jeffersonpimenta/firmware/docs/superpowers/plans/2026-07-11-irrigacao-roadmap.md

# Irrigação LoRa Mesh — Roadmap de implementação

Spec: `myfork/especificacao-irrigacao-mesh.md` (v0.1). Spec cobre múltiplos subsistemas independentes; cada fase abaixo vira um plano próprio e entrega software funcional e testável sozinho.

| Fase | Escopo (seções da spec) | Plano |
|---|---|---|
| 1 | Núcleo do protocolo + estação fail-safe: mensagens binárias no portnum privado, anti-replay, rate limit, ValveController com timer local, ACK, heartbeat, role em settings (§3.1, §3.2, §4) | `2026-07-11-irrigacao-fase1-nucleo.md` |
| 2 | Persistência NVS atômica, epoch de config, `SET_CONFIG`/`GET_CONFIG` fragmentável, regra do maior epoch, modo seguro (§5) | concluída (2026-07-12, plano 2026-07-11-irrigacao-fase2-config.md; regra do maior epoch movida p/ Fase 4 — lado gateway) |
| 3 | Pareamento, vínculo nó↔gateway, allowlist, reset de fábrica, botão multifunção, LED de status (§6, §8.6, §8.7) | concluída (2026-07-12, plano 2026-07-12-irrigacao-fase3-pareamento.md; aprovação física no gateway antecipa o painel da Fase 5; PSK de canal não é apagada no reset de fábrica — limitação até a Fase 5) |
| 4 | Gateway: registro de estações, zonas, programas/cronograma, retries de ACK, alertas (bateria, estação muda, reboots) (§5.2–§5.3, §8.1–§8.3) | concluída (2026-07-13, plano 2026-07-12-irrigacao-fase4-gateway.md; edição de zonas/programas/espelho via UI chega na Fase 5; intertravamentos na Fase 6; máquina guiada por ACK na Fase 7) |
| 5 | Painel web do gateway + captive portal de campo (LittleFS, endpoints JSON) (§7) | concluída (5a painel gateway 2026-07-15, plano 2026-07-15-irrigacao-fase5a-painel-gateway.md; 5b portal de campo 2026-07-17, plano 2026-07-17-irrigacao-fase5b-portal-no.md; aba Instalador §8.4 cortada — firmware separado) |
| 6 | Sensores, intertravamentos (global + réplica local), GPO, tamper, log de auditoria (§8.9–§8.12) | dividida em 6a/6b — **concluída**. **6a (estação)** concluída (2026-07-21, plano 2026-07-20-irrigacao-fase6a-estacao.md): settings ABI v4 (sensores/GPO/tamper/coords), SensorSampler, GpoController, AuditLog + mini-log persistente, heartbeat com bloco de sensores + envio antecipado, EV_TAMPER, endpoints/UI do portal. **6b (gateway)** concluída (2026-07-23, plano 2026-07-22-irrigacao-fase6b-gateway.md): settings ABI v5 (réplica local via blob 176B/push §5.4), InterlockEngine (veredito por zona + histerese) + InterlockTable, OpenGate (gate de admissão + fila FIFO, scheduler sequencial), FlashAuditRing persistente ~256KB (CSV/JSON export), SensorNameTable (gateway-side, não empurrado), janela de manutenção via CMD_MAINT, UI do painel (abas Sensores/GPO/Intertravamentos/Log/Tamper). Backup de config completo com PSK adiado. **Follow-up conhecido**: create de item novo no painel envia id=0 (rejeitado pelo backend) — corrigido em intertravamentos (id livre no cliente); zonas/programas têm a mesma limitação pré-existente |
| 7 | Grupos hidráulicos (máquina de estados bomba/válvulas, matriz de falhas) (§8.13) | dividida em 7a/7b. **7a (motor) concluída** (2026-07-24, spec 2026-07-24-irrigacao-fase7a-grupos-hidraulicos-design.md, plano 2026-07-24-irrigacao-fase7a-grupos-hidraulicos.md): `HydraulicGroupTable` (config + persistência LittleFS própria), `HydraulicGroupEngine` (máquina guiada por ACK: abrir/fechar sequenciado com bomba, `abrir_antes_de_fechar`/`fechar_antes_de_abrir`, min/max abertas, renovação da bomba, matriz de falhas §8.13, bridging `funcionamento_min_min`, `max_partidas_hora`→DEFERRED, grupo-sem-bomba == simultaneidade §8.10, reconciliação por heartbeat), glue no `gwTick` (roteamento de zonas agrupadas via `setDesired`, dispatch de emits, `onAck`/`onCmdFailed`/`observeActual`), `AuditOrigin::GRUPO_HIDRAULICO`. Suite nativa 54→56 (2 suites novos). Sem mudança na ABI de estação (bomba = zona gpo). **7b (painel/roteamento) concluída** (2026-07-24, spec 2026-07-24-irrigacao-fase7b-grupos-web-design.md, plano 2026-07-24-irrigacao-fase7b-grupos-web.md): endpoints `/api/irrigation/groups[/status|/delete|/command]` + aba "Grupos" do painel (CRUD + status ao vivo + controle manual abrir/fechar); validação de zona-membro (`validateGroupZones` puro: rejeita espelho `fonteInput>=0`, zona inexistente, bomba-membro); roteamento único `routeZoneToGroup` (grupo isento do cap global `IL_SIMULTANEIDADE` — Opção A; corrige open-direto-sem-bomba nos caminhos manual/portal, antes só o scheduler era group-aware); create `id=0` aloca id livre no servidor. Export/backup de grupos ADIADO p/ Fase 8. Suite nativa mantém 56 (casos novos em `test_irrigation_webapi` 43→59 e `test_hydraulic_group_engine` 13→14; `IrrigationWebEndpoints.cpp` é CI-only). **Follow-ups Minor** (hardening de teste, tidy de front) em `.superpowers/sdd/progress.md`. |
| 8 | Role SERVICO: cofre LittleFS, re-tune de canal, varredura, `RESYNC_SEQ`, import/export; survey (§8.5, §11) | dividida em 8a/8b/8c/8d (brainstorming 2026-07-25, spec `2026-07-25-irrigacao-fase8a-protocolo-parque-design.md`). **8a (pré-req de protocolo no parque) concluída** (2026-07-25, plano `2026-07-25-irrigacao-fase8a-protocolo-parque.md`, head `a93edca1c`): `FLAG_FROM_SERVICE`+`setServiceFlag`, predicado puro `senderAuthorizedBy` (SERVICE_MAGIC dispensa vínculo §11.5), codec `RESYNC_SEQ`+`PING_SURVEY`+`APP_FW_VERSION`, `senderAuthorized(from,flags)` nos 5 sítios de comando, responders `handleResyncSeq` (isento do gate anti-replay) + `handlePingSurvey` (nodeinfo mínimo, todos papéis) + dispatch. Aditivo: protocolo VERSION=1 e ABI settings v5 intactos; `SeqTable` fica RAM-only (posse-da-PSK=autoridade). Suíte nativa 865/865 GREEN (+7 casos; sem suite nova). **Banca 2+ nós exigida antes de campo** (rádio não é native-testável). Maior-epoch + last_seq per-sender de §11.9 já prontos de fases anteriores. **8b (device SERVICO núcleo) concluída** (2026-07-25, spec+plano `2026-07-25-irrigacao-fase8b-device-servico-nucleo*`, head `8e99b4fb0`, pushed): cofre LittleFS (`ServiceBackup` codec §5.5 + base64 + scanner JSON, `ServiceVault` sobre `IProfileStore`/`LittleFsProfileStore`), `ServiceController` (channelFromProfile/decideConfigRoute/needsResync/scan + orquestração planRetune/nextSeq/onResyncReply), glue no módulo (`applyRetune` re-tune+reboot espelha commitPairing, `svcEmitProbe`/`svcSendResyncRequest` com FLAG_FROM_SERVICE, intake de REPLY PING/RESYNC, botão SERVICO=export console), export §5.5 do gateway (PSK+tabelas via `gwBuildBackup`) em `GET /api/irrigation/export`+botão painel. 3 suites nativas novas (backup/vault/controller), suíte completa **897/897 GREEN**. IMPORT via portal/SD ADIADO→8c; banca 2+ nós exigida. **8c (portal do device SERVICO §11.8) concluída** (2026-07-25, spec+plano `2026-07-25-irrigacao-fase8c-portal-device*`): camada pura `ServicePortalApi` (buildClientList/parseSelect/buildScanResults/**buildStationConfig+parseStationConfig round-trip 176B** = editor de campos completo/parseNodeConfigReq/parseNodeAction/buildServiceLog) em suite nova `test_service_portal`; writer `servico.jsonl` (`IProfileStore.appendLog/logReader`, tail); accessors `svcPortal*` + endpoints CI-only `/api/portal/service/*` (clientes/select re-tune+reboot/scan/ler+gravar config/ação/log/export/import via staging FSCom); frontend 3 abas (Clientes/Rede/Log + editor). **Rota de escrita = DIRECT** (epoch+1, gateway adota via §5.4 max-epoch). **Follow-on**: VIA_GATEWAY (wire não tem config-para-estação-X via gateway) + aprovar-pareamento pelo device (falta intake device-side de PAIR_ANNOUNCE) + cartão-SD + cifra PSK. Aditivo: VERSION=1, ABI v5 intactos. `test_service_portal` 8/8 + árvore compila (Docker). Banca 2+ nós exigida. **8d (site survey §8.5) concluída** (2026-07-25, spec+plano `2026-07-25-irrigacao-fase8d-site-survey*`): beacon `PING_SURVEY` kind=2 (aditivo, VERSION=1/ABI v5 intactos — sem tipo de wire novo), `SurveyBeacon` (intervalo+auto-expiração) + `SurveyLog` (ring RAM 32) puros + `buildSurvey`/`parseSurveyStart`; glue no módulo (tick emite beacon; gateway loga kind=2 com SNR/RSSI+coord; nós não respondem a kind=2 → sem tempestade de airtime); endpoints CI-only `/api/irrigation/survey[/clear]` (painel) + `/api/portal[/service]/survey/{start,stop}` (beacon iniciado pelo portal do nó §7.2 **e** portal SERVICO §11.8); frontend aba "Cobertura" (painel: tabela do log ao vivo) + controle iniciar/parar (portal). Log = RAM transiente; coordenada digitada/opcional. Suíte nativa 60→62 (`test_survey_beacon`/`test_survey_log` + casos em `test_irrigation_webapi`), completa GREEN. **Banca 2+ nós exigida antes de campo** (beacon/log por rádio não é native-testável). **Fase 8 COMPLETA.** §8.4 instalador cortado; modo híbrido 24VAC já em `MirrorMode` (Fase 4) |
| 9 | Particionamento de flash p/ OTA nas variants alvo (§3.3) | futuro |

Regras globais da spec que valem em todas as fases: teto absoluto de abertura 120 min compilado; fail-safe local sempre; payload ≤ ~200 bytes; versão de protocolo em toda mensagem; mismatch = rejeição segura.

Referencia de UI (Fase 5): mockup do painel/portal em `myfork/Irrigacao Mobile.dc.html` (design doc HTML, 2026-07-11) - base visual das telas do painel web e captive portal.

Requisito reforçado pelo usuário (2026-07-11) — modo híbrido/espelho (§5.2 `fonte`): o sistema deve poder operar SOMENTE espelhando as entradas físicas de um controlador externo (réplica das saídas 24VAC lidas por optoacoplador), sem cronograma próprio. Isso deve ser configurável por entrada, incluindo a polaridade do estado ativo (active-high / active-low). Entra na Fase 4 (gateway/zonas) e no pin map da Fase 2 (campo de polaridade por entrada física).

Requisito reforçado pelo usuário (2026-07-12) — modo espelhamento (§5.2 `fonte`, Fase 4): quando ativo, TODA configuração e TODOS os intertravamentos são bypassados — a estação escrava replica cegamente o estado da entrada do mestre. O bypass é configurável pela UI; a UI também permite associar cada entrada do mestre (gateway híbrido, opto 24VAC) a qualquer saída de qualquer escravo (mapeamento entrada→(nó,saída) via dropdown). Polaridade ativo-alto/baixo por entrada (requisito 2026-07-11) continua valendo. Nota de engenharia: o teto fail-safe de 120 min compilado (§4.2) permanece mesmo em espelhamento, salvo decisão explícita do usuário em contrário — a renovação periódica do comando cobre acionamentos longos.

Requisito do usuário (2026-07-12) — exportar chave da fazenda: função de visualizar a PSK do canal primário (base64 + nome do canal) para cadastro no cofre do device de serviço (§11.2). Fase 3: pressão longa no botão do gateway despeja no console serial. Fase 5: mesma função exposta no painel web (com PIN).

Feature adicional (2026-07-30) — **controle de nível por boia (enchimento automático)**: uma boia (sensor digital) num nó controla a partida/parada de um motor/bomba (uma zona) em outro nó ou no GPO do gateway. Aditiva pós-Fase 8 (spec `2026-07-30-irrigacao-controle-nivel-boia-design.md`, plano `2026-07-30-irrigacao-controle-nivel-boia.md`). Nova peça = ação **positiva** (liga quando nível baixo) que o intertravamento — só negativo (bloquear/fechar) — não fazia. Abordagem A: `LevelControlTable` (config + persistência LittleFS própria `irrigation_niveis.dat`) + `LevelControlEngine` puro (máquina start/stop/renew/stale, histerese por tempo minOn/minOff, 1 boia) no gateway, dirigindo o `routeZoneToGroup`/`gwDriveZone` existente (herda sequência de bomba, veto de intertravamento, `max_partidas_hora`). Fail-safe: boia muda > `staleTimeoutS` → desliga + alerta `NIVEL_BOIA_MUDA`; teto 120 min sempre corta; RENEW (60 s) mantém vivo só enquanto quer-encher **e** boia fresca. Codec web + endpoints CI-only `/api/irrigation/levels[/delete]` + aba "Nível" no painel; regras no backup §5.5 (`niveisJson`). Aditivo total: protocolo VERSION=1, ABI settings v5 (176 B) intactos, sem novo tipo de wire; enums append-only `AuditOrigin::NIVEL`/`AlertType::NIVEL_BOIA_MUDA`. 2 suites nativas novas (`test_level_control_table`/`test_level_control`), `native-suite-count` 62→64. **Banca 2+ nós exigida antes de campo** (boia-nó→gateway→bomba-nó, frescor real e endpoints CI/banca-only não são native-testáveis). Fora de escopo (YAGNI): 2 boias / sensor analógico com 2 limiares, modo esvaziar/drenar, controle local sem gateway, cifra PSK. Follow-ups em `.superpowers/sdd/progress.md`.

Feature adicional (2026-08-08) — **Modo Remoto (botoeira → saída remota + LED)**: uma botoeira (botão momentâneo numa entrada digital) no gateway **ou** em qualquer nó aciona (toggle-latch) uma saída em outro nó/gateway; múltiplas botoeiras em múltiplos nós podem controlar a mesma saída; LEDs dedicados dão feedback no nó da botoeira (pisca ao transmitir → fixo ao confirmar → apaga em falha, **e** acende sempre que a saída está ativa por qualquer origem — estado compartilhado). Spec `2026-08-08-irrigacao-modo-remoto-design.md`, plano `2026-08-08-irrigacao-modo-remoto.md` (11 tasks, subagent-driven). Arquitetura **gateway-central**: associações em `RemoteButtonTable` (flash própria `irrigation-remote.dat`, editada no painel); estação detecta borda+debounce (`RemoteButtonEdge`) → **`MSG_REMOTE_TRIGGER`** (14) → gateway resolve o toggle lendo o estado REAL do atuador (`gwZoneIsOpen`: driver local `valves.isOpen`/`gpos.isOn` / `StationTelemetry.valveStates|gpoStates` / grupo) e aciona via `gwSendValveCmd` (herda fail-safe/intertravamento/grupo/local+remoto); gateway empurra **`MSG_REMOTE_LED`** (15) change-driven → `RemoteLedFsm` no nó (todos os papéis dirigem `pinsRemoteLed[2]`). Botoeira local do gateway roda em processo. **ABI settings v6→v7** (append-only 180→184: `pinsRemoteLed[2]`+`digitalInBtnMask`+`digitalInLedIdx`; `StationEntry.blob` 180→184, `STATION_ENTRY` 215→219). Protocolo VERSION=1 (msgs 14/15 aditivas). Config de botão/LED por estação é derivada das associações e empurrada via `SET_CONFIG` (§5.4); self-node grava nos settings do próprio gateway. Auth = anti-replay+`senderAuthorizedBy` no TRIGGER (fire-and-forget, sem ACK); REMOTE_LED idempotente filtrado por `boundGateway`. Backup §5.5 inclui `remoteButtons`. Endpoints CI-only `/api/irrigation/remote[/delete|/command]` + aba "Modo Remoto" em "Mais" (dedup por saída no card de teste, LED por gatilho, sem pill global — fiel ao mockup `Irrigacao Mobile.dc.html` com esses refinamentos). 2 suites nativas novas (`test_remote_button_table`/`test_remote_button`), `native-suite-count` 69→71; **suíte completa 1024/1024 GREEN + build nativo SUCCESS** (Docker). **Banca 2+ nós EXIGIDA antes de campo** (trigger/LED/toggle por rádio + shared-state não são native-testáveis) + **build ESP32 no CI** (endpoints webserver-guarded + pinos de LED no variant). Fora de escopo (YAGNI): momentâneo on-while-held, duração por associação, peer-to-peer sem gateway, cifra PSK. Follow-ups Minor em `.superpowers/sdd/progress.md`.
