jeffersonpimenta/firmware/docs/superpowers/plans/2026-08-16-irrigacao-ota-ble-local.md

# OTA local por contato (BLE-via-app) — Implementation Plan

> **For agentic workers:** REQUIRED SUB-SKILL: Use superpowers:subagent-driven-development (recommended) or superpowers:executing-plans to implement this plan task-by-task. Steps use checkbox (`- [ ]`) syntax for tracking.

**Goal:** habilitar OTA local por contato (loader BLE stock do Meshtastic) no portal do nó, com gate de segurança que impede atualizar durante ciclo de irrigação ativo.
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
