jeffersonpimenta/firmware/hardware/Irrigacao_mesh/Irrigacao_mesh.kicad_pcb

## KiCad design hardware/Irrigacao_mesh/Irrigacao_mesh.kicad_pcb (2026-09-10)

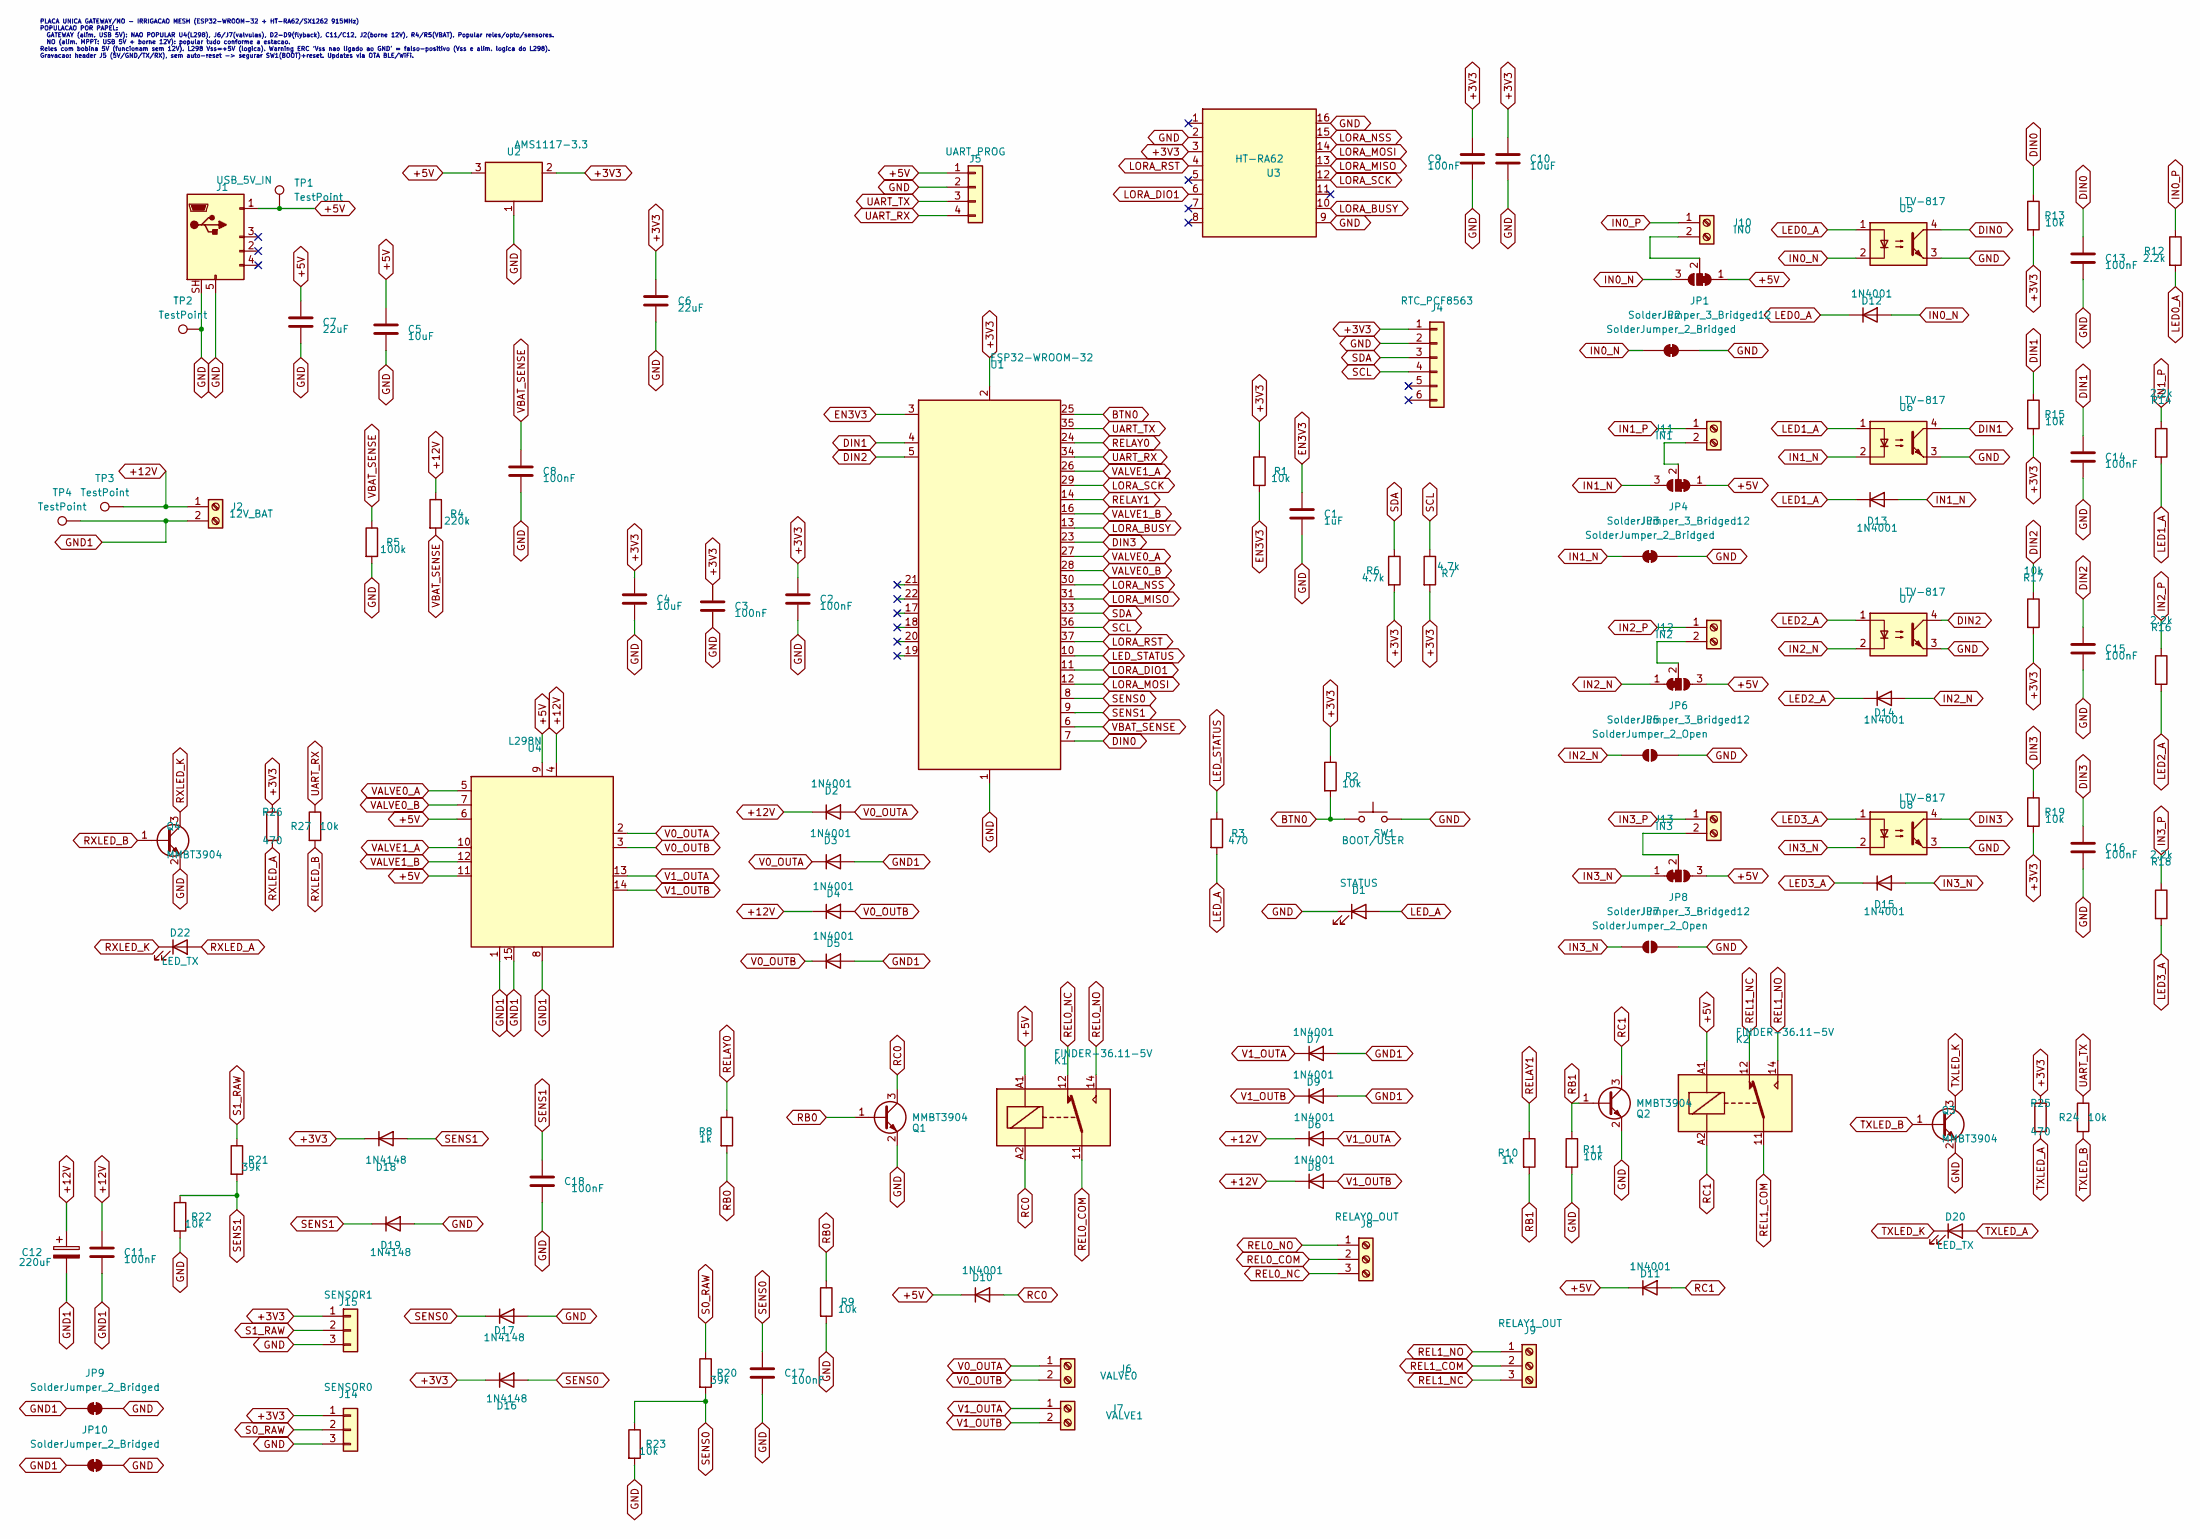
[picture p1: schematic Irrigacao_mesh.kicad_sch]

Parts:
C1: 1uF; C_0805_2012Metric
C2, C3, C8, C9, C11, C13, C14, C15, C16, C17, C18: 100nF; C_0805_2012Metric
C4, C5, C10: 10uF; C_0805_2012Metric
C6: 22uF; C_0805_2012Metric
C7: 22uF; C_0805_2012Metric; Voltage 25V; LCSC C45783
C12: 220uF; CP_Elec_8x10.5; Voltage 25V; LCSC C129421
D1: STATUS; LED_0805_2012Metric
D2, D3, D4, D5, D6, D7, D8, D9, D10, D11, D12, D13, D14, D15: 1N4001; D_SMA
D16, D17, D18, D19: 1N4148; D_SOD-123
D20, D22: LED_TX; LED_0805_2012Metric
J1: USB_5V_IN; USB_Micro-B_Molex-105017-0001
J2: 12V_BAT; TerminalBlock_MaiXu_MX126-5.0-02P_1x02_P5.00mm
J4: RTC_PCF8563; PinHeader_1x06_P2.54mm_Vertical
J5: UART_PROG; PinHeader_1x04_P2.54mm_Vertical
J6: VALVE0; TerminalBlock_MaiXu_MX126-5.0-02P_1x02_P5.00mm
J7: VALVE1; TerminalBlock_MaiXu_MX126-5.0-02P_1x02_P5.00mm
J8: RELAY0_OUT; TerminalBlock_MaiXu_MX126-5.0-03P_1x03_P5.00mm
J9: RELAY1_OUT; TerminalBlock_MaiXu_MX126-5.0-03P_1x03_P5.00mm
J10: IN0; TerminalBlock_MaiXu_MX126-5.0-02P_1x02_P5.00mm
J11: IN1; TerminalBlock_MaiXu_MX126-5.0-02P_1x02_P5.00mm
J12: IN2; TerminalBlock_MaiXu_MX126-5.0-02P_1x02_P5.00mm
J13: IN3; TerminalBlock_MaiXu_MX126-5.0-02P_1x02_P5.00mm
J14: SENSOR0; PinHeader_1x03_P2.54mm_Vertical
J15: SENSOR1; PinHeader_1x03_P2.54mm_Vertical
JP1, JP4, JP6, JP8: SolderJumper_3_Bridged12; SolderJumper-3_P1.3mm_Bridged12_Pad1.0x1.5mm_NumberLabels
JP2, JP3, JP9, JP10: SolderJumper_2_Bridged; SolderJumper-2_P1.3mm_Bridged_Pad1.0x1.5mm
JP5, JP7: SolderJumper_2_Open; SolderJumper-2_P1.3mm_Open_Pad1.0x1.5mm
K1, K2: FINDER-36.11-5V; Relay_SPDT_Finder_36.11
Q1, Q2, Q3, Q4: MMBT3904; SOT-23
R1, R2, R9, R11, R13, R15, R17, R19, R22, R23, R24, R27: 10k; R_0805_2012Metric
R3, R25, R26: 470; R_0805_2012Metric
R4: 220k; R_0805_2012Metric
R5: 100k; R_0805_2012Metric
R6, R7: 4.7k; R_0805_2012Metric
R8, R10: 1k; R_0805_2012Metric
R12, R14, R16, R18: 2.2k; R_0805_2012Metric
R20, R21: 39k; R_0603_1608Metric
SW1: BOOT/USER; SW_Push_1P1T_XKB_TS-1187A
TP1, TP2, TP3, TP4: TestPoint; TestPoint_Pad_D4.0mm
U1: ESP32-WROOM-32
U2: AMS1117-3.3; SOT-223-3_TabPin2
U3: HT-RA62
U4: L298N; TO-220-15_P2.54x5.08mm_StaggerOdd_Lead4.58mm_Vertical
U5, U6, U7, U8: LTV-817; SMDIP-4_W7.62mm

Connections:
+3V3: C2.1, C3.1, C4.1, C6.1, C9.1, C10.1, D16.1 (K), D18.1 (K), J4.1, J14.1, J15.1, R1.1, R2.1, R6.2, R7.2, R13.2, R15.2, R17.2, R19.2, R25.1, R26.1, U1.2 (VDD), U2.2 (VO), U3.3 (3V3)
+5V: C5.1, C7.1, D10.1 (K), D11.1 (K), J1.1 (VBUS), J5.1, JP1.1 (A), JP4.1 (A), JP6.3 (B), JP8.3 (B), K1.A1, K2.A1, TP1.1 (1_1), U2.3 (VI), U4.6 (EnA), U4.9 (Vss), U4.11 (EnB)
+12V: C11.1, C12.1, D2.1 (K), D4.1 (K), D6.1 (K), D8.1 (K), J2.1, R4.1, TP3.1 (1_1), U4.4 (Vs)
BTN0: R2.2, SW1.1, U1.25 (IO0)
DIN0: C13.1, R13.1, U1.7 (IO35), U5.4
DIN1: C14.1, R15.1, U1.4 (SENSOR_VP), U6.4
DIN2: C15.1, R17.1, U1.5 (SENSOR_VN), U7.4
DIN3: C16.1, R19.1, U1.23 (IO15), U8.4
EN3V3: C1.1, R1.2, U1.3 (EN)
GND: C1.2, C2.2, C3.2, C4.2, C5.2, C6.2, C7.2, C8.2, C9.2, C10.2, C13.2, C14.2, C15.2, C16.2, C17.2, C18.2, D1.1 (K), D17.2 (A), D19.2 (A), J1.5 (GND), J1.SH (Shield), J4.2, J5.2, J14.3, J15.3, JP2.2 (B), JP3.2 (B), JP5.2 (B), JP7.2 (B), JP9.2 (B), JP10.2 (B), Q1.2 (E), Q2.2 (E), Q3.2 (E), Q4.2 (E), R5.2, R9.2, R11.2, R22.2, R23.2, SW1.2, TP2.1 (1_1), U1.1 (GND), U1.15 (GND), U1.38 (GND), U1.39 (GND), U2.1 (GND), U3.2 (GND), U3.9 (GND), U3.16 (GND), U5.3, U6.3, U7.3, U8.3
GND1: C11.2, C12.2, D3.2 (A), D5.2 (A), D7.2 (A), D9.2 (A), J2.2, JP9.1 (A), JP10.1 (A), TP4.1 (1_1), U4.1 (SENSE_A), U4.8 (GND), U4.15 (SENSE_B)
IN0_N: D12.2 (A), JP1.3 (B), JP2.1 (A), U5.2
IN0_P: J10.1, R12.1
IN1_N: D13.2 (A), JP3.1 (A), JP4.3 (B), U6.2
IN1_P: J11.1, R14.1
IN2_N: D14.2 (A), JP5.1 (A), JP6.1 (A), U7.2
IN2_P: J12.1, R16.1
IN3_N: D15.2 (A), JP7.1 (A), JP8.1 (A), U8.2
IN3_P: J13.1, R18.1
LED0_A: D12.1 (K), R12.2, U5.1
LED1_A: D13.1 (K), R14.2, U6.1
LED2_A: D14.1 (K), R16.2, U7.1
LED3_A: D15.1 (K), R18.2, U8.1
LED_A: D1.2 (A), R3.2
LED_STATUS: R3.1, U1.10 (IO25)
LORA_BUSY: U1.13 (IO14), U3.10 (BUSY)
LORA_DIO1: U1.11 (IO26), U3.6 (DIO1)
LORA_MISO: U1.31 (IO19), U3.13 (MISO)
LORA_MOSI: U1.12 (IO27), U3.14 (MOSI)
LORA_NSS: U1.30 (IO18), U3.15 (NSS)
LORA_RST: U1.37 (IO23), U3.4 (RST)
LORA_SCK: U1.29 (IO5), U3.12 (SCK)
unnamed: J10.2, JP1.2 (C)
unnamed: J11.2, JP4.2 (C)
unnamed: J12.2, JP6.2 (C)
unnamed: J13.2, JP8.2 (C)
RB0: Q1.1 (B), R8.2, R9.1
RB1: Q2.1 (B), R10.2, R11.1
RC0: D10.2 (A), K1.A2, Q1.3 (C)
RC1: D11.2 (A), K2.A2, Q2.3 (C)
REL0_COM: J8.2, K1.11
REL0_NC: J8.3, K1.12
REL0_NO: J8.1, K1.14
REL1_COM: J9.2, K2.11
REL1_NC: J9.3, K2.12
REL1_NO: J9.1, K2.14
RELAY0: R8.1, U1.24 (IO2)
RELAY1: R10.1, U1.14 (IO12)
RXLED_A: D22.2 (A), R26.2
RXLED_B: Q4.1 (B), R27.2
RXLED_K: D22.1 (K), Q4.3 (C)
S0_RAW: J14.2, R20.1
S1_RAW: J15.2, R21.1
SCL: J4.4, R7.1, U1.36 (IO22)
SDA: J4.3, R6.1, U1.33 (IO21)
SENS0: C17.1, D16.2 (A), D17.1 (K), R20.2, R23.1, U1.8 (IO32)
SENS1: C18.1, D18.2 (A), D19.1 (K), R21.2, R22.1, U1.9 (IO33)
TXLED_A: D20.2 (A), R25.2
TXLED_B: Q3.1 (B), R24.2
TXLED_K: D20.1 (K), Q3.3 (C)
UART_RX: J5.4, R27.1, U1.34 (RXD0/IO3)
UART_TX: J5.3, R24.1, U1.35 (TXD0/IO1)
V0_OUTA: D2.2 (A), D3.1 (K), J6.1, U4.2 (OUT1)
V0_OUTB: D4.2 (A), D5.1 (K), J6.2, U4.3 (OUT2)
V1_OUTA: D6.2 (A), D7.1 (K), J7.1, U4.13 (OUT3)
V1_OUTB: D8.2 (A), D9.1 (K), J7.2, U4.14 (OUT4)
VALVE0_A: U1.27 (IO16), U4.5 (IN1)
VALVE0_B: U1.28 (IO17), U4.7 (IN2)
VALVE1_A: U1.26 (IO4), U4.10 (IN3)
VALVE1_B: U1.16 (IO13), U4.12 (IN4)
VBAT_SENSE: C8.1, R4.2, R5.1, U1.6 (IO34)

Notes on the sheet:
PLACA UNICA GATEWAY/NO - IRRIGACAO MESH (ESP32-WROOM-32 + HT-RA62/SX1262 915MHz) POPULACAO POR PAPEL: GATEWAY (alim. USB 5V): NAO POPULAR U4(L298), J6/J7(valvulas), D2-D9(flyback), C11/C12, J2(borne 12V), R4/R5(VBAT). Popular reles/opto/sensores. NO (alim. MPPT: USB 5V + borne 12V): popular tudo co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

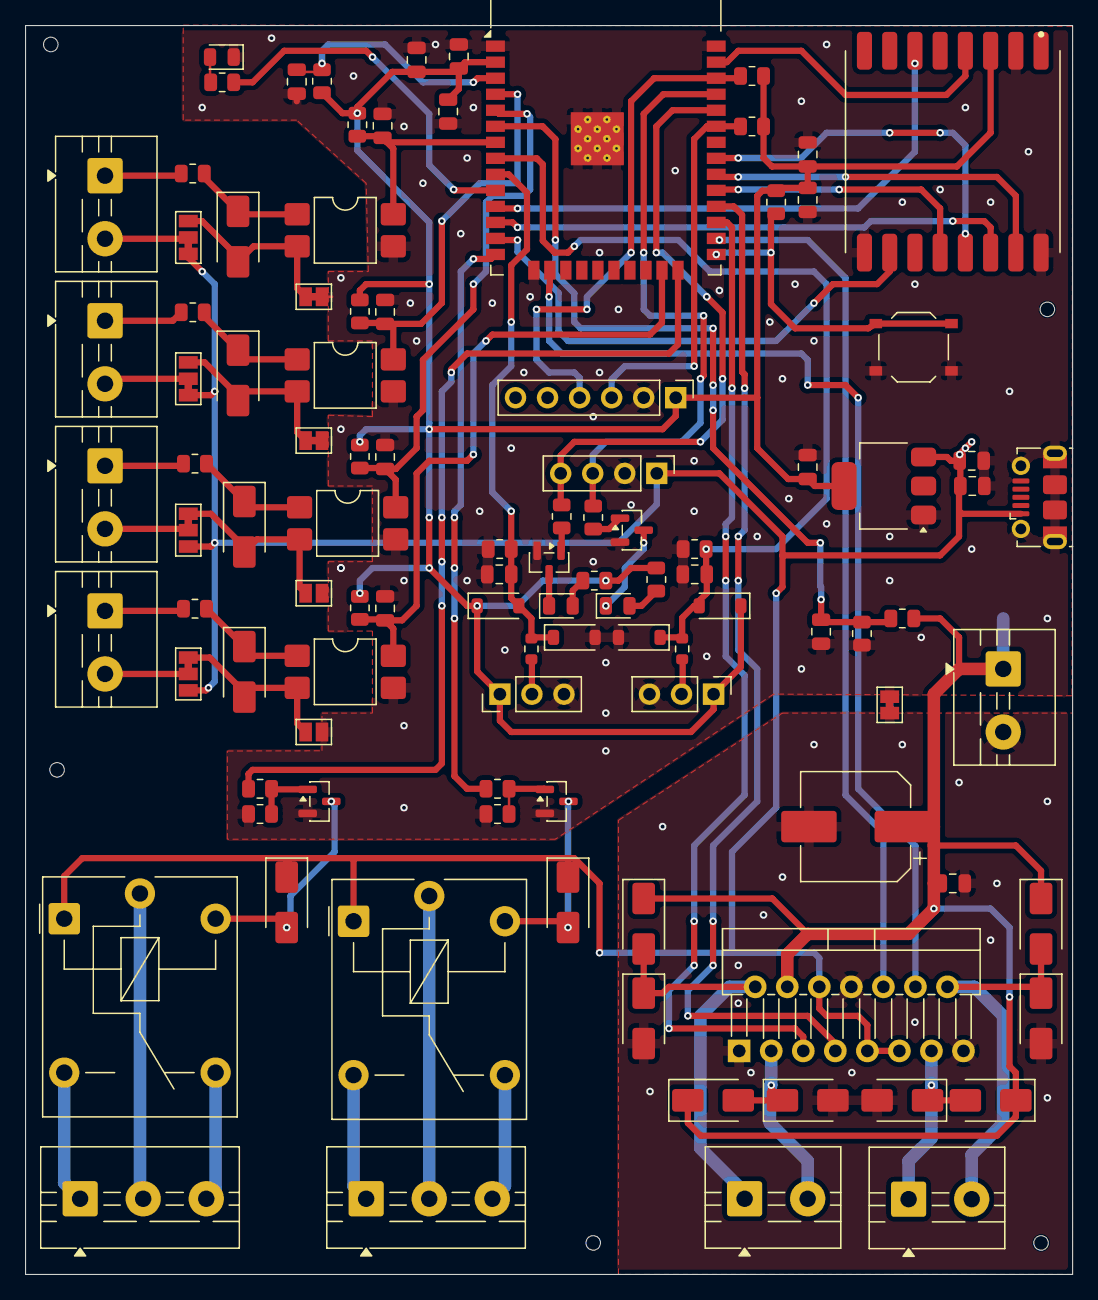
[picture p2: board Irrigacao_mesh.kicad_pcb from above]

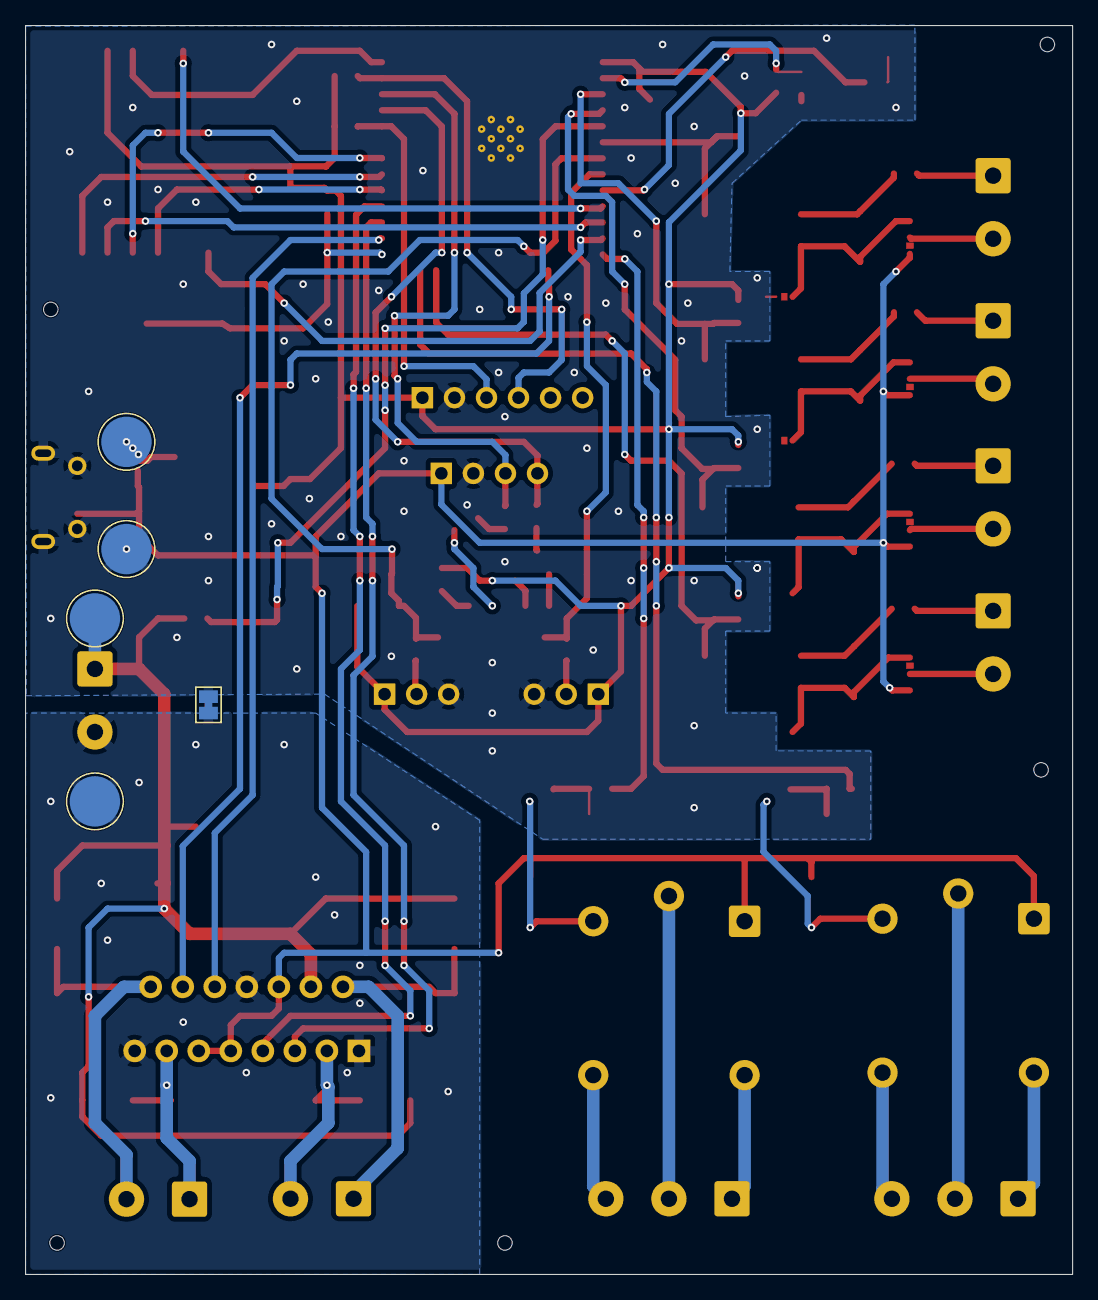
[picture p3: board Irrigacao_mesh.kicad_pcb from below]

Board: 2 copper layers, 83.0 x 99.0 mm, 109 parts (5 on the bottom side), 71 nets.
