jeffersonpimenta/firmware/src/modules/irrigation/IrrigationSettings.h

#pragma once
#include <cstddef>
#include <stdint.h>

enum class IrrigationRole : uint8_t { ESTACAO = 0, GATEWAY = 1, REPETIDOR = 2, SERVICO = 3 };

// Layout do blob on-disk/radio (208 bytes, ABI-locked v8):
//   0  magic(4) | 4  version(2) | 6  role(1) | 7  numValves(1)
//   8  boundGateway(4) | 12 hbMinutes(2) | 14 vbatMinAbrirCentiV(2) | 16 maxOpenConfigS(2)
//  18  cmdRatePerMin(1) | 19 pad0(1) | 20 pulseMs(2)
//  22  pinsHbridgeA[8] | 30 pinsHbridgeB[8] | 38 pad1[2]
//  40  configEpoch(4) | 44 pinsDigitalIn[4] | 48 digitalInActiveLow(1) | 49 pinBtn(1) | 50 pinLed(1) | 51 pad2(1)
// --- v4 (Fase 6a) ---
//  52  pinsGpo[2](2) | 54 pinTamper(1) | 55 hwFlags(1)
//  56  latE7(4) | 60 lonE7(4)
//  64  sensores[4]×16(64)
// --- v5 (Fase 6b) ---
// 128  localInterlocks[4]×12(48)
// --- v6 (Fase 9) ---
// 176  vbatAvisoCentiV(2) | 178 vbatCriticaCentiV(2)
// --- v7 (Modo Remoto) ---
// 180  pinsRemoteLed[2](2) | 182 digitalInBtnMask(1) | 183 digitalInLedIdx(1)
// --- v8 (P2P fallback) --- 184 btnFallbackNode[4](16) | 200 btnFallbackOutId[4](4) | 204 remoteFallbackMs(2) | 206 btnFallbackKind(1) | 207 pad3(1) → 208
// Total = 208.
struct IrrigationSettings {
    static constexpr uint32_t MAGIC = 0x49525231; // "IRR1"
    static constexpr uint8_t MAX_VALVES = 8;
    static constexpr uint8_t MAX_DIGITAL_IN = 4;

    uint32_t magic = MAGIC;
    uint16_t version = 8;
    uint8_t role = (uint8_t)IrrigationRole::ESTACAO;
    uint8_t numValves = 2;
    uint32_t boundGateway = 0; // 0 = não pareado
    uint16_t hbMinutes = 10;
    uint16_t vbatMinAbrirCentiV = 1180; // 11,8 V (spec §8.1)
    uint16_t maxOpenConfigS = 0;        // 0 = só o teto compilado limita
    uint8_t cmdRatePerMin = 10;
    uint8_t pad0 = 0;   // explicit padding at offset 19 (between cmdRatePerMin and pulseMs)
    uint16_t pulseMs = 60;
    int8_t pinsHbridgeA[MAX_VALVES] = {-1, -1, -1, -1, -1, -1, -1, -1};
    int8_t pinsHbridgeB[MAX_VALVES] = {-1, -1, -1, -1, -1, -1, -1, -1};
    uint8_t pad1[2] = {0, 0}; // explicit padding at offsets 38-39 (after pinsHbridgeB)
    // v2:
    uint32_t configEpoch = 0;                        // spec §5.4
    int8_t pinsDigitalIn[MAX_DIGITAL_IN] = {-1, -1, -1, -1};
    uint8_t digitalInActiveLow = 0; // bitmask: bit i = entrada i ativo-baixo (polaridade configurável)
    // v3:
    int8_t pinBtn = -1;   // botão multifunção (§8.6); -1 = ausente
    int8_t pinLed = -1;   // LED de status (§8.7); -1 = ausente
    uint8_t pad2 = 0;    // explicit padding at offset 51 (end of v3 prefix)

    // v4 (Fase 6a):
    static constexpr uint8_t MAX_GPO = 2;
    static constexpr uint8_t MAX_SENSORS = 4;

    struct SensorSlot {
        int8_t pino = -1;        // -1 = slot vazio
        uint8_t tipo = 0;        // 0 = digital, 1 = analógico
        uint8_t flags = 0;       // bit0 = ativo-baixo (digital)
        uint8_t amostragemS = 0; // analógico; 0 → default 30
        uint16_t debounceMs = 0; // digital; 0 → default 200
        uint16_t adcMin = 0;     // calibração 2 pontos (analógico)
        uint16_t adcMax = 4095;
        int16_t engMin = 0;      // centi-unidades (1000 = 10,00)
        int16_t engMax = 0;
        uint8_t unidade = 0;     // 0 raw, 1 bar, 2 %, 3 m, 4 °C
        uint8_t pad = 0;
    };

    int8_t pinsGpo[MAX_GPO] = {-1, -1}; // saídas de nível (§8.11)
    int8_t pinTamper = -1;              // §8.12; -1 desativa
    uint8_t hwFlags = 0;                // bit0 = tamper ativo-baixo
    int32_t latE7 = 0;                  // coordenadas locais ×1e-7 (§8.8)
    int32_t lonE7 = 0;
    SensorSlot sensores[MAX_SENSORS];

    // v5 (Fase 6b): réplica local de intertravamentos (§8.10).
    static constexpr uint8_t MAX_LOCAL_INTERLOCKS = 4;
    struct LocalInterlock {
        uint8_t sensorIdx = 0;        // 0..3 (sensor local)
        uint8_t condicao = 0;         // InterlockCond (0=ATIVO,1=INATIVO,2=MENOR_QUE,3=MAIOR_QUE)
        uint8_t acao = 0;             // InterlockAcao (0=BLOQUEAR_ABERTURA,1=FECHAR_E_BLOQUEAR)
        uint8_t saidasValvMask = 0;   // bits = índices de válvula locais a fechar+bloquear
        int32_t valorCenti = 0;
        uint16_t histereseCenti = 0;
        uint8_t saidasGpoMask = 0;    // bits = índices de GPO locais a fechar+bloquear
        uint8_t pad = 0;
        // slot inativo quando saidasValvMask==0 && saidasGpoMask==0
    };
    LocalInterlock localInterlocks[MAX_LOCAL_INTERLOCKS];

    // v6 (Fase 9): limiares de bateria por-estação (centi-volt), avaliados gateway-side
    // (StationMonitor) e disponíveis ao nó para auto-avaliação futura. Apêndice no FIM
    // para preservar todos os offsets v5.
    uint16_t vbatAvisoCentiV = 1220;   // default = StationMonitor::AVISO_CV
    uint16_t vbatCriticaCentiV = 1180; // default = StationMonitor::CRITICO_CV

    // v7 (Modo Remoto): pinos de LED dedicados + papéis de entrada digital.
    // Apêndice no FIM — offsets v6 preservados.
    int8_t pinsRemoteLed[2] = {-1, -1}; // 2 LEDs dedicados de feedback (§modo remoto)
    uint8_t digitalInBtnMask = 0;       // bit i = entrada digital i é botoeira
    uint8_t digitalInLedIdx = 0xFF;     // 2 bits por entrada (0..3): slot de LED 0/1, 3=nenhum; default=tudo nenhum

    // v8 (Modo Remoto P2P fallback): rota direta por entrada-botão, auto-compilada
    // pelo gateway; usada quando o gateway não confirma o gatilho a tempo. Apêndice no FIM.
    uint32_t btnFallbackNode[MAX_DIGITAL_IN] = {0, 0, 0, 0}; // 0 = sem fallback
    uint8_t btnFallbackOutId[MAX_DIGITAL_IN] = {0, 0, 0, 0};  // id local da saída no nó alvo
    uint16_t remoteFallbackMs = 0;  // T_FALLBACK; 0 => default compilado (REMOTE_FALLBACK_DEFAULT_MS)
    uint8_t btnFallbackKind = 0xFF; // 2 bits/entrada: 0=válvula,1=GPO,3=nenhum (default tudo nenhum)
    // v8+ (reuso de pad @207, ABI preservada): bits de tráfego de airtime.
    // Semântica INVERTIDA (0 = habilitado) p/ blobs antigos (pad3=0) já significarem tudo ON.
    static constexpr uint8_t HBFLAG_DISABLE_BACKOFF = 1 << 0;
    static constexpr uint8_t HBFLAG_DISABLE_JITTER = 1 << 1;
    uint8_t hbTrafficFlags = 0; // @207 — reuso do antigo pad3
    bool hbBackoffEnabled() const { return (hbTrafficFlags & HBFLAG_DISABLE_BACKOFF) == 0; }
    bool hbJitterEnabled() const { return (hbTrafficFlags & HBFLAG_DISABLE_JITTER) == 0; }
};

static constexpr size_t IRRIGATION_SETTINGS_V1_SIZE = 40;
static constexpr size_t IRRIGATION_SETTINGS_V3_SIZE = 52;
static constexpr size_t IRRIGATION_SETTINGS_V4_SIZE = 128;
static constexpr size_t IRRIGATION_SETTINGS_V5_SIZE = 176;
static constexpr size_t IRRIGATION_SETTINGS_V6_SIZE = 180;
static constexpr size_t IRRIGATION_SETTINGS_V7_SIZE = 184;
static_assert(sizeof(IrrigationSettings::SensorSlot) == 16, "SensorSlot é ABI on-disk");
static_assert(sizeof(IrrigationSettings::LocalInterlock) == 12, "LocalInterlock é ABI on-disk");
static_assert(offsetof(IrrigationSettings, localInterlocks) == 128, "ABI v5");

// ABI lock v8: prefixo v7 (184 B) + btnFallbackNode[4](16) + btnFallbackOutId[4](4) +
// remoteFallbackMs(2) + btnFallbackKind(1) + hbTrafficFlags(1) = 208.
// Prefixo v7 = prefixo v6 (180 B) + pinsRemoteLed[2](2) + digitalInBtnMask(1) + digitalInLedIdx(1) = 184.
// Prefixo v6 = prefixo v5 (176 B) + vbatAvisoCentiV(2) + vbatCriticaCentiV(2) = 180.
// Prefixo v5 = prefixo v4 (128 B) + localInterlocks[4×12](48) = 176.
// Prefixo v4: magic(4)+version(2)+role(1)+numValves(1)+boundGateway(4)+hbMinutes(2)+
// vbatMinAbrirCentiV(2)+maxOpenConfigS(2)+cmdRatePerMin(1)+pad0(1)+pulseMs(2)+
// pinsHbridgeA(8)+pinsHbridgeB(8)+pad1(2)+configEpoch(4)+pinsDigitalIn(4)+
// digitalInActiveLow(1)+pinBtn(1)+pinLed(1)+pad2(1)+pinsGpo(2)+pinTamper(1)+hwFlags(1)+
// latE7(4)+lonE7(4)+sensores[4×16](64) = 128. All padding explicit and zero-initialized.
// Bump version AND these asserts on any layout change.
static_assert(offsetof(IrrigationSettings, vbatAvisoCentiV) == 176, "ABI v6");
static_assert(offsetof(IrrigationSettings, vbatCriticaCentiV) == 178, "ABI v6");
static_assert(offsetof(IrrigationSettings, pinsRemoteLed) == 180, "ABI v7");
static_assert(offsetof(IrrigationSettings, digitalInBtnMask) == 182, "ABI v7");
static_assert(offsetof(IrrigationSettings, digitalInLedIdx) == 183, "ABI v7");
static_assert(offsetof(IrrigationSettings, btnFallbackNode) == 184, "ABI v8");
static_assert(offsetof(IrrigationSettings, btnFallbackOutId) == 200, "ABI v8");
static_assert(offsetof(IrrigationSettings, remoteFallbackMs) == 204, "ABI v8");
static_assert(offsetof(IrrigationSettings, btnFallbackKind) == 206, "ABI v8");
static_assert(sizeof(IrrigationSettings) == 208, "on-disk settings format is ABI-dependent; bump version on layout change");

// Pino de offsets do apêndice v4: drift silencioso de layout vira erro de compilação.
static_assert(offsetof(IrrigationSettings, pinsGpo) == 52, "ABI v4");
static_assert(offsetof(IrrigationSettings, pinTamper) == 54, "ABI v4");
static_assert(offsetof(IrrigationSettings, hwFlags) == 55, "ABI v4");
static_assert(offsetof(IrrigationSettings, latE7) == 56, "ABI v4");
static_assert(offsetof(IrrigationSettings, lonE7) == 60, "ABI v4");
static_assert(offsetof(IrrigationSettings, sensores) == 64, "ABI v4");

// Helpers puros para campos v7 de entrada digital.
// Retorna true se a entrada digital i é botoeira (bit i de digitalInBtnMask).
inline bool digitalInIsButton(const IrrigationSettings &s, uint8_t i)
{
    return i < IrrigationSettings::MAX_DIGITAL_IN && ((s.digitalInBtnMask >> i) & 1u);
}
// Retorna 0 ou 1 (slot de LED) ou 3 (nenhum).
inline uint8_t digitalInLedSlot(const IrrigationSettings &s, uint8_t i)
{
    return (uint8_t)((s.digitalInLedIdx >> (2u * i)) & 0x3u);
}

constexpr uint16_t REMOTE_FALLBACK_DEFAULT_MS = 5000; // 5 s (T_FALLBACK, decisão do usuário)
inline uint8_t btnFallbackKindOf(const IrrigationSettings &s, uint8_t i)
{
    return (uint8_t)((s.btnFallbackKind >> (2u * i)) & 0x3u);
}

// Blob v1, v2, v3, v4, v5, v6, v7 ou v8 → struct v8. false = magic/versão/tamanho inválido (out fica intacto).
bool migrateIrrigationSettings(const uint8_t *raw, size_t n, IrrigationSettings &out);

// false = arquivo ausente/corrompido; `s` fica com os defaults acima.
bool loadIrrigationSettings(IrrigationSettings &s);
bool saveIrrigationSettings(const IrrigationSettings &s);
