jeffersonpimenta/firmware/src/modules/irrigation/IrrigationModule.cpp

#include "modules/irrigation/IrrigationModule.h"
#include "FSCommon.h"
#include "airtime.h"
#include "modules/irrigation/IrrigationAirtime.h"
#include "modules/irrigation/AccessWindowPolicy.h"
#include "modules/irrigation/IrrigationWebApi.h"
#include "modules/irrigation/PortalApi.h"
#include "modules/irrigation/WeatherEngine.h"
#if defined(ARCH_ESP32) && !MESHTASTIC_EXCLUDE_WEBSERVER
#include "modules/irrigation/PortalAp.h"
#endif
#if defined(ARCH_ESP32)
#include "platform/esp32/MeshtasticOTA.h"
#endif
#include "MeshService.h"
#include "MeshTypes.h"
#include "NodeDB.h"
#include "PowerStatus.h"
#include "Throttle.h"
#include "configuration.h"
#include "gps/RTC.h"
#include "modules/irrigation/IrrigationBoardDefaults.h"
#include "modules/irrigation/RemoteButtonEdge.h"
#include "main.h"
#include "mesh/Channels.h"
#include "mesh/wifi/WiFiAPClient.h" // Fase 8b: triggerNtpUpdate/ntpLastRunMs (free functions)
#include <string.h>

// Default manual open duration when the user double-presses the station button (spec §5.2).
static constexpr uint32_t DEFAULT_MANUAL_OPEN_S = 20 * 60; // 20 min

static const char *ALLOWLIST_PATH = "/prefs/irrigation-allow.dat";
static const char *ALLOWLIST_TMP = "/prefs/irrigation-allow.tmp";

// Persistência do mini-log de auditoria (§8.9) — staged-write.
static const char *AUDIT_LOG_PATH = "/prefs/irrigation_log.dat";
static const char *AUDIT_LOG_TMP = "/prefs/irrigation_log.tmp";

// Persistência do estado gateway (Task 6, decisão §5) — staged-write em 4 arquivos.
static const char *GW_STATIONS_PATH = "/prefs/irrigation-stations.dat";
static const char *GW_STATIONS_TMP = "/prefs/irrigation-stations.tmp";
static const char *GW_ZONES_PATH = "/prefs/irrigation-zones.dat";
static const char *GW_ZONES_TMP = "/prefs/irrigation-zones.tmp";
static const char *GW_PROGRAMS_PATH = "/prefs/irrigation-programs.dat";
static const char *GW_PROGRAMS_TMP = "/prefs/irrigation-programs.tmp";
static const char *GW_MIRROR_PATH = "/prefs/irrigation-mirror.dat";
static const char *GW_MIRROR_TMP = "/prefs/irrigation-mirror.tmp";
// Fase 6b: tabela de intertravamentos (arquivo separado — não mistura com o estado do scheduler).
static const char *GW_INTERLOCKS_PATH = "/prefs/irrigation_interlocks.dat";
static const char *GW_INTERLOCKS_TMP = "/prefs/irrigation_interlocks.tmp";
// Fase 6b Task 18: nomes de sensores configurados pelo operador via painel.
static const char *GW_SENSORNAMES_PATH = "/prefs/irrigation_sensornames.dat";
static const char *GW_SENSORNAMES_TMP = "/prefs/irrigation_sensornames.tmp";
// Fase 7a: grupos hidráulicos (bomba/válvula).
static const char *GW_GRUPOS_PATH = "/prefs/irrigation_grupos.dat";
static const char *GW_GRUPOS_TMP = "/prefs/irrigation_grupos.tmp";
// controle de nível por boia (enchimento automático).
static const char *GW_NIVEIS_PATH = "/prefs/irrigation_niveis.dat";
static const char *GW_NIVEIS_TMP = "/prefs/irrigation_niveis.tmp";
// Supressão climática Open-Meteo (config + regras, arquivo separado por blob).
static const char *GW_WEATHERCFG_PATH = "/prefs/irrigation_weathercfg.dat";
static const char *GW_WEATHERCFG_TMP  = "/prefs/irrigation_weathercfg.tmp";
static const char *GW_WEATHERRULES_PATH = "/prefs/irrigation_weatherrules.dat";
static const char *GW_WEATHERRULES_TMP  = "/prefs/irrigation_weatherrules.tmp";
// Modo Remoto (Task 6): tabela de associações botoeira→saída.
static const char *GW_REMOTE_PATH = "/prefs/irrigation-remote.dat";
static const char *GW_REMOTE_TMP  = "/prefs/irrigation-remote.tmp";

// Cooldown de reconciliação de epoch por nó (30 s)
static constexpr uint32_t EPOCH_COOLDOWN_MS = 30000;

IrrigationModule *irrigationModule;

using namespace IrrigationProto;

namespace
{
// Leitor Arduino dos sensores; testes do SensorSampler usam mock próprio.
struct ArduinoSensorReader : ISensorReader {
    uint16_t readAdc(int8_t pin) override
    {
#ifndef ARCH_PORTDUINO
        return (uint16_t)analogRead(pin);
#else
        (void)pin;
        return 0;
#endif
    }
    bool readLevel(int8_t pin) override
    {
#ifndef ARCH_PORTDUINO
        return digitalRead(pin) != 0;
#else
        (void)pin;
        return false;
#endif
    }
};
ArduinoSensorReader sensorReader;
} // namespace

// Arquivo-flag da janela BLE sob demanda (spec 2026-09-27). A RTC slow memory NÃO
// sobrevive ao esp_restart nesta placa (bootCount reinicia a cada reboot), então a flag
// vai pro LittleFS. Consumida (apagada) no boot → power-loss/crash volta ao modo normal.
static const char *BLE_WINDOW_PATH = "/prefs/ble_window.dat";

static IrrigationSettings loadIrrigationSettingsOrDefault()
{
    IrrigationSettings s;
    if (!loadIrrigationSettings(s))      // sem blob persistido = 1º boot (nenhum blob jamais gravado)
        applyBoardIrrigationDefaults(s); // aplica o mapa de pinos da board (no-op sem variant custom)
    if (s.pulseMs > 1000)
        s.pulseMs = 1000;
    return s;
}

void GpioValveDriver::configure(const IrrigationSettings &s)
{
    memcpy(pinsA, s.pinsHbridgeA, sizeof(pinsA));
    memcpy(pinsB, s.pinsHbridgeB, sizeof(pinsB));
    pulseMs = s.pulseMs;
#ifndef ARCH_PORTDUINO
    for (uint8_t i = 0; i < IrrigationSettings::MAX_VALVES; i++) {
        if (pinsA[i] >= 0) {
            pinMode(pinsA[i], OUTPUT);
            digitalWrite(pinsA[i], LOW);
        }
        if (pinsB[i] >= 0) {
            pinMode(pinsB[i], OUTPUT);
            digitalWrite(pinsB[i], LOW);
        }
    }
#endif
}

void GpioValveDriver::pulse(uint8_t index, bool open)
{
    int8_t pin = open ? pinsA[index] : pinsB[index];
    if (pin < 0) {
        LOG_WARN("Valve %d has no %s pin mapped", index, open ? "open" : "close");
        return;
    }
#ifndef ARCH_PORTDUINO
    digitalWrite(pin, HIGH);
    delay(pulseMs);
    digitalWrite(pin, LOW);
#endif
    LOG_INFO("Valve %d pulsed %s", index, open ? "OPEN" : "CLOSE");
}

// Conta quantos GPOs têm pino configurado (pinsGpo[i] >= 0).
static uint8_t countGpos(const IrrigationSettings &s)
{
    uint8_t n = 0;
    for (int i = 0; i < IrrigationSettings::MAX_GPO; i++)
        if (s.pinsGpo[i] >= 0)
            n++;
    return n;
}

void GpioGpoDriver::configure(const IrrigationSettings &s)
{
    memcpy(pins, s.pinsGpo, sizeof(pins));
#ifndef ARCH_PORTDUINO
    for (uint8_t i = 0; i < IrrigationSettings::MAX_GPO; i++) {
        if (pins[i] >= 0) {
            pinMode(pins[i], OUTPUT);
            digitalWrite(pins[i], LOW);
        }
    }
#endif
}

void GpioGpoDriver::set(uint8_t index, bool on)
{
    if (index >= IrrigationSettings::MAX_GPO)
        return;
    int8_t pin = pins[index];
    if (pin < 0)
        return;
#ifndef ARCH_PORTDUINO
    digitalWrite(pin, on ? HIGH : LOW);
#endif
    LOG_INFO("GPO %d %s", index, on ? "ON" : "OFF");
}

void IrrigationModule::configureSensorPins()
{
#ifndef ARCH_PORTDUINO
    for (uint8_t i = 0; i < IrrigationSettings::MAX_SENSORS; i++) {
        const auto &sl = settings.sensores[i];
        if (sl.pino < 0)
            continue;
        if (sl.tipo == 0) {
            // Digital: ativo-baixo usa pull-up interno
            pinMode(sl.pino, (sl.flags & 1) ? INPUT_PULLUP : INPUT);
        } else {
            // Analógico
            pinMode(sl.pino, INPUT);
        }
    }
    if (settings.pinTamper >= 0) {
        // bit0 de hwFlags = ativo-baixo: usa pull-up interno
        pinMode(settings.pinTamper, (settings.hwFlags & 1) ? INPUT_PULLUP : INPUT);
    }
#endif
}

// ---------------------------------------------------------------------------
// IrrigationUiThread — polls GPIO button at 25 ms, drives LED GPIO.
// Decision §4: only instantiated when pinBtn >= 0 || pinLed >= 0.
// In ARCH_PORTDUINO (native test environment) GPIO calls are compiled out.
// Defined before the IrrigationModule constructor that calls `new` on it.
// ---------------------------------------------------------------------------

class IrrigationUiThread : public concurrency::OSThread
{
  public:
    IrrigationUiThread(IrrigationModule *m, int8_t btnPin, int8_t ledPin)
        : OSThread("IrrigUi"), module(m), btn(btnPin), ledPin(ledPin)
    {
#ifndef ARCH_PORTDUINO
        if (btn >= 0)
            pinMode(btn, INPUT_PULLUP);
        if (ledPin >= 0)
            pinMode(ledPin, OUTPUT);
#endif
    }

  protected:
    int32_t runOnce() override
    {
        bool pressed = false;
#ifndef ARCH_PORTDUINO
        if (btn >= 0)
            pressed = (digitalRead(btn) == LOW);
#endif
        auto ev = detector.update(pressed, millis());
        if (ev != ButtonGestureDetector::Event::NONE)
            module->onButtonEvent(ev);
#ifndef ARCH_PORTDUINO
        if (ledPin >= 0)
            digitalWrite(ledPin, module->ledOnNow() ? HIGH : LOW);
#endif
        return 25; // 25 ms poll — fast enough for debounce (DEBOUNCE_MS=30)
    }

  private:
    IrrigationModule *module;
    int8_t btn, ledPin;
    ButtonGestureDetector detector;
};

IrrigationModule::IrrigationModule()
    : SinglePortModule("irrigation", meshtastic_PortNum_PRIVATE_APP), concurrency::OSThread("Irrigation"),
      settings(loadIrrigationSettingsOrDefault()), valves(driver, settings.numValves),
      gpos(gpoDriver, 0), rateLimiter(settings.cmdRatePerMin)
{
    IrrigationSettings probe;
    safeMode = !loadIrrigationSettings(probe); // sem config persistida = modo seguro (spec §5.5)
    provisioned = !safeMode;                   // sem config salva = nó de fábrica → wizard de 1º boot (§6)
    if (safeMode)
        gpos.allOff(); // §5.5 GPOs inativos em modo seguro
    driver.configure(settings);
    gpoDriver.configure(settings);
    gpos.setNumGpos(countGpos(settings));
    configureSensorPins();
    sampler.configure(settings);
    // Boot sempre em estado fechado (spec §5.5): solenoides latching podem ter
    // ficado abertos num reset com válvula acionada. forceCloseAll() pulsa
    // incondicionalmente, sem depender do bit open interno (que está falso
    // em todos os slots recém-criados).
    valves.forceCloseAll();
    // Gateway carrega sua allowlist de estações adotadas na memória (spec §6).
    // Task 6, decisão §5: carrega state do gateway (zones, stations, programs, mirror).
    if ((IrrigationRole)settings.role == IrrigationRole::GATEWAY) {
        loadAllowlist();
        loadGatewayState();
        loadInterlocks();            // Fase 6b: carrega regras de intertravamento salvas
        loadSensorNames();           // Fase 6b Task 18: carrega nomes de sensores salvos
        loadGroups();                // Fase 7a: carrega grupos hidráulicos salvos
        loadLevels();                // controle de nível: carrega regras salvas
        loadWeather();               // config + regras de supressão climática
        loadRemoteButtons();         // Modo Remoto (Task 6): associações botoeira→saída
        gwRebuildLocalInterlocks();  // Fase 6b Task 14b: monta réplicas locais v5 e empurra via epoch
        // Fase 6b Task 16: inicializa o log de auditoria persistente em flash do gateway.
        auditFlashStore.ensureAllocated();
        auditFlash.begin();
    }
    // Fase 8b: device SERVICO — cofre LittleFS + controlador (§11).
    if ((IrrigationRole)settings.role == IrrigationRole::SERVICO) {
        svcStore = new LittleFsProfileStore("/clientes");
        svcStore->ensureDir();
        svc = new ServiceController(*svcStore);
    }
    // Telemetria nativa é redundante com o heartbeat de irrigação; alonga o intervalo
    // em RAM (não persiste) para desocupar airtime. Só quando não configurado pelo usuário.
    {
        IrrigationRole r = (IrrigationRole)settings.role;
        bool irrigRole = (r == IrrigationRole::ESTACAO || r == IrrigationRole::GATEWAY || r == IrrigationRole::REPETIDOR);
        if (irrigRole) {
            const uint32_t kLongIntervalS = 24u * 60u * 60u; // 24 h
            if (moduleConfig.telemetry.device_update_interval == 0 ||
                moduleConfig.telemetry.device_update_interval < kLongIntervalS)
                moduleConfig.telemetry.device_update_interval = kLongIntervalS;
            if (moduleConfig.telemetry.environment_update_interval != 0 &&
                moduleConfig.telemetry.environment_update_interval < kLongIntervalS)
                moduleConfig.telemetry.environment_update_interval = kLongIntervalS;
        }
    }
    // §8.9: carrega o mini-log sobrevivente de reboot e registra o boot.
    loadAuditLog();
    auditEvent(AuditOrigin::SISTEMA, AuditAction::REBOOT, /*target=*/0, AuditResult::OK);
    if (safeMode)
        auditEvent(AuditOrigin::SISTEMA, AuditAction::SAFE_MODE_IN, 0, AuditResult::OK);
    // §8.9: grava o registro de boot já — sem esperar o debounce de 60 s (útil p/ diagnosticar reboot loops).
    saveAuditLog();
    auditDirty = false;
    lastAuditSaveMs = millis();
    LOG_INFO("IrrigationModule role=%d valves=%d gateway=0x%08x epoch=%u safe=%d", settings.role, settings.numValves,
             settings.boundGateway, settings.configEpoch, (int)safeMode);
    // Spin up the GPIO button/LED thread only when at least one pin is wired (spec §8.6/§8.7).
    // The class is defined later in this translation unit; new'd here so it owns its own lifetime.
    if (settings.pinBtn >= 0 || settings.pinLed >= 0)
        new IrrigationUiThread(this, settings.pinBtn, settings.pinLed);
    // Janela de acesso (spec 2026-08-11): TODO papel abre a janela Portal AP + BLE no
    // boot por um prazo determinado (PortalSession::PORTAL_TIMEOUT_MS); ela fecha por
    // inatividade e reabre a cada reboot. Sem isto, um gateway/serviço provisionado numa
    // placa sem botão (ex.: XIAO S3, pinBtn<0) ficava inalcançável pós-provisionamento.
    // O teardown de BLE na borda de fechamento segue restrito ao regime elegível
    // (estação/repetidor), via AccessWindowPolicy no runOnce.
    // Janela BLE sob demanda: consome a flag RTC no boot. Se ativa, NAO abre o portal
    // (sem WiFi) e o BLE nao e derrubado no runOnce -> device vira no Meshtastic BLE.
    {
        uint8_t reqMin = 0;
#ifdef FSCom
        auto bwf = FSCom.open(BLE_WINDOW_PATH, FILE_O_READ);
        if (bwf) {
            bwf.read(&reqMin, 1);
            bwf.close();
            FSCom.remove(BLE_WINDOW_PATH); // consumo único: apaga ao ler (fail-safe)
        }
#endif
        bleWindowActive = (reqMin == 5 || reqMin == 10 || reqMin == 15);
        if (bleWindowActive)
            bleWindowDeadlineMs = millis() + (uint32_t)reqMin * 60000u;
    }
    if (!bleWindowActive)
        portal.requestOpen(millis());
}

bool IrrigationModule::wantPacket(const meshtastic_MeshPacket *p)
{
    if ((IrrigationRole)settings.role == IrrigationRole::REPETIDOR)
        return false; // repetidor só retransmite (spec §3.1)
    return p->decoded.portnum == ourPortNum;
}

bool IrrigationModule::senderAuthorized(uint32_t from, uint16_t flags) const
{
    // Predicado puro (§4.2, §11.5): marca de serviço OU não-vinculado OU vínculo com o remetente.
    // Sem vínculo gravado, qualquer nó do canal comanda (posse da PSK = autoridade, spec §4.2);
    // FLAG_FROM_SERVICE dispensa o vínculo para o nó de serviço (spec §11.5).
    return IrrigationProto::senderAuthorizedBy(flags, from, settings.boundGateway);
}

ProcessMessage IrrigationModule::handleReceived(const meshtastic_MeshPacket &mp)
{
    const auto &d = mp.decoded;
    Header h;
    if (!decodeHeader(d.payload.bytes, d.payload.size, h)) {
        LOG_WARN("Irrigation: runt packet from 0x%08x", mp.from);
        return ProcessMessage::STOP;
    }
    if (h.version != VERSION) {
        LOG_WARN("Irrigation: protocol version %d != %d from 0x%08x", h.version, VERSION, mp.from);
        // NACK somente para pacotes diretos (não broadcast) e dentro do rate-limit
        // para evitar amplificação de NACKs em versões incompatíveis na rede.
        if (isToUs(&mp) && rateLimiter.allow(millis()))
            sendAck(mp.from, h.seq, ACK_NACK, REASON_BAD_VERSION);
        return ProcessMessage::STOP;
    }

    // Track liveness of the bound gateway for NO_GATEWAY LED heuristic (spec §8.7).
    if (settings.boundGateway != 0 && mp.from == settings.boundGateway) {
        lastGatewayRxMs = millis();
        noteGatewayLink((int8_t)(mp.rx_snr * 4), (int16_t)mp.rx_rssi);
    }

    switch (h.type) {
    case MSG_CMD_VALVULA:
        handleCmdValvula(mp, h);
        break;
    case MSG_CMD_GPO:
        handleCmdGpo(mp, h);
        break;
    case MSG_SET_CONFIG:
        // Task 6, decisão §3: role split — GATEWAY recebe SET_CONFIG como resposta de GET_CONFIG.
        // Fase 8c: SERVICO recebe SET_CONFIG como resposta do próprio GET_CONFIG (leitura de nó), sem aplicar em si.
        if ((IrrigationRole)settings.role == IrrigationRole::GATEWAY)
            handleGwSetConfig(mp, h);
        else if ((IrrigationRole)settings.role == IrrigationRole::SERVICO)
            handleSvcSetConfigReply(mp, h);
        else
            handleSetConfig(mp, h);
        break;
    case MSG_GET_CONFIG:
        handleGetConfig(mp, h);
        break;
    case MSG_PAIR_ANNOUNCE:
        handlePairAnnounce(mp, h);
        break;
    case MSG_PAIR_GRANT:
        handlePairGrant(mp, h);
        break;
    case MSG_RESYNC_SEQ:
        handleResyncSeq(mp, h);
        break;
    case MSG_PING_SURVEY:
        handlePingSurvey(mp, h);
        break;
    case MSG_ACK:
        // Task 6, decisão §3: gateway trata ACKs das estações.
        if ((IrrigationRole)settings.role == IrrigationRole::GATEWAY)
            handleGwAck(mp, h);
        else {
            // Estação: trata ACK de comando direto P2P (fallback) para acionar LED de confirmação.
            IrrigationProto::Ack ack;
            if (decodeAck(mp.decoded.payload.bytes, mp.decoded.payload.size, ack)) {
                for (uint8_t i = 0; i < IrrigationSettings::MAX_DIGITAL_IN; i++) {
                    if (_pendingDirect[i].armed && _pendingDirect[i].seq == ack.ackedSeq) {
                        bool ok = (ack.status == IrrigationProto::ACK_OK);
                        uint8_t slot = _pendingDirect[i].ledSlot;
                        if (slot <= 1)
                            _remoteLed[slot].onLedState(ok, millis()); // SOLID no OK, OFF no NACK
                        _pendingDirect[i].armed = false;
                    }
                }
            } else {
                LOG_DEBUG("Irrigation: ACK from 0x%08x ignored (role=%d)", mp.from, settings.role);
            }
        }
        break;
    case MSG_HEARTBEAT:
        // Task 6, decisão §3: gateway trata HBs das estações.
        if ((IrrigationRole)settings.role == IrrigationRole::GATEWAY)
            handleGwHeartbeat(mp, h);
        else
            LOG_DEBUG("Irrigation: HB from 0x%08x ignored (role=%d)", mp.from, settings.role);
        break;
    case MSG_EVENTO:
        if ((IrrigationRole)settings.role == IrrigationRole::GATEWAY)
            handleGwEvento(mp, h);
        else
            LOG_DEBUG("Irrigation: EVENTO from 0x%08x ignored (role=%d)", mp.from, settings.role);
        break;
    case MSG_REMOTE_CMD:
        if ((IrrigationRole)settings.role == IrrigationRole::GATEWAY)
            handleRemoteCmd(mp, h);
        else
            LOG_DEBUG("Irrigation: REMOTE_CMD from 0x%08x ignored (role=%d)", mp.from, settings.role);
        break;
    case MSG_REMOTE_TRIGGER:
        if (settings.role == (uint8_t)IrrigationRole::GATEWAY)
            handleRemoteTrigger(mp, h);
        else
            LOG_DEBUG("Irrigation: REMOTE_TRIGGER from 0x%08x ignored (role=%d)", mp.from, settings.role);
        break;
    case MSG_REMOTE_LED:
        handleRemoteLed(mp, h);
        break;
    case MSG_CMD_MAINT:
        // Estação recebe janela de manutenção do tamper enviada pelo gateway (Fase 6b Task 15).
        if ((IrrigationRole)settings.role == IrrigationRole::ESTACAO)
            handleCmdMaint(mp, h);
        else
            LOG_DEBUG("Irrigation: CMD_MAINT from 0x%08x ignored (role=%d)", mp.from, settings.role);
        break;
    default:
        LOG_DEBUG("Irrigation: unhandled type %d from 0x%08x", h.type, mp.from);
        break;
    }
    return ProcessMessage::STOP;
}

void IrrigationModule::handleCmdValvula(const meshtastic_MeshPacket &mp, const Header &h)
{
    if (!senderAuthorized(mp.from, h.flags)) {
        LOG_WARN("Irrigation: unauthorized cmd from 0x%08x", mp.from);
        sendAck(mp.from, h.seq, ACK_NACK, REASON_UNAUTHORIZED);
        auditEvent(AuditOrigin::PAINEL, AuditAction::CMD_REJEITADO, REASON_UNAUTHORIZED, AuditResult::NACK, mp.from, h.seq);
        return;
    }
    // Retransmissões legítimas devem usar seq novo; seq repetido = replay ou bug
    // no gateway. Comandos limitados por rate-limit consomem o seq intencionalmente.
    if (!seqTable.checkAndUpdate(mp.from, h.seq)) {
        LOG_WARN("Irrigation: replayed seq %u from 0x%08x", h.seq, mp.from);
        return; // replay: descarta em silêncio, não ACKa
    }
    if (!rateLimiter.allow(millis())) {
        sendAck(mp.from, h.seq, ACK_NACK, REASON_RATE_LIMIT);
        auditEvent(AuditOrigin::PAINEL, AuditAction::CMD_REJEITADO, REASON_RATE_LIMIT, AuditResult::NACK, mp.from, h.seq);
        return;
    }

    CmdValvula cmd;
    if (!decodeCmdValvula(mp.decoded.payload.bytes, mp.decoded.payload.size, cmd)) {
        sendAck(mp.from, h.seq, ACK_NACK, REASON_BAD_PAYLOAD);
        auditEvent(AuditOrigin::PAINEL, AuditAction::CMD_REJEITADO, REASON_BAD_PAYLOAD, AuditResult::NACK, mp.from, h.seq);
        return;
    }

    // P2P fallback: TOGGLE resolvido no alvo — inverte a saída local.
    if (cmd.action == IrrigationProto::ACTION_TOGGLE)
        cmd.action = remoteToggleAction(valves.isOpen(cmd.valveId));

    if (safeMode && cmd.action == 1) {
        sendAck(mp.from, h.seq, ACK_NACK, REASON_SAFE_MODE);
        auditEvent(AuditOrigin::PAINEL, AuditAction::CMD_REJEITADO, REASON_SAFE_MODE, AuditResult::NACK, mp.from, h.seq);
        return;
    }

    ValveController::Result r;
    if (cmd.action == 1)
        r = valves.open(cmd.valveId, cmd.durationS, settings.maxOpenConfigS, millis());
    else
        r = valves.close(cmd.valveId);

    uint8_t reason = REASON_NONE;
    switch (r) {
    case ValveController::Result::OK:
        break;
    case ValveController::Result::INVALID_ID:
    case ValveController::Result::ZERO_DURATION:
        reason = REASON_INVALID_ID;
        break;
    case ValveController::Result::BATTERY_LOW:
        reason = REASON_BATTERY_LOW;
        break;
    }
    bool cmdOk = (reason == REASON_NONE);
    sendAck(mp.from, h.seq, cmdOk ? ACK_OK : ACK_NACK, reason);
    // §8.9: audita comando de válvula recebido por rádio.
    auditEvent(AuditOrigin::PAINEL, cmd.action == 1 ? AuditAction::ABRIR : AuditAction::FECHAR,
               cmd.valveId, cmdOk ? AuditResult::OK : AuditResult::NACK, mp.from, h.seq);
}

void IrrigationModule::handleCmdGpo(const meshtastic_MeshPacket &mp, const Header &h)
{
    // Apenas remetentes autorizados podem acionar GPOs (§4.2).
    if (!senderAuthorized(mp.from, h.flags)) {
        LOG_WARN("Irrigation: GPO cmd não autorizado de 0x%08x", mp.from);
        sendAck(mp.from, h.seq, ACK_NACK, REASON_UNAUTHORIZED);
        auditEvent(AuditOrigin::PAINEL, AuditAction::CMD_REJEITADO, REASON_UNAUTHORIZED, AuditResult::NACK, mp.from, h.seq);
        return;
    }
    // Seq repetido = replay ou bug no gateway — descarta em silêncio.
    if (!seqTable.checkAndUpdate(mp.from, h.seq)) {
        LOG_WARN("Irrigation: GPO seq repetido %u de 0x%08x", h.seq, mp.from);
        return;
    }
    if (!rateLimiter.allow(millis())) {
        sendAck(mp.from, h.seq, ACK_NACK, REASON_RATE_LIMIT);
        auditEvent(AuditOrigin::PAINEL, AuditAction::CMD_REJEITADO, REASON_RATE_LIMIT, AuditResult::NACK, mp.from, h.seq);
        return;
    }

    CmdGpo cmd;
    if (!decodeCmdGpo(mp.decoded.payload.bytes, mp.decoded.payload.size, cmd)) {
        sendAck(mp.from, h.seq, ACK_NACK, REASON_BAD_PAYLOAD);
        auditEvent(AuditOrigin::PAINEL, AuditAction::CMD_REJEITADO, REASON_BAD_PAYLOAD, AuditResult::NACK, mp.from, h.seq);
        return;
    }

    if (cmd.action == IrrigationProto::ACTION_TOGGLE)
        cmd.action = remoteToggleAction(gpos.isOn(cmd.gpoId));

    // Modo seguro: bloqueia ativação de saídas (§5.5). Desligar continua permitido.
    if (safeMode && cmd.action == 1) {
        sendAck(mp.from, h.seq, ACK_NACK, REASON_SAFE_MODE);
        auditEvent(AuditOrigin::PAINEL, AuditAction::CMD_REJEITADO, REASON_SAFE_MODE, AuditResult::NACK, mp.from, h.seq);
        return;
    }

    GpoController::Result r = gpos.command(cmd.gpoId, cmd.action, cmd.durationS, millis());

    uint8_t reason = REASON_NONE;
    if (r == GpoController::Result::INVALID_ID)
        reason = REASON_INVALID_ID;
    bool cmdOk = (reason == REASON_NONE);
    sendAck(mp.from, h.seq, cmdOk ? ACK_OK : ACK_NACK, reason);
    // §8.9: audita comando GPO recebido por rádio.
    auditEvent(AuditOrigin::PAINEL, cmd.action == 1 ? AuditAction::GPO_ON : AuditAction::GPO_OFF,
               cmd.gpoId, cmdOk ? AuditResult::OK : AuditResult::NACK, mp.from, h.seq);
}

void IrrigationModule::handleCmdMaint(const meshtastic_MeshPacket &mp, const Header &h)
{
    // Apenas o gateway vinculado pode abrir janela de manutenção (mesma regra dos outros comandos).
    if (!senderAuthorized(mp.from, h.flags)) {
        LOG_WARN("Irrigation: CMD_MAINT não autorizado de 0x%08x", mp.from);
        sendAck(mp.from, h.seq, ACK_NACK, REASON_UNAUTHORIZED);
        auditEvent(AuditOrigin::PAINEL, AuditAction::CMD_REJEITADO, REASON_UNAUTHORIZED, AuditResult::NACK, mp.from, h.seq);
        return;
    }
    // Anti-replay: seq repetido descartado em silêncio.
    if (!seqTable.checkAndUpdate(mp.from, h.seq)) {
        LOG_WARN("Irrigation: CMD_MAINT seq repetido %u de 0x%08x", h.seq, mp.from);
        return;
    }
    CmdMaint cmd;
    if (!decodeCmdMaint(mp.decoded.payload.bytes, mp.decoded.payload.size, cmd)) {
        sendAck(mp.from, h.seq, ACK_NACK, REASON_BAD_PAYLOAD);
        auditEvent(AuditOrigin::PAINEL, AuditAction::CMD_REJEITADO, REASON_BAD_PAYLOAD, AuditResult::NACK, mp.from, h.seq);
        return;
    }
    // Aplica janela de manutenção: 0 minutos = fechar imediatamente.
    if (cmd.durationMin == 0) {
        tamperMaintUntilMs = 0;
        LOG_INFO("Irrigation: janela de manutenção do tamper fechada por 0x%08x", mp.from);
    } else {
        tamperMaintUntilMs = millis() + (uint32_t)cmd.durationMin * 60000UL;
        LOG_INFO("Irrigation: janela de manutenção do tamper aberta por %u min (por 0x%08x)", cmd.durationMin, mp.from);
    }
    sendAck(mp.from, h.seq, ACK_OK, REASON_NONE);
    // §8.9: audita abertura/fechamento de janela de manutenção (ação TAMPER + origem PAINEL).
    auditEvent(AuditOrigin::PAINEL, AuditAction::TAMPER, cmd.durationMin > 0 ? 1 : 0, AuditResult::OK, mp.from, h.seq);
}

void IrrigationModule::sendAck(uint32_t to, uint32_t ackedSeq, uint8_t status, uint8_t reason)
{
    Ack ack = {};
    ack.ackedSeq = ackedSeq;
    ack.status = status;
    ack.reason = reason;
    ack.valveStates = valves.stateBitmap();
    ack.gpoStates = gpos.states();
    ack.vbatCentiV = batteryCentiV();
    ack.configEpoch = settings.configEpoch;

    meshtastic_MeshPacket *p = allocDataPacket();
    p->to = to;
    p->decoded.payload.size = encodeAck(p->decoded.payload.bytes, sizeof(p->decoded.payload.bytes), ++txSeq, ack);
    if (!p->decoded.payload.size) {
        packetPool.release(p);
        return;
    }
    txPacket(p);
}

void IrrigationModule::handleResyncSeq(const meshtastic_MeshPacket &mp, const Header &h)
{
    (void)h;
    ResyncSeq req;
    if (!decodeResyncSeq(mp.decoded.payload.bytes, mp.decoded.payload.size, req))
        return;
    if (req.kind != 0) { // REPLY: device SERVICO retoma sua numeração em lastSeq+1 (§11.5 requester)
        if (svc) {
            char cid[32];
            if (svc->getVault().activeId(cid, sizeof cid))
                svc->onResyncReply(cid, mp.from, req.lastSeq);
        }
        return;
    }
    // Query read-only: NÃO passa pelo gate anti-replay (§11.5 — o remetente pode ter contador defasado).
    if (!rateLimiter.allow(millis()))
        return;
    ResyncSeq reply = {};
    reply.kind = 1;
    reply.lastSeq = seqTable.lastSeq(mp.from);

    meshtastic_MeshPacket *p = allocDataPacket();
    p->to = mp.from;
    p->decoded.payload.size =
        (uint16_t)encodeResyncSeq(p->decoded.payload.bytes, sizeof(p->decoded.payload.bytes), ++txSeq, reply);
    if (!p->decoded.payload.size) {
        packetPool.release(p);
        return;
    }
    txPacket(p);
}

void IrrigationModule::handlePingSurvey(const meshtastic_MeshPacket &mp, const Header &h)
{
    (void)h;
    PingSurvey req;
    if (!decodePingSurvey(mp.decoded.payload.bytes, mp.decoded.payload.size, req))
        return;
    if (req.kind == 2) { // BEACON — site survey §8.5: gateway loga, ninguém responde
        if (gwIsGateway()) {
            SurveyPoint sp{};
            sp.node = mp.from;
            sp.role = req.role;
            sp.vbatCentiV = req.vbatCentiV;
            sp.fwVersion = req.fwVersion;
            sp.latE7 = req.latE7;
            sp.lonE7 = req.lonE7;
            sp.hasCoord = (req.latE7 != 0 || req.lonE7 != 0);
            sp.snrQuarterDb = (int8_t)(mp.rx_snr * 4);
            sp.rssiDbm = (int16_t)mp.rx_rssi;
            sp.uptimeS = millis() / 1000;
            surveyLog.add(sp);
        }
        return;
    }
    if (req.kind != 0) { // REPLY: coletado pelo prober do device SERVICO (§11.4)
        if (svc) {
            ScanEntry e{};
            e.node = mp.from;
            e.role = req.role;
            e.epoch = req.configEpoch;
            e.vbatCentiV = req.vbatCentiV;
            e.fwVersion = req.fwVersion;
            e.lat = req.latE7;
            e.lon = req.lonE7;
            e.snrQuarterDb = (int8_t)(mp.rx_snr * 4);
            svc->onSurveyReply(e);
        }
        return;
    }
    // Sonda broadcast, resposta só nodeinfo: isenta de auth/seq, mas rate-limited p/ proteger airtime.
    if (!rateLimiter.allow(millis()))
        return;
    PingSurvey reply = {};
    reply.kind = 1;
    reply.role = settings.role;
    reply.configEpoch = settings.configEpoch;
    reply.vbatCentiV = batteryCentiV();
    reply.fwVersion = APP_FW_VERSION;
    reply.latE7 = settings.latE7;
    reply.lonE7 = settings.lonE7;

    meshtastic_MeshPacket *p = allocDataPacket();
    p->to = mp.from;
    p->decoded.payload.size =
        (uint16_t)encodePingSurvey(p->decoded.payload.bytes, sizeof(p->decoded.payload.bytes), ++txSeq, reply);
    if (!p->decoded.payload.size) {
        packetPool.release(p);
        return;
    }
    txPacket(p);
}

bool IrrigationModule::txPacket(meshtastic_MeshPacket *p)
{
    // Tipo IrrigationProto vive em payload.bytes[1] (Header.type). arg do evento em bytes[8..].
    uint8_t type = p->decoded.payload.size > 1 ? p->decoded.payload.bytes[1] : 0;
    bool crit = false;
    if (type == IrrigationProto::MSG_EVENTO && p->decoded.payload.size > IrrigationProto::HEADER_LEN)
        crit = IrrigationAirtime::isCriticalEvent(p->decoded.payload.bytes[IrrigationProto::HEADER_LEN]);

    p->priority = (meshtastic_MeshPacket_Priority)IrrigationAirtime::priorityForType(type, crit);

    if (IrrigationAirtime::isGatedType(type) && airTime && !airTime->isTxAllowedChannelUtil(/*polite=*/true)) {
        LOG_DEBUG("Irrigation tx gated (type=%u, chUtil high)", type);
        packetPool.release(p);
        return false;
    }
    service->sendToMesh(p, RX_SRC_LOCAL, false);
    return true;
}

void IrrigationModule::sendHeartbeat()
{
    Heartbeat hb = {};
    hb.valveStates = valves.stateBitmap();
    hb.gpoStates = gpos.states();
    hb.vbatCentiV = batteryCentiV();
    hb.configEpoch = settings.configEpoch;
    hb.flags = safeMode ? HB_FLAG_SAFE_MODE : 0;
    if (tamperActive)
        hb.flags |= HB_FLAG_TAMPER;
    IrrigationProto::SensorReading rs[IrrigationSettings::MAX_SENSORS];
    hb.sensorCount = (uint8_t)sampler.readings(rs);
    for (uint8_t i = 0; i < hb.sensorCount; i++)
        hb.sensors[i] = rs[i];

    meshtastic_MeshPacket *p = allocDataPacket();
    p->to = settings.boundGateway ? settings.boundGateway : NODENUM_BROADCAST;
    p->decoded.payload.size = encodeHeartbeat(p->decoded.payload.bytes, sizeof(p->decoded.payload.bytes), ++txSeq, hb);
    if (!p->decoded.payload.size) {
        packetPool.release(p);
        return;
    }
    txPacket(p);
    sampler.noteReported(millis());
    LOG_DEBUG("Irrigation heartbeat sent, valves=0x%x vbat=%u cV", hb.valveStates, hb.vbatCentiV);
}

uint16_t IrrigationModule::batteryCentiV() const
{
    if (powerStatus && powerStatus->getHasBattery())
        return powerStatus->getBatteryVoltageMv() / 10;
    return 0;
}

void IrrigationModule::tickTamper(uint32_t nowMs)
{
    if (settings.pinTamper < 0)
        return;
    bool raw = sensorReader.readLevel(settings.pinTamper);
    // Aplica polaridade: ativo-baixo inverte o sinal
    bool ativo = (settings.hwFlags & 1) ? !raw : raw;

    // Debounce de 200 ms fixo (§8.12)
    static constexpr uint32_t TAMPER_DEBOUNCE_MS = 200;

    if (!tamperInit) {
        // Primeira amostra: inicializa estado sem emitir evento
        tamperRawLast = ativo;
        tamperRawSinceMs = nowMs;
        tamperActive = ativo;
        tamperInit = true;
        return;
    }

    if (ativo != tamperRawLast) {
        // Mudança de nível: reinicia janela de debounce
        tamperRawLast = ativo;
        tamperRawSinceMs = nowMs;
        return;
    }

    // Nível estável — verifica se já passou o debounce e se mudou o estado confirmado
    if (ativo == tamperActive)
        return; // sem mudança
    if ((nowMs - tamperRawSinceMs) < TAMPER_DEBOUNCE_MS)
        return; // ainda dentro da janela

    bool novoEstado = ativo;
    tamperActive = novoEstado;
    // §8.9: tamper sempre auditado (mesmo quando EVENTO suprimido pela janela do portal ou manutenção — §8.12).
    auditEvent(AuditOrigin::SISTEMA, AuditAction::TAMPER, tamperActive ? 1 : 0, AuditResult::OK);
    // Portal aberto OU janela de manutenção ativa suprimem o EVENTO (§8.12); estado segue no heartbeat.
    bool suprimido = portal.apShouldBeUp() || (tamperMaintUntilMs != 0 && millis() < tamperMaintUntilMs);
    if (!suprimido)
        sendEvento(IrrigationProto::EV_TAMPER, tamperActive ? 1 : 0);
}

void IrrigationModule::resetTamperState()
{
    // Config nova pode trocar o pino/polaridade do tamper: reinicia o debounce
    // para que a primeira amostra inicialize sem disparar EV_TAMPER espúrio.
    tamperActive = false;
    tamperRawLast = false;
    tamperRawSinceMs = 0;
    tamperInit = false;
}

// Monta a config remota mesclada: identidade preservada, limites saneados.
IrrigationSettings IrrigationModule::mergeRemoteConfig(const IrrigationSettings &fresh, uint32_t newEpoch) const
{
    IrrigationSettings m = fresh;
    // role e boundGateway são identidade/credencial: config remota não toca (§5.5/§6)
    m.role = settings.role;
    m.boundGateway = settings.boundGateway;
    m.configEpoch = newEpoch;
    if (m.pulseMs > 1000)
        m.pulseMs = 1000;
    if (m.cmdRatePerMin == 0)
        m.cmdRatePerMin = 1; // 0 trancaria até o próprio SET_CONFIG de recuperação
    if (m.hbMinutes == 0)
        m.hbMinutes = 1;
    if (m.numValves > IrrigationSettings::MAX_VALVES)
        m.numValves = IrrigationSettings::MAX_VALVES;
    return m;
}

void IrrigationModule::activateSettings(const IrrigationSettings &merged)
{
    // Fecha tudo ANTES de trocar o pin map: os pulsos de fechar saem nos pinos antigos.
    valves.forceCloseAll();
    // GPOs desligam ANTES da troca do pin map: set(false) sai nos pinos antigos (mesma razão das válvulas).
    gpos.allOff();
    settings = merged;
    if (settings.numValves == 0)
        LOG_WARN("Irrigation: config sets zero valves");
    driver.configure(settings);
    valves.setNumValves(settings.numValves);
    gpoDriver.configure(settings);
    gpos.setNumGpos(countGpos(settings));
    configureSensorPins();
    sampler.configure(settings);
    resetTamperState();
    rateLimiter = RateLimiter(settings.cmdRatePerMin);
}

void IrrigationModule::handleSetConfig(const meshtastic_MeshPacket &mp, const Header &h)
{
    if (!senderAuthorized(mp.from, h.flags)) {
        sendAck(mp.from, h.seq, ACK_NACK, REASON_UNAUTHORIZED);
        auditEvent(AuditOrigin::PAINEL, AuditAction::CMD_REJEITADO, REASON_UNAUTHORIZED, AuditResult::NACK, mp.from, h.seq);
        return;
    }
    if (!seqTable.checkAndUpdate(mp.from, h.seq)) {
        LOG_WARN("Irrigation: replayed config seq %u from 0x%08x", h.seq, mp.from);
        return; // replay silencioso: sem NACK, sem auditoria
    }
    if (!rateLimiter.allow(millis())) {
        sendAck(mp.from, h.seq, ACK_NACK, REASON_RATE_LIMIT);
        auditEvent(AuditOrigin::PAINEL, AuditAction::CMD_REJEITADO, REASON_RATE_LIMIT, AuditResult::NACK, mp.from, h.seq);
        return;
    }

    SetConfig sc;
    if (!decodeSetConfig(mp.decoded.payload.bytes, mp.decoded.payload.size, sc)) {
        sendAck(mp.from, h.seq, ACK_NACK, REASON_BAD_PAYLOAD);
        auditEvent(AuditOrigin::PAINEL, AuditAction::CMD_REJEITADO, REASON_BAD_PAYLOAD, AuditResult::NACK, mp.from, h.seq);
        return;
    }

    auto r = reasm.add(mp.from, sc.epoch, sc.crc, sc.totalLen, sc.fragIndex, sc.fragCount, sc.frag, sc.fragLen, millis());
    switch (r) {
    case FragmentReassembler::Add::ACCEPTED:
        return; // fragmento intermediário: sem ACK (ACK = commit, §5.5)
    case FragmentReassembler::Add::TOO_BIG:
        sendAck(mp.from, h.seq, ACK_NACK, REASON_CONFIG_TOO_BIG);
        auditEvent(AuditOrigin::PAINEL, AuditAction::CMD_REJEITADO, REASON_CONFIG_TOO_BIG, AuditResult::NACK, mp.from, h.seq);
        return;
    case FragmentReassembler::Add::INVALID:
        sendAck(mp.from, h.seq, ACK_NACK, REASON_FRAG_INVALID);
        auditEvent(AuditOrigin::PAINEL, AuditAction::CMD_REJEITADO, REASON_FRAG_INVALID, AuditResult::NACK, mp.from, h.seq);
        return;
    case FragmentReassembler::Add::BAD_CRC:
        sendAck(mp.from, h.seq, ACK_NACK, REASON_BAD_CRC);
        auditEvent(AuditOrigin::PAINEL, AuditAction::CMD_REJEITADO, REASON_BAD_CRC, AuditResult::NACK, mp.from, h.seq);
        return;
    case FragmentReassembler::Add::COMPLETE:
        break;
    }

    IrrigationSettings fresh;
    if (!migrateIrrigationSettings(reasm.blob(), reasm.blobLen(), fresh)) {
        reasm.reset();
        sendAck(mp.from, h.seq, ACK_NACK, REASON_BAD_PAYLOAD);
        auditEvent(AuditOrigin::PAINEL, AuditAction::CMD_REJEITADO, REASON_BAD_PAYLOAD, AuditResult::NACK, mp.from, h.seq);
        return;
    }
    uint32_t newEpoch = reasm.epoch();
    reasm.reset();

    IrrigationSettings merged = mergeRemoteConfig(fresh, newEpoch);
    if (!saveIrrigationSettings(merged)) {
        sendAck(mp.from, h.seq, ACK_NACK, REASON_COMMIT_FAIL);
        auditEvent(AuditOrigin::PAINEL, AuditAction::CMD_REJEITADO, REASON_COMMIT_FAIL, AuditResult::NACK, mp.from, h.seq);
        return;
    }
    activateSettings(merged);
    bool wasSafe = safeMode;
    safeMode = false;
    LOG_INFO("Irrigation: config applied epoch=%u from 0x%08x", newEpoch, mp.from);
    sendAck(mp.from, h.seq, ACK_OK, REASON_NONE);
    // §8.9: audita adoção de epoch de configuração.
    auditEvent(AuditOrigin::PAINEL, AuditAction::CONFIG_EPOCH, 0, AuditResult::OK, mp.from, h.seq);
    if (wasSafe)
        auditEvent(AuditOrigin::SISTEMA, AuditAction::SAFE_MODE_OUT, 0, AuditResult::OK);
}

void IrrigationModule::handleGetConfig(const meshtastic_MeshPacket &mp, const Header &h)
{
    if (!senderAuthorized(mp.from, h.flags)) {
        sendAck(mp.from, h.seq, ACK_NACK, REASON_UNAUTHORIZED);
        return;
    }
    if (!seqTable.checkAndUpdate(mp.from, h.seq))
        return;
    if (!rateLimiter.allow(millis()))
        return; // leitura: sem NACK, requisitante re-tenta

    // Resposta = o blob vigente no formato SET_CONFIG (leitura não altera epoch, §11.6)
    const uint8_t *blob = (const uint8_t *)&settings;
    uint16_t totalLen = sizeof(settings);
    uint32_t crc = crc32(blob, totalLen);
    uint8_t fragCount = (uint8_t)((totalLen + FRAG_DATA_MAX - 1) / FRAG_DATA_MAX);
    for (uint8_t i = 0; i < fragCount; i++) {
        SetConfig sc = {};
        sc.epoch = settings.configEpoch;
        sc.crc = crc;
        sc.totalLen = totalLen;
        sc.fragIndex = i;
        sc.fragCount = fragCount;
        uint16_t off = (uint16_t)i * FRAG_DATA_MAX;
        sc.fragLen = (uint8_t)((totalLen - off > FRAG_DATA_MAX) ? FRAG_DATA_MAX : totalLen - off);
        sc.frag = blob + off;

        meshtastic_MeshPacket *p = allocDataPacket();
        p->to = mp.from;
        p->decoded.payload.size =
            (uint16_t)encodeSetConfig(p->decoded.payload.bytes, sizeof(p->decoded.payload.bytes), ++txSeq, sc);
        if (!p->decoded.payload.size) {
            packetPool.release(p);
            return;
        }
        txPacket(p);
    }
}

int32_t IrrigationModule::runOnce()
{
#if defined(ARCH_ESP32) && !MESHTASTIC_EXCLUDE_WEBSERVER
    portalApLoop(millis());
#endif
#ifdef ARCH_ESP32
    // Janela de acesso (spec 2026-08-11): detecta a borda OPEN->CLOSED da janela
    // num nó elegível e, uma única vez por boot, derruba o BLE de verdade
    // (config.bluetooth.enabled=false em RAM → deinit → release da RAM). O AP já
    // foi derrubado pelo próprio portalApLoop() quando apShouldBeUp() virou false.
    {
        IrrigationRole role = (IrrigationRole)settings.role;
        bool eligible = AccessWindowPolicy::eligible(role, provisioned);
        bool up = portal.apShouldBeUp();
        // Estação/repetidor (elegível): derruba o BLE na BORDA DE FECHAMENTO da janela —
        // durante a janela AP+BLE convivem por design.
        // Gateway/serviço: WiFi (portal AP) é a interface principal e no ESP32-S3 WiFi e
        // BLE dividem o rádio 2.4 GHz; a coexistência derruba o AP (portal pouco
        // responsivo, abas com "load failed", desconexão frequente). Então derruba o BLE
        // assim que o AP SOBE. Em ambos os casos o release é sticky até o próximo reboot.
        bool wifiPrimary = (role == IrrigationRole::GATEWAY || role == IrrigationRole::SERVICO);
        // Durante a janela BLE sob demanda o BLE fica ON (WiFi off): nao derruba.
        bool tearNow = !bleWindowActive &&
                       (AccessWindowPolicy::shouldTearDownBle(eligible, up, apWasUp, bleReleasedThisBoot) ||
                        (wifiPrimary && up && !bleReleasedThisBoot));
        if (tearNow) {
            LOG_INFO("Irrigation: tearing down BLE (free 2.4GHz for WiFi AP; sticky until reboot)");
            config.bluetooth.enabled = false; // RAM only — flash mantém enabled=true p/ o próximo boot.
            if (nimbleBluetooth)
                nimbleBluetooth->deinit();
            esp32ReleaseBluetoothMemoryIfUnused(); // shouldReleaseBluetoothMemory()==true agora
            bleReleasedThisBoot = true;
        }
        apWasUp = up;
        // Auto-retorno da janela BLE: expirou -> reboot (flag ja consumida -> boot normal).
        if (bleWindowActive && (int32_t)(millis() - bleWindowDeadlineMs) >= 0) {
            LOG_INFO("Irrigation: janela BLE expirada - reboot para restaurar WiFi/portal");
            rebootAtMsec = millis() + 100;
        }
    }
#endif
    // Fail-safe tick roda em TODOS os papéis: num nó mal-configurado nunca deve
    // sobrar válvula aberta sem timer sendo decrementado.
    // §8.9: captura estado antes do tick para detectar fechamentos por fail-safe timer.
    uint8_t vBefore = valves.stateBitmap();
    uint8_t gBefore = gpos.states();
    valves.tick(millis());
    gpos.tick(millis()); // §5.5 GPOs temporizados expirados são desligados automaticamente
    // Audita cada saída que foi fechada pelo fail-safe timer.
    uint8_t vAfter = valves.stateBitmap();
    uint8_t gAfter = gpos.states();
    for (uint8_t i = 0; i < IrrigationSettings::MAX_VALVES; i++) {
        if ((vBefore >> i & 1) && !(vAfter >> i & 1))
            auditEvent(AuditOrigin::FAILSAFE_TIMER, AuditAction::FECHAR, i, AuditResult::OK);
    }
    for (uint8_t i = 0; i < IrrigationSettings::MAX_GPO; i++) {
        if ((gBefore >> i & 1) && !(gAfter >> i & 1))
            auditEvent(AuditOrigin::FAILSAFE_TIMER, AuditAction::GPO_OFF, i, AuditResult::OK);
    }
    stationPairing.tick(millis());
    gatewayPairing.tick(millis());

    // Periodic PAIR_ANNOUNCE while the station pairing window is open (spec §6 step 1).
    // Must run before the early-return below so the role guard only needs to check ESTACAO.
    if ((IrrigationRole)settings.role == IrrigationRole::ESTACAO && stationPairing.announceDue(millis())) {
        PairAnnounce pa = {};
        pa.protoVersion = VERSION;
        // owner.short_name declared as extern meshtastic_User& in NodeDB.h; available via main.h include chain.
        pa.nameLen = (uint8_t)strnlen(owner.short_name, (sizeof(pa.name) - 1));
        memcpy(pa.name, owner.short_name, pa.nameLen);
        meshtastic_MeshPacket *p = allocDataPacket();
        p->to = NODENUM_BROADCAST;
        p->decoded.payload.size =
            (uint16_t)encodePairAnnounce(p->decoded.payload.bytes, sizeof(p->decoded.payload.bytes), ++txSeq, pa);
        if (p->decoded.payload.size)
            txPacket(p);
        else
            packetPool.release(p);
    }

    // §8.9: flush do mini-log com debounce de 60 s — preserva flash e sobrevive a reboot.
    // Roda antes do branch de papel para garantir flush em qualquer configuração.
    if (auditDirty && millis() - lastAuditSaveMs >= 60000) {
        saveAuditLog();
        auditDirty = false;
        lastAuditSaveMs = millis();
    }

    // Fase 8d — site survey (§8.5): emite beacon PING_SURVEY no intervalo, em qualquer papel que o iniciou.
    if (surveyBeacon.tick(millis()))
        emitSurveyBeacon();

    // --- Drive físico dos LEDs remotos — roda em TODOS os papéis (Task 7) ---
    // Gateway: onPress() acionado no Task 6 coloca _remoteLed em BLINK; precisa renderizar aqui.
    // Estação: recebe ACK do gateway e pisca confirmação ao operador.
    for (uint8_t slot = 0; slot <= 1; slot++) {
        if (settings.pinsRemoteLed[slot] < 0)
            continue;
#ifndef ARCH_PORTDUINO
        digitalWrite(settings.pinsRemoteLed[slot], _remoteLed[slot].ledOn(millis()) ? HIGH : LOW);
#endif
    }

    if ((IrrigationRole)settings.role != IrrigationRole::ESTACAO) {
        if ((IrrigationRole)settings.role == IrrigationRole::GATEWAY)
            gwTick(); // Task 6, decisão §2: loop principal do gateway 1×/s
        refreshLedMode();
        return 1000; // Task 6: cadência de 1 s (substitui 60 s/1 s condicional anterior)
    }
    uint16_t vbat = batteryCentiV();
    valves.setBatteryLockout(vbat != 0 && vbat < settings.vbatMinAbrirCentiV);

    sampler.tick(millis(), sensorReader);
    tickTamper(millis());

    // Fase 6b Task 14c: réplica local de intertravamento — fecha saídas SEM rádio.
    // Avalia todas as regras localInterlocks (preenchidas pelo gateway via SET_CONFIG)
    // e fecha na BORDA DE SUBIDA (bit 0→1) para não re-pulsar pontes H latching.
    {
        IrrigationProto::SensorReading rd[IrrigationSettings::MAX_SENSORS];
        size_t nrd = sampler.readings(rd);
        LocalReplicaOut lr = evalLocalInterlocks(settings.localInterlocks,
                                                 IrrigationSettings::MAX_LOCAL_INTERLOCKS,
                                                 rd, nrd,
                                                 localInterlockLatch);
        // Válvulas: fecha apenas as que passaram de 0→1 neste tick.
        uint8_t valvRising = lr.fecharValvMask & ~localFecharValvPrev;
        for (uint8_t i = 0; i < ValveController::MAX_VALVES; i++) {
            if (valvRising & (1u << i)) {
                valves.close(i);
                auditEvent(AuditOrigin::INTERTRAVAMENTO, AuditAction::FECHAR, i, AuditResult::OK);
            }
        }
        // GPOs: desliga apenas os que passaram de 0→1 neste tick (action 0 = off).
        uint8_t gpoRising = lr.fecharGpoMask & ~localFecharGpoPrev;
        for (uint8_t i = 0; i < GpoController::MAX_GPO; i++) {
            if (gpoRising & (1u << i)) {
                gpos.command(i, 0, 0, millis());
                auditEvent(AuditOrigin::INTERTRAVAMENTO, AuditAction::GPO_OFF, i, AuditResult::OK);
            }
        }
        localFecharValvPrev = lr.fecharValvMask;
        localFecharGpoPrev  = lr.fecharGpoMask;
    }

    if (sampler.earlyHeartbeatDue(millis()))
        sendHeartbeat(); // mudança significativa de sensor: reporte antecipado (rate-limited no sampler)

    if (bootHeartbeatPending && millis() > 10000) {
        bootHeartbeatPending = false;
        lastHeartbeatMs = millis();
        sendHeartbeat();
    }

    {
        uint32_t baseMs = (uint32_t)settings.hbMinutes * 60u * 1000u;
        float chUtil = airTime ? airTime->channelUtilizationPercent() : 0.0f;
        uint8_t factor = settings.hbBackoffEnabled() ? IrrigationAirtime::hbBackoffFactor(chUtil) : 1;
        uint32_t effectiveMs = baseMs * factor;

        // Re-semeia o jitter quando o epoch muda (descorrelaciona flood de cena).
        if (settings.configEpoch != hbSeedEpoch) {
            hbSeedEpoch = settings.configEpoch;
            uint32_t win = settings.hbJitterEnabled() ? IrrigationAirtime::hbWindowMs(effectiveMs) : 0;
            hbJitterMs = IrrigationAirtime::hbJitterOffsetMs(nodeDB->getNodeNum(), settings.configEpoch, win);
        }

        if (!Throttle::isWithinTimespanMs(lastHeartbeatMs, effectiveMs + hbJitterMs)) {
            lastHeartbeatMs = millis();
            sendHeartbeat();
        }
    }

    // --- Botoeira local da estação (Modo Remoto Task 7) ---
    for (uint8_t i = 0; i < IrrigationSettings::MAX_DIGITAL_IN; i++) {
        if (settings.pinsDigitalIn[i] < 0 || !digitalInIsButton(settings, i))
            continue;
#ifndef ARCH_PORTDUINO
        bool raw = (digitalRead(settings.pinsDigitalIn[i]) == HIGH);
#else
        bool raw = false;
#endif
        bool activeLow = (settings.digitalInActiveLow >> i) & 1;
        bool pressed = activeLow ? !raw : raw;
        if (_btnEdge[i].update(pressed, millis())) {
            uint8_t slot = digitalInLedSlot(settings, i);
            if (slot <= 1)
                _remoteLed[slot].onPress(millis());
            if (settings.boundGateway != 0) {
                meshtastic_MeshPacket *p = allocDataPacket();
                p->to = settings.boundGateway;
                IrrigationProto::RemoteTrigger rt{i};
                p->decoded.payload.size = (uint16_t)IrrigationProto::encodeRemoteTrigger(
                    p->decoded.payload.bytes, sizeof(p->decoded.payload.bytes), ++txSeq, rt);
                if (p->decoded.payload.size)
                    txPacket(p);
                else
                    packetPool.release(p);
            }
            if (settings.btnFallbackNode[i] != 0) {
                _fallback.setWindow(settings.remoteFallbackMs ? settings.remoteFallbackMs
                                                              : REMOTE_FALLBACK_DEFAULT_MS);
                _fallback.arm(i, millis());
            }
        }
    }

    // P2P fallback: gatilhos sem REMOTE_LED a tempo → comando direto ao nó alvo.
    {
        uint8_t exp[IrrigationSettings::MAX_DIGITAL_IN];
        size_t k = _fallback.takeExpired(millis(), exp, IrrigationSettings::MAX_DIGITAL_IN);
        for (size_t j = 0; j < k; j++) {
            uint8_t i = exp[j];
            if (settings.btnFallbackNode[i] == 0)
                continue;
            uint8_t kind = btnFallbackKindOf(settings, i); // 0=válvula,1=GPO
            meshtastic_MeshPacket *p = allocDataPacket();
            p->to = settings.btnFallbackNode[i];
            uint32_t seq = ++txSeq;
            if (kind == 1) {
                IrrigationProto::CmdGpo c{settings.btnFallbackOutId[i], IrrigationProto::ACTION_TOGGLE, 0};
                p->decoded.payload.size = (uint16_t)IrrigationProto::encodeCmdGpo(
                    p->decoded.payload.bytes, sizeof(p->decoded.payload.bytes), seq, c);
            } else {
                IrrigationProto::CmdValvula c{settings.btnFallbackOutId[i], IrrigationProto::ACTION_TOGGLE, 0};
                p->decoded.payload.size = (uint16_t)IrrigationProto::encodeCmdValvula(
                    p->decoded.payload.bytes, sizeof(p->decoded.payload.bytes), seq, c);
            }
            if (p->decoded.payload.size) {
                // Alvo pareado só aceita comando do gateway vinculado OU marcado como serviço
                // (senderAuthorizedBy §11.5). A botoeira não é o gateway, então carimba
                // FLAG_FROM_SERVICE — mesmo mecanismo que o gateway usa nos comandos dele.
                // A PSK do canal continua sendo a fronteira de confiança real.
                IrrigationProto::setServiceFlag(p->decoded.payload.bytes, p->decoded.payload.size);
                txPacket(p);
                uint8_t slot = digitalInLedSlot(settings, i);
                if (slot <= 1) {
                    _pendingDirect[i] = {seq, slot, true};
                }
            } else {
                packetPool.release(p);
            }
        }
    }

    refreshLedMode();
    return 1000; // tick de 1 s mantém o fail-safe responsivo
}

// ---------------------------------------------------------------------------
// Pairing handlers (spec §6). No senderAuthorized check — physical window +
// button press is the authorization. Both handlers apply anti-replay and rate
// limit at entry to prevent amplification attacks.
//
// adoção exige que o gateway mantenha um canal secundário com PSK default para
// escutar anúncios; o grant volta por esse canal (exposição aceita, spec §6).
// o modelo é UM botão por lado, não dois — qualquer anunciante durante a janela
// do gateway recebe a PSK; exposição aceita pela spec §6, não sobrestimar a garantia.
// ---------------------------------------------------------------------------

void IrrigationModule::handlePairAnnounce(const meshtastic_MeshPacket &mp, const Header &h)
{
    if ((IrrigationRole)settings.role != IrrigationRole::GATEWAY)
        return;
    // Anti-replay and rate-limit before any work (spec §4 — same guards as commands).
    if (!seqTable.checkAndUpdate(mp.from, h.seq)) {
        LOG_WARN("Irrigation: replayed announce seq %u from 0x%08x", h.seq, mp.from);
        return;
    }
    if (!rateLimiter.allow(millis()))
        return;
    PairAnnounce pa;
    if (!decodePairAnnounce(mp.decoded.payload.bytes, mp.decoded.payload.size, pa))
        return;
    if (!gatewayPairing.approveAnnounce(mp.from, millis())) {
        gatewayPairing.notePending(mp.from, millis()); // §6: painel mostra "nó novo detectado" p/ o operador aprovar
        LOG_INFO("Irrigation: announce from 0x%08x (%.*s) pending, window closed", mp.from, (int)pa.nameLen, pa.name);
        return;
    }
    gatewayPairing.clearPending(); // concedendo: o nó deixa de estar pendente
    // Decision §2: PSK must be exactly 32 bytes (own farm key); default/well-known PSK must not be granted.
    const meshtastic_ChannelSettings &prim = channels.getPrimary();
    if (prim.psk.size != 32) {
        LOG_WARN("Irrigation: cannot grant, primary channel has no 32-byte PSK (gateway needs its own farm key)");
        return;
    }
    PairGrant g = {};
    memcpy(g.psk, prim.psk.bytes, 32);
    const char *chName = channels.getName(channels.getPrimaryIndex());
    g.nameLen = (uint8_t)strnlen(chName, sizeof(g.channelName) - 1);
    memcpy(g.channelName, chName, g.nameLen);
    g.gatewayId = nodeDB->getNodeNum();

    if (!allowlist.add(mp.from)) {
        LOG_ERROR("Irrigation: allowlist full, refusing grant to 0x%08x", mp.from);
        return;
    }
    meshtastic_MeshPacket *p = allocDataPacket();
    p->to = mp.from;
    p->channel = mp.channel; // responde no canal do anúncio: o nó de fábrica não tem a PSK primária
    p->decoded.payload.size =
        (uint16_t)encodePairGrant(p->decoded.payload.bytes, sizeof(p->decoded.payload.bytes), ++txSeq, g);
    if (!p->decoded.payload.size) {
        packetPool.release(p);
        allowlist.remove(mp.from); // rollback: grant não foi enviado
        return;
    }
    txPacket(p);
    saveAllowlist();

    // Task 6, decisão §4: registrar a estação no StationRegistry no momento do pareamento.
    {
        StationEntry entry;
        entry.node = mp.from;
        entry.desiredEpoch = 0; // epoch 0 = defaults; será atualizado na primeira reconciliação
        uint8_t cpyLen = pa.nameLen < (uint8_t)(sizeof(entry.name) - 1) ? pa.nameLen : (uint8_t)(sizeof(entry.name) - 1);
        memcpy(entry.name, pa.name, cpyLen);
        entry.name[cpyLen] = '\0';
        if (gateway.stations.upsert(entry)) {
            saveGatewayState(); // persiste após mutação (decisão §5)
            LOG_INFO("Irrigation: station 0x%08x registered in gateway registry", mp.from);
        }
    }

    LOG_INFO("Irrigation: granted pairing to 0x%08x (%.*s)", mp.from, (int)pa.nameLen, pa.name);
}

void IrrigationModule::handlePairGrant(const meshtastic_MeshPacket &mp, const Header &h)
{
    if ((IrrigationRole)settings.role != IrrigationRole::ESTACAO)
        return;
    // Anti-replay and rate-limit at entry (spec §4).
    if (!seqTable.checkAndUpdate(mp.from, h.seq)) {
        LOG_WARN("Irrigation: replayed grant seq %u from 0x%08x", h.seq, mp.from);
        return;
    }
    if (!rateLimiter.allow(millis()))
        return;
    PairGrant g;
    if (!decodePairGrant(mp.decoded.payload.bytes, mp.decoded.payload.size, g))
        return;
    if (!stationPairing.onGrant(g, millis())) {
        LOG_WARN("Irrigation: grant from 0x%08x outside pairing window", mp.from);
        return;
    }
    commitPairing();
}

void IrrigationModule::commitPairing()
{
    const PairGrant &g = stationPairing.grant();
    // Decision §2: write farm PSK and channel name into the primary channel,
    // then schedule a reboot so all subsystems reload the new crypto context.
    // Adaptation: channels.getByIndex() returns a reference (confirmed in Channels.h line 40).
    meshtastic_Channel ch = channels.getByIndex(channels.getPrimaryIndex());
    memcpy(ch.settings.psk.bytes, g.psk, 32);
    ch.settings.psk.size = 32;
    memset(ch.settings.name, 0, sizeof(ch.settings.name));
    memcpy(ch.settings.name, g.channelName, g.nameLen);
    channels.setChannel(ch);
    channels.onConfigChanged();
    service->reloadConfig(SEGMENT_CHANNELS); // persiste o canal: sem isso, queda de
    // energia antes do reboot deixaria vínculo gravado com PSK antiga em flash

    uint32_t oldGw = settings.boundGateway;
    settings.boundGateway = g.gatewayId;
    if (!saveIrrigationSettings(settings)) {
        settings.boundGateway = oldGw;
        stationPairing.reset(); // permite reabrir a janela e re-parear sem power-cycle
        LOG_ERROR("Irrigation: pairing commit failed to persist");
        return;
    }
    safeMode = false;
    // §8.9: audita pareamento concluído com o gateway.
    auditEvent(AuditOrigin::SISTEMA, AuditAction::PAREAR, 0, AuditResult::OK, g.gatewayId);
    sendEvento(EV_PAIRED, g.gatewayId);
    LOG_INFO("Irrigation: paired to gateway 0x%08x, rebooting in 3 s", g.gatewayId);
    rebootAtMsec = millis() + 3000;
}

// Decision §3: factory reset clears irrigation prefs only; channel PSK remains
// (full credential removal requires the Phase-5 portal — documented limitation).
void IrrigationModule::startBleWindow(uint8_t minutes)
{
#ifdef FSCom
    auto f = FSCom.open(BLE_WINDOW_PATH, FILE_O_WRITE);
    if (f) {
        f.write(&minutes, 1);
        f.close();
    }
#endif
    LOG_INFO("Irrigation: janela BLE de %u min pedida; reboot em 3 s", (unsigned)minutes);
    rebootAtMsec = millis() + 3000;
}

void IrrigationModule::factoryReset()
{
    // pulsos saem no pin map atual; depois do wipe os pinos viram -1 e nada mais fecha fisicamente.
    valves.forceCloseAll();
    gpos.allOff(); // §5.5 GPOs inativos em modo seguro
    LOG_WARN("Irrigation: factory reset by button");
    led.setMode(LedPatternController::Mode::PAIRING); // visual confirmation for 2 s before reboot
    sendEvento(EV_FACTORY_RESET); // entrega best-effort — reboot em 2 s pode cortar o TX
    IrrigationSettings def; // defaults: credenciais e parâmetros zerados
    def.role = settings.role; // papel e pinos são realidade física, não credencial
    def.numValves = settings.numValves;
    memcpy(def.pinsHbridgeA, settings.pinsHbridgeA, sizeof(def.pinsHbridgeA));
    memcpy(def.pinsHbridgeB, settings.pinsHbridgeB, sizeof(def.pinsHbridgeB));
    memcpy(def.pinsDigitalIn, settings.pinsDigitalIn, sizeof(def.pinsDigitalIn));
    def.digitalInActiveLow = settings.digitalInActiveLow;
    def.pinBtn = settings.pinBtn;
    def.pinLed = settings.pinLed;
    saveIrrigationSettings(def); // boundGateway=0, epoch=0: nó volta ao modo fábrica
#ifdef FSCom
    FSCom.remove(ALLOWLIST_PATH);
    // §8.9: factory reset apaga o log — estação volta zerada (decisão de design:
    // log de auditoria é parte da identidade do nó; reset deve limpar tudo).
    audit.clear();
    auditDirty = false; // reset já apagou o arquivo; não deixa o debounce gravar anel vazio.
    FSCom.remove(AUDIT_LOG_PATH);
#endif
    rebootAtMsec = millis() + 2000;
}

// Exports the primary channel name and PSK (base64) to the serial console for
// registration in the service device vault (spec §11.2). Physical access to the
// gateway is the authorization — same model as pairing. Phase 5 exposes this in
// the web portal (with PIN). Adaptation: inline base64 avoids a new dependency.
void IrrigationModule::logFarmKey()
{
    const meshtastic_ChannelSettings &prim = channels.getPrimary();
    if (prim.psk.size != 32) {
        LOG_WARN("Irrigation: primary channel has no 32-byte PSK to export");
        return;
    }
    static const char b64[] = "ABCDEFGHIJKLMNOPQRSTUVWXYZabcdefghijklmnopqrstuvwxyz0123456789+/";
    char out[45];
    int o = 0;
    for (int i = 0; i < 32; i += 3) {
        uint32_t v = ((uint32_t)prim.psk.bytes[i] << 16) |
                     ((uint32_t)(i + 1 < 32 ? prim.psk.bytes[i + 1] : 0) << 8) |
                     (uint32_t)(i + 2 < 32 ? prim.psk.bytes[i + 2] : 0);
        out[o++] = b64[(v >> 18) & 63];
        out[o++] = b64[(v >> 12) & 63];
        out[o++] = (i + 1 < 32) ? b64[(v >> 6) & 63] : '=';
        out[o++] = (i + 2 < 32) ? b64[v & 63] : '=';
    }
    out[o] = '\0';
    LOG_INFO("Irrigation FARM KEY: channel=%s psk_b64=%s", channels.getName(channels.getPrimaryIndex()), out);
}

// Fase 8b — executores do device SERVICO (§11). Espelham commitPairing (re-tune) e o
// padrão allocDataPacket/encode/sendToMesh dos demais emissores.

void IrrigationModule::applyRetune(const char *clientId)
{
    if (!svc)
        return;
    RetunePlan r;
    if (!svc->planRetune(clientId, r)) {
        LOG_WARN("Irrigation SERVICO: retune plan failed for '%s'", clientId);
        return;
    }
    meshtastic_Channel ch = channels.getByIndex(channels.getPrimaryIndex());
    memset(ch.settings.psk.bytes, 0, sizeof(ch.settings.psk.bytes));
    memcpy(ch.settings.psk.bytes, r.psk, r.pskLen);
    ch.settings.psk.size = (uint16_t)r.pskLen;
    memset(ch.settings.name, 0, sizeof(ch.settings.name));
    strncpy(ch.settings.name, r.name, sizeof(ch.settings.name) - 1);
    channels.setChannel(ch);
    channels.onConfigChanged();
    config.lora.modem_preset = (meshtastic_Config_LoRaConfig_ModemPreset)r.preset;
    config.lora.use_preset = true;
    // Persiste canal + config antes do reboot (§11.3): queda de energia não deixa estado meio-trocado.
    service->reloadConfig(SEGMENT_CHANNELS | SEGMENT_CONFIG);
    svc->getVault().select(clientId); // persiste ponteiro de cliente ativo (/clientes/active)
    LOG_INFO("Irrigation SERVICO: retune to client '%s' channel '%s', rebooting in 3 s", clientId, r.name);
    rebootAtMsec = millis() + 3000;
}

void IrrigationModule::svcEmitProbe()
{
    if (!svc)
        return;
    svc->clearScan();
    PingSurvey probe = {};
    probe.kind = 0; // PROBE
    meshtastic_MeshPacket *p = allocDataPacket();
    p->to = NODENUM_BROADCAST;
    uint16_t sz =
        (uint16_t)encodePingSurvey(p->decoded.payload.bytes, sizeof(p->decoded.payload.bytes), ++txSeq, probe);
    if (!sz) {
        packetPool.release(p);
        return;
    }
    p->decoded.payload.size = sz;
    setServiceFlag(p->decoded.payload.bytes, p->decoded.payload.size);
    txPacket(p);
    LOG_INFO("Irrigation SERVICO: PING_SURVEY probe broadcast");
}

// Fase 8d — site survey (§8.5): beacon periódico de cobertura (kind=2), broadcast.
void IrrigationModule::emitSurveyBeacon()
{
    PingSurvey b = {};
    b.kind = 2; // BEACON
    b.role = settings.role;
    b.configEpoch = settings.configEpoch;
    b.vbatCentiV = batteryCentiV();
    b.fwVersion = APP_FW_VERSION;
    b.latE7 = surveyBeacon.hasCoord() ? surveyBeacon.latE7() : 0;
    b.lonE7 = surveyBeacon.hasCoord() ? surveyBeacon.lonE7() : 0;

    meshtastic_MeshPacket *p = allocDataPacket();
    p->to = NODENUM_BROADCAST;
    uint16_t sz = (uint16_t)encodePingSurvey(p->decoded.payload.bytes, sizeof(p->decoded.payload.bytes), ++txSeq, b);
    if (!sz) {
        packetPool.release(p);
        return;
    }
    p->decoded.payload.size = sz;
    if ((IrrigationRole)settings.role == IrrigationRole::SERVICO)
        setServiceFlag(p->decoded.payload.bytes, p->decoded.payload.size);
    txPacket(p);
}

bool IrrigationModule::portalStartSurvey(const IrrigationWeb::SurveyStartReq &r)
{
    surveyBeacon.start(millis(), r.intervalS, r.timeoutS, r.latE7, r.lonE7, r.hasCoord);
    return true;
}

void IrrigationModule::portalStopSurvey()
{
    surveyBeacon.stop();
}

size_t IrrigationModule::buildSurveyLog(char *buf, size_t cap)
{
    SurveyPoint tmp[SurveyLog::CAP];
    size_t k = surveyLog.count();
    for (size_t i = 0; i < k; i++)
        tmp[i] = surveyLog.at(i);
    return IrrigationWeb::buildSurvey(tmp, k, millis() / 1000, buf, cap);
}

void IrrigationModule::clearSurveyLog()
{
    surveyLog.clear();
}

void IrrigationModule::svcSendResyncRequest(uint32_t node)
{
    ResyncSeq req = {};
    req.kind = 0; // REQUEST
    meshtastic_MeshPacket *p = allocDataPacket();
    p->to = node;
    uint16_t sz = (uint16_t)encodeResyncSeq(p->decoded.payload.bytes, sizeof(p->decoded.payload.bytes), ++txSeq, req);
    if (!sz) {
        packetPool.release(p);
        return;
    }
    p->decoded.payload.size = sz;
    setServiceFlag(p->decoded.payload.bytes, p->decoded.payload.size);
    txPacket(p);
}

void IrrigationModule::svcExportToConsole()
{
    if (!svc)
        return;
    static char buf[4096];
    size_t n = svc->getVault().exportEnvelope(buf, sizeof buf);
    if (!n) {
        LOG_WARN("Irrigation SERVICO: vault export overflow");
        return;
    }
    buf[n < sizeof buf ? n : sizeof buf - 1] = 0;
    LOG_INFO("Irrigation SERVICO VAULT EXPORT: %s", buf);
}

// ── Fase 8c — portal do device SERVICO (§11.8): accessors dirigidos pelos endpoints ──

bool IrrigationModule::svcIsService() const
{
    return (IrrigationRole)settings.role == IrrigationRole::SERVICO;
}

size_t IrrigationModule::svcPortalListClients(char *buf, size_t cap)
{
    if (!svc)
        return 0;
    IrrigationService::LightProfile cs[16];
    size_t n = svc->getVault().listClients(cs, 16);
    char active[32] = {0};
    svc->getVault().activeId(active, sizeof active);
    return IrrigationWeb::buildClientList(cs, n, active, buf, cap);
}

bool IrrigationModule::svcPortalSelect(const char *id)
{
    if (!svc)
        return false;
    RetunePlan probe;
    if (!svc->planRetune(id, probe)) // valida existência + PSK antes de reiniciar
        return false;
    svc->logService("select", 0, gwTimeAdopted());
    applyRetune(id); // persiste ativo + reboot 3 s (§11.3)
    return true;
}

void IrrigationModule::svcPortalStartScan()
{
    if (!svc)
        return;
    svc->logService("scan", 0, gwTimeAdopted());
    svcEmitProbe(); // limpa scan + broadcast PROBE (8b)
}

size_t IrrigationModule::svcPortalScanResults(char *buf, size_t cap)
{
    if (!svc)
        return 0;
    return IrrigationWeb::buildScanResults(svc->scanResults(), buf, cap);
}

bool IrrigationModule::svcPortalReadConfig(uint32_t node)
{
    if (!svc || !node)
        return false;
    svcReadNode = node;
    svcReadReady = false;
    reasm.reset();
    meshtastic_MeshPacket *p = allocDataPacket();
    p->to = node;
    p->decoded.payload.size =
        (uint16_t)encodeGetConfig(p->decoded.payload.bytes, sizeof(p->decoded.payload.bytes), ++txSeq);
    if (!p->decoded.payload.size) {
        packetPool.release(p);
        return false;
    }
    setServiceFlag(p->decoded.payload.bytes, p->decoded.payload.size);
    txPacket(p);
    svc->logService("get_config", node, gwTimeAdopted());
    return true;
}

void IrrigationModule::handleSvcSetConfigReply(const meshtastic_MeshPacket &mp, const Header &h)
{
    (void)h;
    if (mp.from != svcReadNode)
        return; // resposta de outro nó — ignora
    SetConfig sc;
    if (!decodeSetConfig(mp.decoded.payload.bytes, mp.decoded.payload.size, sc))
        return;
    auto r = reasm.add(mp.from, sc.epoch, sc.crc, sc.totalLen, sc.fragIndex, sc.fragCount, sc.frag, sc.fragLen, millis());
    if (r != FragmentReassembler::Add::COMPLETE)
        return;
    IrrigationSettings blob;
    if (migrateIrrigationSettings(reasm.blob(), reasm.blobLen(), blob)) {
        svcReadBlob = blob; // cacheia p/ o editor; NÃO aplica em si
        svcReadReady = true;
    }
    reasm.reset();
}

bool IrrigationModule::svcPortalConfigReady(uint32_t node)
{
    return svcReadReady && svcReadNode == node;
}

size_t IrrigationModule::svcPortalGetReadConfig(char *buf, size_t cap)
{
    if (!svcReadReady)
        return 0;
    return IrrigationWeb::buildStationConfig(svcReadBlob, buf, cap);
}

bool IrrigationModule::svcPortalWriteConfig(const IrrigationWeb::NodeConfigReq &req)
{
    if (!svc || !req.node)
        return false;
    if (req.route != IrrigationWeb::SvcRoute::DIRECT) {
        // VIA_GATEWAY exigiria um comando gateway-side "configurar estação X"; o wire atual não o tem
        // (SET_CONFIG ao gateway é adotado como config DELE). Follow-on; a rota direta converge via §5.4.
        svc->logService("set_config_gw_unsupported", req.node, gwTimeAdopted());
        return false;
    }
    // DIRECT (§11.6): grava na estação com epoch+1; o gateway adota depois pela regra do maior epoch (§5.4, 8a).
    IrrigationSettings blob = req.config;
    RouteDecision d = decideConfigRoute(false, req.config.configEpoch);
    blob.configEpoch = d.epochToWrite;
    // P2P fallback: sobrepõe a rota compilada nesta cópia local antes de calcular o CRC.
    gwOverlayFallbackRoute(req.node, blob);
    const uint8_t *raw = (const uint8_t *)&blob;
    uint16_t totalLen = (uint16_t)sizeof(IrrigationSettings);
    uint32_t crc = crc32(raw, totalLen);
    uint8_t fragCount = (uint8_t)((totalLen + FRAG_DATA_MAX - 1) / FRAG_DATA_MAX);
    for (uint8_t i = 0; i < fragCount; i++) {
        SetConfig sc = {};
        sc.epoch = blob.configEpoch;
        sc.crc = crc;
        sc.totalLen = totalLen;
        sc.fragIndex = i;
        sc.fragCount = fragCount;
        uint16_t off = (uint16_t)i * FRAG_DATA_MAX;
        sc.fragLen = (uint8_t)((totalLen - off > FRAG_DATA_MAX) ? FRAG_DATA_MAX : (uint8_t)(totalLen - off));
        sc.frag = raw + off;
        meshtastic_MeshPacket *p = allocDataPacket();
        p->to = req.node;
        p->decoded.payload.size =
            (uint16_t)encodeSetConfig(p->decoded.payload.bytes, sizeof(p->decoded.payload.bytes), ++txSeq, sc);
        if (!p->decoded.payload.size) {
            packetPool.release(p);
            return false;
        }
        setServiceFlag(p->decoded.payload.bytes, p->decoded.payload.size);
        txPacket(p);
    }
    svc->logService("set_config_direct", req.node, gwTimeAdopted());
    return true;
}

bool IrrigationModule::svcPortalNodeAction(const IrrigationWeb::NodeAction &a)
{
    if (!svc || !a.node)
        return false;
    switch (a.action) {
    case IrrigationWeb::SvcAction::PULSE: {
        CmdValvula cv{a.valveOrZoneId, 1, a.durationS}; // abrir por durationS (pulso)
        meshtastic_MeshPacket *p = allocDataPacket();
        p->to = a.node;
        p->decoded.payload.size =
            (uint16_t)encodeCmdValvula(p->decoded.payload.bytes, sizeof(p->decoded.payload.bytes), ++txSeq, cv);
        if (!p->decoded.payload.size) {
            packetPool.release(p);
            return false;
        }
        setServiceFlag(p->decoded.payload.bytes, p->decoded.payload.size);
        txPacket(p);
        svc->logService("pulse", a.node, gwTimeAdopted());
        return true;
    }
    case IrrigationWeb::SvcAction::ZONE: {
        RemoteCmd rc{a.valveOrZoneId, (uint8_t)(a.open ? 1 : 0), a.durationS};
        meshtastic_MeshPacket *p = allocDataPacket();
        p->to = a.node;
        p->decoded.payload.size =
            (uint16_t)encodeRemoteCmd(p->decoded.payload.bytes, sizeof(p->decoded.payload.bytes), ++txSeq, rc);
        if (!p->decoded.payload.size) {
            packetPool.release(p);
            return false;
        }
        setServiceFlag(p->decoded.payload.bytes, p->decoded.payload.size);
        txPacket(p);
        svc->logService("zone", a.node, gwTimeAdopted());
        return true;
    }
    case IrrigationWeb::SvcAction::RESYNC:
        svcSendResyncRequest(a.node); // 8b (carimba FLAG_FROM_SERVICE)
        svc->logService("resync", a.node, gwTimeAdopted());
        return true;
    case IrrigationWeb::SvcAction::APPROVE_PAIR:
    default:
        // Aprovação de pareamento pelo device (§11.8) exige intake device-side de PAIR_ANNOUNCE +
        // PairGrant com a PSK do cliente ativo — fluxo não presente na 8b. Follow-on.
        svc->logService("approve_pair_unsupported", a.node, gwTimeAdopted());
        return false;
    }
}

size_t IrrigationModule::svcPortalBuildLog(char *buf, size_t cap)
{
    if (!svcStore)
        return 0;
    return IrrigationWeb::buildServiceLog(svcStore->logReader(), 100, buf, cap);
}

size_t IrrigationModule::svcPortalExport(char *buf, size_t cap)
{
    if (!svc)
        return 0;
    return svc->getVault().exportEnvelope(buf, cap); // envelope multi-cliente (plaintext, §11.7)
}

bool IrrigationModule::svcPortalImport(const char *json, size_t n, bool replace, char *err, size_t errCap)
{
    if (!svc)
        return false;
    bool ok = svc->getVault().importEnvelope(json, n, replace, err, errCap); // valida em staging + merge por id
    if (ok)
        svc->logService(replace ? "import_replace" : "import_merge", 0, gwTimeAdopted());
    return ok;
}

bool IrrigationModule::svcPortalSeedConfig(uint32_t node, IrrigationSettings &out)
{
    if (!svcReadReady || svcReadNode != node)
        return false;
    out = svcReadBlob; // magic/version/role/boundGateway/configEpoch do blob lido → preservados no parse
    return true;
}

size_t IrrigationModule::gwBuildBackup(char *buf, size_t cap)
{
    if (!gwIsGateway())
        return 0;
    // Sub-arrays de config via os builders existentes do painel (DRY, Fase 5a-7b).
    static char zonasB[900], progB[800], interB[700], grupB[700], niveisB[512], remoteB[512];
    IrrigationWeb::buildZones(gateway.zones, zonasB, sizeof zonasB);
    IrrigationWeb::buildPrograms(gateway.scheduler, progB, sizeof progB);
    IrrigationWeb::buildInterlocks(gateway.interlocks, interB, sizeof interB);
    IrrigationWeb::buildGroups(gateway.groups, grupB, sizeof grupB);
    IrrigationWeb::buildLevelControls(gateway.levels, niveisB, sizeof niveisB);
    IrrigationWeb::buildRemote(remoteB, sizeof remoteB, gateway.remoteButtons, gateway.zones);
    // estacoes[] + snapshot_epoch{} a partir do registro de estações.
    static char estB[2048], epoB[600];
    {
        IrrigationWeb::JsonWriter w(estB, sizeof estB);
        w.beginArray();
        for (size_t i = 0; i < gateway.stations.count(); i++) {
            const StationEntry *s = gateway.stations.nodeAt(i);
            if (!s)
                continue;
            char no[12];
            snprintf(no, sizeof no, "!%08x", s->node);
            w.beginObject();
            w.keyStr("no", no);
            w.keyStr("nome", s->name);
            w.keyNum("lat", s->lat);
            w.keyNum("lon", s->lon);
            // Fase 9: config v6 desejada (heartbeat + limiares de bateria) p/ backup lossless.
            // Importador antigo ignora chaves desconhecidas (extractLight faz key-seek).
            IrrigationSettings cfg;
            if (s->desiredEpoch != 0 && migrateIrrigationSettings(s->blob, sizeof(s->blob), cfg)) {
                w.keyNum("hbMinutes", cfg.hbMinutes);
                w.keyNum("vbatAvisoCentiV", cfg.vbatAvisoCentiV);
                w.keyNum("vbatCriticaCentiV", cfg.vbatCriticaCentiV);
            }
            w.endObject();
        }
        w.endArray();
        w.done();
    }
    {
        IrrigationWeb::JsonWriter w(epoB, sizeof epoB);
        w.beginObject();
        for (size_t i = 0; i < gateway.stations.count(); i++) {
            const StationEntry *s = gateway.stations.nodeAt(i);
            if (!s)
                continue;
            char no[12];
            snprintf(no, sizeof no, "!%08x", s->node);
            w.keyNum(no, (int64_t)s->desiredEpoch);
        }
        w.endObject();
        w.done();
    }
    // PSK do canal primário → base64.
    const meshtastic_ChannelSettings &prim = channels.getPrimary();
    char pskB[48] = {0};
    if (prim.psk.size > 0)
        IrrigationService::base64Encode(prim.psk.bytes, prim.psk.size, pskB, sizeof pskB);
    const char *chName = channels.getName(channels.getPrimaryIndex());
    IrrigationService::BackupSource s{};
    s.id = "gateway"; // identidade default; o operador renomeia o cliente no cofre
    s.nome = chName;
    s.canalNome = chName;
    s.pskB64 = pskB;
    s.preset = (uint8_t)config.lora.modem_preset;
    s.gateway = nodeDB->getNodeNum();
    s.estacoesJson = estB;
    s.snapshotEpochJson = epoB;
    s.zonasJson = zonasB;
    s.programasJson = progB;
    s.intertravamentosJson = interB;
    s.gruposJson = grupB;
    s.sensorNamesJson = "[]"; // nomes de sensor: follow-up (sem builder dedicado)
    s.niveisJson = niveisB;
    s.remoteButtonsJson = remoteB;
    static char clientB[6144];
    size_t cn = IrrigationService::buildClientBackup(s, clientB, sizeof clientB);
    if (!cn)
        return 0;
    clientB[cn < sizeof clientB ? cn : sizeof clientB - 1] = 0;
    // Envelope multi-cliente de 1 cliente (formato de import do cofre §11.7).
    IrrigationWeb::JsonWriter w(buf, cap);
    w.beginObject();
    w.keyStr("fmt", "irrig-vault");
    w.keyNum("version", 1);
    w.key("clients");
    w.beginArray();
    w.raw(clientB);
    w.endArray();
    w.endObject();
    return w.done();
}

void IrrigationModule::sendEvento(uint8_t code, uint32_t arg)
{
    Evento ev = {code, arg};
    meshtastic_MeshPacket *p = allocDataPacket();
    p->to = settings.boundGateway ? settings.boundGateway : NODENUM_BROADCAST;
    p->decoded.payload.size =
        (uint16_t)encodeEvento(p->decoded.payload.bytes, sizeof(p->decoded.payload.bytes), ++txSeq, ev);
    if (!p->decoded.payload.size) {
        packetPool.release(p);
        return;
    }
    txPacket(p);
}

// Janela de acesso (spec 2026-08-11): traduz o SHORT press num nó elegível.
// BLE vivo -> reabre a janela in-loco (portal + BLE seguem de pé). BLE já
// liberado (release sticky) -> só um reboot reabre a janela; agenda-o com LED de
// confirmação. Fora do regime elegível a política devolve NONE (no-op).
void IrrigationModule::applyAccessWindowShort()
{
    using Action = AccessWindowPolicy::ButtonAction;
    bool eligible = AccessWindowPolicy::eligible((IrrigationRole)settings.role, provisioned);
    switch (AccessWindowPolicy::buttonShortAction(eligible, bleReleasedThisBoot)) {
    case Action::REOPEN_LIVE:
        portal.requestOpen(millis());
        LOG_INFO("Irrigation: access window reopened (portal + BLE live)");
        break;
    case Action::REBOOT_TO_REOPEN:
        led.setMode(LedPatternController::Mode::PAIRING); // confirmação visual antes do reboot
        LOG_INFO("Irrigation: BLE released — rebooting in 1.5 s to reopen access window");
        rebootAtMsec = millis() + 1500;
        break;
    case Action::NONE:
    default:
        break;
    }
}

// Decision §6: button gestures per role/state.
void IrrigationModule::onButtonEvent(ButtonGestureDetector::Event ev)
{
    using Ev = ButtonGestureDetector::Event;
    IrrigationRole role = (IrrigationRole)settings.role;
    if (ev == Ev::HOLD_10S) { // factory reset valid in any role/state
        factoryReset();
        return;
    }
    if (role == IrrigationRole::ESTACAO && settings.boundGateway == 0) {
        // Factory node: any button event opens the pairing window (spec §8.6).
        stationPairing.openWindow(millis());
        refreshLedMode();
        LOG_INFO("Irrigation: pairing window open (2 min)");
        return;
    }
    if (role == IrrigationRole::GATEWAY) {
        if (ev == Ev::SHORT) {
            gatewayPairing.openWindow(millis());
            refreshLedMode();
            LOG_INFO("Irrigation: gateway accept window open (2 min)");
        } else if (ev == Ev::LONG_3S) {
            logFarmKey(); // export PSK to service device vault (spec §11.2)
        }
        return;
    }
    if (role == IrrigationRole::SERVICO) {
        // Fase 8b: device SERVICO. LONG = despeja o cofre no serial (bancada §11.7);
        // SHORT = sobe o portal (abas Clientes/Rede/Log chegam na 8c).
        if (ev == Ev::LONG_3S)
            svcExportToConsole();
        else if (ev == Ev::SHORT)
            portal.requestOpen(millis());
        return;
    }
    if (role == IrrigationRole::REPETIDOR) {
        // Repetidor provisionado: SHORT reabre a janela de acesso (spec 2026-08-11).
        if (ev == Ev::SHORT)
            applyAccessWindowShort();
        return;
    }
    if (role != IrrigationRole::ESTACAO)
        return;
    // Paired station gestures.
    switch (ev) {
    case Ev::SHORT:
        applyAccessWindowShort(); // Janela de acesso: REOPEN_LIVE ou REBOOT_TO_REOPEN (spec 2026-08-11)
        break;
    case Ev::DOUBLE:
        if (valves.isOpen(0)) {
            valves.close(0);
            sendEvento(EV_MANUAL_CLOSE);
            // §8.9: fechamento manual por botão físico.
            auditEvent(AuditOrigin::BOTAO_FISICO, AuditAction::FECHAR, 0, AuditResult::OK);
        } else if (valves.open(0, DEFAULT_MANUAL_OPEN_S, settings.maxOpenConfigS, millis()) ==
                   ValveController::Result::OK) {
            sendEvento(EV_MANUAL_OPEN, DEFAULT_MANUAL_OPEN_S);
            // §8.9: abertura manual por botão físico.
            auditEvent(AuditOrigin::BOTAO_FISICO, AuditAction::ABRIR, 0, AuditResult::OK);
        } else {
            // §8.9: abertura manual rejeitada (bateria baixa ou configuração).
            auditEvent(AuditOrigin::BOTAO_FISICO, AuditAction::ABRIR, 0, AuditResult::NACK);
        }
        break;
    case Ev::LONG_3S:
        if (valves.open(0, 10, settings.maxOpenConfigS, millis()) == ValveController::Result::OK) {
            sendEvento(EV_TEST_PULSE);
            // §8.9: pulso de teste por botão físico.
            auditEvent(AuditOrigin::BOTAO_FISICO, AuditAction::PULSO, 0, AuditResult::OK);
        } else {
            auditEvent(AuditOrigin::BOTAO_FISICO, AuditAction::PULSO, 0, AuditResult::NACK);
        }
        break;
    default:
        break;
    }
}

// Decision §5: LED priority table (spec §8.7).
// PAIRING > BATTERY_SOS > OUTPUT_OPEN > CONFIG_PENDING > NO_GATEWAY > NORMAL.
// NO_GATEWAY heuristic: bound but never received a packet from the gateway since boot.
// Refined in Phase 4 with a proper heartbeat timeout.
void IrrigationModule::refreshLedMode()
{
    using Mode = LedPatternController::Mode;
    uint16_t vbat = batteryCentiV();
    if (stationPairing.state() == StationPairing::State::WINDOW || gatewayPairing.windowOpen())
        led.setMode(Mode::PAIRING);
    else if (vbat != 0 && vbat < settings.vbatMinAbrirCentiV)
        led.setMode(Mode::BATTERY_SOS);
    else if (valves.stateBitmap() != 0)
        led.setMode(Mode::OUTPUT_OPEN);
    else if (safeMode)
        led.setMode(Mode::CONFIG_PENDING);
    else if (settings.boundGateway != 0 && lastGatewayRxMs == 0)
        led.setMode(Mode::NO_GATEWAY);
    else
        led.setMode(Mode::NORMAL);
}

// ---------------------------------------------------------------------------
// Allowlist persistence — same staged-write pattern as IrrigationSettings.
// formato = magic(4)+versão(1)+count(1)+ids LE (host little-endian).
// Buffer: MAGIC(4) + versão(1) + count(1) + ids[MAX](4*16) = 70 bytes max.
// ---------------------------------------------------------------------------

bool IrrigationModule::loadAllowlist()
{
#ifdef FSCom
    auto f = FSCom.open(ALLOWLIST_PATH, FILE_O_READ);
    if (!f)
        return false;
    uint8_t buf[6 + Allowlist::MAX * 4];
    size_t n = f.read(buf, sizeof(buf));
    f.close();
    return allowlist.deserialize(buf, n);
#else
    return false;
#endif
}

bool IrrigationModule::saveAllowlist()
{
#ifdef FSCom
    uint8_t buf[6 + Allowlist::MAX * 4];
    size_t n = allowlist.serialize(buf, sizeof(buf));
    if (n == 0)
        return false;
    // Staged write: write to .tmp then rename, so a power failure mid-write cannot
    // corrupt the active file (same pattern as saveIrrigationSettings).
    auto f = FSCom.open(ALLOWLIST_TMP, FILE_O_WRITE);
    if (!f)
        return false;
    size_t w = f.write(buf, n);
    f.close();
    if (w != n) {
        FSCom.remove(ALLOWLIST_TMP);
        return false;
    }
    FSCom.remove(ALLOWLIST_PATH);
    if (!renameFile(ALLOWLIST_TMP, ALLOWLIST_PATH)) {
        LOG_ERROR("Irrigation allowlist rename failed");
        FSCom.remove(ALLOWLIST_TMP);
        return false;
    }
    return true;
#else
    return false;
#endif
}

// ---------------------------------------------------------------------------
// Mini-log de auditoria (§8.9) — staged-write, espelha padrão da allowlist.
// Buffer: magic(4) + count(2) + reservado(2) + 100×16 bytes + CRC32(4) = 1612 bytes.
// ---------------------------------------------------------------------------

void IrrigationModule::auditEvent(AuditOrigin o, AuditAction a, uint8_t target, AuditResult res, uint32_t node, uint32_t seq)
{
    AuditRecord r = {};
    computeLocalSecs(r.tsSecs); // 0 se sem RTC no momento (tolerado pela spec)
    r.origin = (uint8_t)o;
    r.action = (uint8_t)a;
    r.target = target;
    r.result = (uint8_t)res;
    r.node = node;
    r.seq = seq;
    audit.append(r);
    auditDirty = true;
    // Fase 6b Task 16: persiste no log de flash do gateway (meses de histórico).
    // O FlashAuditRing grava header a cada append — não passa pelo flush de 60s.
    if ((IrrigationRole)settings.role == IrrigationRole::GATEWAY)
        auditFlash.append(r);
}

bool IrrigationModule::loadAuditLog()
{
#ifdef FSCom
    auto f = FSCom.open(AUDIT_LOG_PATH, FILE_O_READ);
    if (!f)
        return false;
    uint8_t raw[8 + AUDIT_CAP * 16 + 4];
    size_t n = f.read(raw, sizeof(raw));
    f.close();
    return audit.deserialize(raw, n);
#else
    return false;
#endif
}

bool IrrigationModule::saveAuditLog()
{
#ifdef FSCom
    uint8_t raw[8 + AUDIT_CAP * 16 + 4];
    size_t n = audit.serialize(raw, sizeof(raw));
    if (n == 0)
        return false;
    // Staged write: grava em .tmp depois renomeia — falha de energia não corrompe o arquivo ativo.
    auto f = FSCom.open(AUDIT_LOG_TMP, FILE_O_WRITE);
    if (!f)
        return false;
    size_t w = f.write(raw, n);
    f.close();
    if (w != n) {
        FSCom.remove(AUDIT_LOG_TMP);
        return false;
    }
    FSCom.remove(AUDIT_LOG_PATH);
    if (!renameFile(AUDIT_LOG_TMP, AUDIT_LOG_PATH)) {
        LOG_ERROR("Irrigation auditlog rename failed");
        FSCom.remove(AUDIT_LOG_TMP);
        return false;
    }
    return true;
#else
    return false;
#endif
}

// ---------------------------------------------------------------------------
// Gateway state persistence (Task 6, decisão §5) — staged-write, 4 arquivos.
// Helper macro para não repetir o padrão 4×.
// ---------------------------------------------------------------------------

// Staged-write genérico: serializa com fn, grava em tmp, rename.
// Tamanho máximo dos buffers:
//   stations: MAGIC(4)+ver(1)+count(1)+16*87 = 1398 bytes → 1400
//   zones:    MAGIC(4)+ver(1)+count(1)+24*29 = 702 bytes (buffer = 6 + MAX*29)
//   programs: MAGIC(4)+ver(1)+count(1)+8*... = ~600 bytes → 700
//   mirror:   MAGIC(4)+ver(1)+1             = 6    bytes → 16

static bool stagedWrite(const char *tmp, const char *path, const uint8_t *buf, size_t n)
{
#ifdef FSCom
    if (n == 0)
        return false;
    auto f = FSCom.open(tmp, FILE_O_WRITE);
    if (!f)
        return false;
    size_t w = f.write(buf, n);
    f.close();
    if (w != n) {
        FSCom.remove(tmp);
        return false;
    }
    FSCom.remove(path);
    if (!renameFile(tmp, path)) {
        LOG_ERROR("Irrigation rename failed: %s", path);
        FSCom.remove(tmp);
        return false;
    }
    return true;
#else
    (void)tmp; (void)path; (void)buf; (void)n;
    return false;
#endif
}

static bool stagedRead(const char *path, uint8_t *buf, size_t cap, size_t &outN)
{
#ifdef FSCom
    auto f = FSCom.open(path, FILE_O_READ);
    if (!f)
        return false;
    outN = f.read(buf, cap);
    f.close();
    return outN > 0;
#else
    (void)path; (void)buf; (void)cap;
    outN = 0;
    return false;
#endif
}

bool IrrigationModule::loadGatewayState()
{
    size_t n = 0;
    bool ok = true;

    // Buffers de (de)serialização vão pro heap: somados na stack passavam de ~5 KB
    // (SERIALIZED_MAX=3894 + zonas + programas) e estouravam o canário da stack do
    // loopTask no boot do gateway (bootloop / Double exception). Um único buffer do
    // tamanho do maior bloco, reutilizado, resolve.
    constexpr size_t CAP = StationRegistry::SERIALIZED_MAX;
    uint8_t *buf = (uint8_t *)malloc(CAP);
    if (!buf)
        return false;

    // Stations
    if (stagedRead(GW_STATIONS_PATH, buf, StationRegistry::SERIALIZED_MAX, n))
        ok &= gateway.stations.deserialize(buf, n);
    // Zones
    if (stagedRead(GW_ZONES_PATH, buf, 6 + ZoneTable::MAX * 29, n))
        ok &= gateway.zones.deserialize(buf, n);
    // Programs
    if (stagedRead(GW_PROGRAMS_PATH, buf, 700, n))
        ok &= gateway.scheduler.deserialize(buf, n);
    // Mirror (only flag)
    if (stagedRead(GW_MIRROR_PATH, buf, 16, n))
        ok &= gateway.mirror.deserialize(buf, n);

    free(buf);
    return ok;
}

bool IrrigationModule::saveGatewayState()
{
    bool ok = true;
    // Mesmo motivo do loadGatewayState: buffer único no heap em vez de ~5 KB de stack.
    constexpr size_t CAP = StationRegistry::SERIALIZED_MAX;
    uint8_t *buf = (uint8_t *)malloc(CAP);
    if (!buf)
        return false;
    {
        size_t n = gateway.stations.serialize(buf, StationRegistry::SERIALIZED_MAX);
        ok &= stagedWrite(GW_STATIONS_TMP, GW_STATIONS_PATH, buf, n);
    }
    {
        size_t n = gateway.zones.serialize(buf, 6 + ZoneTable::MAX * 29);
        ok &= stagedWrite(GW_ZONES_TMP, GW_ZONES_PATH, buf, n);
    }
    {
        size_t n = gateway.scheduler.serialize(buf, 700);
        ok &= stagedWrite(GW_PROGRAMS_TMP, GW_PROGRAMS_PATH, buf, n);
    }
    {
        size_t n = gateway.mirror.serialize(buf, 16);
        ok &= stagedWrite(GW_MIRROR_TMP, GW_MIRROR_PATH, buf, n);
    }
    free(buf);
    ok &= saveRemoteButtons(); // Modo Remoto: persiste associações botoeira→saída
    return ok;
}

// ---------------------------------------------------------------------------
// Fase 6b: persistência da tabela de intertravamentos (arquivo separado).
// ---------------------------------------------------------------------------

bool IrrigationModule::loadInterlocks()
{
    size_t n = 0;
    uint8_t buf[6 + InterlockTable::MAX * 48]; // margem folgada para serialização futura
    if (!stagedRead(GW_INTERLOCKS_PATH, buf, sizeof(buf), n))
        return false; // arquivo ausente na primeira inicialização — ok, tabela vazia
    return gateway.interlocks.deserialize(buf, n);
}

bool IrrigationModule::saveInterlocks()
{
    uint8_t buf[6 + InterlockTable::MAX * 48];
    size_t n = gateway.interlocks.serialize(buf, sizeof(buf));
    return stagedWrite(GW_INTERLOCKS_TMP, GW_INTERLOCKS_PATH, buf, n);
}

// ---------------------------------------------------------------------------
// Fase 6b Task 18: persistência de nomes de sensores (arquivo separado).
// Espelha loadInterlocks/saveInterlocks EXATAMENTE.
// ---------------------------------------------------------------------------

bool IrrigationModule::loadSensorNames()
{
    size_t n = 0;
    uint8_t buf[4 + 2 + SensorNameTable::MAX * sizeof(SensorName) + 4]; // magic+count+MAX×entry+crc
    if (!stagedRead(GW_SENSORNAMES_PATH, buf, sizeof(buf), n))
        return false; // arquivo ausente na primeira inicialização — ok, tabela vazia
    return gateway.sensorNames.deserialize(buf, n);
}

bool IrrigationModule::saveSensorNames()
{
    uint8_t buf[4 + 2 + SensorNameTable::MAX * sizeof(SensorName) + 4];
    size_t n = gateway.sensorNames.serialize(buf, sizeof(buf));
    return stagedWrite(GW_SENSORNAMES_TMP, GW_SENSORNAMES_PATH, buf, n);
}

// ---------------------------------------------------------------------------
// Fase 7a: persistência da tabela de grupos hidráulicos (arquivo separado).
// Espelha loadInterlocks/saveInterlocks EXATAMENTE.
// ---------------------------------------------------------------------------

bool IrrigationModule::loadGroups()
{
    size_t n = 0;
    uint8_t buf[6 + HydraulicGroupTable::MAX * 41 + 4]; // margem folgada (entry real 39 B)
    if (!stagedRead(GW_GRUPOS_PATH, buf, sizeof(buf), n))
        return false; // ausente na 1ª init — ok, tabela vazia
    return gateway.groups.deserialize(buf, n);
}

bool IrrigationModule::saveGroups()
{
    uint8_t buf[6 + HydraulicGroupTable::MAX * 41 + 4];
    size_t n = gateway.groups.serialize(buf, sizeof(buf));
    return stagedWrite(GW_GRUPOS_TMP, GW_GRUPOS_PATH, buf, n);
}

// Persistência da tabela de controle de nível (arquivo separado). Espelha loadGroups/saveGroups.
bool IrrigationModule::loadLevels()
{
    size_t n = 0;
    uint8_t buf[6 + LevelControlTable::MAX * sizeof(LevelRule) + 4];
    if (!stagedRead(GW_NIVEIS_PATH, buf, sizeof(buf), n))
        return false; // ausente na 1ª init — ok, tabela vazia
    return gateway.levels.deserialize(buf, n);
}

bool IrrigationModule::saveLevels()
{
    uint8_t buf[6 + LevelControlTable::MAX * sizeof(LevelRule) + 4];
    size_t n = gateway.levels.serialize(buf, sizeof(buf));
    return stagedWrite(GW_NIVEIS_TMP, GW_NIVEIS_PATH, buf, n);
}

// Persistência de clima (config + regras). Espelha loadLevels/saveLevels.
bool IrrigationModule::loadWeather()
{
    bool ok = true;
    size_t n = 0;
    {
        uint8_t buf[WeatherConfig::SERIALIZED];
        if (stagedRead(GW_WEATHERCFG_PATH, buf, sizeof(buf), n))
            ok &= gateway.weatherConfig.deserialize(buf, n);
    }
    {
        uint8_t buf[4 + 2 + WeatherRuleTable::MAX * sizeof(WeatherRule) + 4];
        if (stagedRead(GW_WEATHERRULES_PATH, buf, sizeof(buf), n))
            ok &= gateway.weatherRules.deserialize(buf, n);
    }
    return ok;
}

bool IrrigationModule::saveWeatherConfig()
{
    uint8_t buf[WeatherConfig::SERIALIZED];
    size_t n = gateway.weatherConfig.serialize(buf, sizeof(buf));
    return stagedWrite(GW_WEATHERCFG_TMP, GW_WEATHERCFG_PATH, buf, n);
}

bool IrrigationModule::saveWeatherRules()
{
    uint8_t buf[4 + 2 + WeatherRuleTable::MAX * sizeof(WeatherRule) + 4];
    size_t n = gateway.weatherRules.serialize(buf, sizeof(buf));
    return stagedWrite(GW_WEATHERRULES_TMP, GW_WEATHERRULES_PATH, buf, n);
}

// Gate de supressão climática: retorna veredito para a zona (OR zona-direta + grupo-dono).
// Fail-open: sem config habilitada, sem RTC ou cache velho → WeatherVerdict{} (suppress=false).
WeatherVerdict IrrigationModule::weatherVerdictForZone(uint8_t zoneId)
{
    if (!gateway.weatherConfig.enabled)
        return WeatherVerdict{};
    uint32_t nowLocal = 0;
    computeLocalSecs(nowLocal);
    const WeatherCache &cache = gateway.weatherCache;
    const WeatherRuleTable &rules = gateway.weatherRules;
    const uint16_t ttl = gateway.weatherConfig.staleTtlH;
    // 1) veredito direto por zona
    WeatherVerdict v = WeatherEngine::zoneVerdict(zoneId, cache, rules, nowLocal, ttl);
    if (v.suppress)
        return v;
    // 2) veredito pelo grupo-dono (se a zona for membro de algum grupo hidráulico).
    //    Usa gateway.groups.byZone() — mesmo acesso que routeZoneToGroup.
    const HydraulicGroup *hg = gateway.groups.byZone(zoneId);
    if (hg) {
        WeatherVerdict gv = WeatherEngine::groupVerdict(hg->id, cache, rules, nowLocal, ttl);
        if (gv.suppress)
            return gv;
    }
    return WeatherVerdict{};
}

// ---------------------------------------------------------------------------
// Task 5: controle de nível por boia — executor de zona, tick, apply-helpers.
// ---------------------------------------------------------------------------

// Abre/fecha uma zona pelo caminho canônico: grupo hidráulico se for zona-membro,
// senão comando direto de válvula/GPO. Espelha o bloco OPEN/CLOSE do scheduler.
void IrrigationModule::gwDriveZone(uint8_t zoneId, bool open, uint16_t durS)
{
    const Zone *z = gateway.zones.byId(zoneId);
    if (!z)
        return;
    const StationEntry *st = gateway.stations.byNode(z->node);
    uint8_t attempts = (st && st->retries > 0) ? st->retries : 3;
    if (open) {
        if (routeZoneToGroup(zoneId, true, durS)) // grupo cuida da coreografia da bomba
            return;
        // Zona livre (bomba fora de grupo): o caminho direto NÃO passa por routeZoneToGroup,
        // então repete aqui o veto de intertravamento que todo open canônico aplica — senão o
        // controle de nível reabriria uma bomba fechada+bloqueada por segurança (review I1).
        if (gateway.interlockEngine.zoneVerdict(zoneId).bloqueada) {
            auditEvent(AuditOrigin::INTERTRAVAMENTO, AuditAction::CMD_REJEITADO, zoneId, AuditResult::NACK, z->node);
            return;
        }
        gwSendValveCmd(z->node, z->index, z->tipo, 1, durS, z->id, attempts);
    } else {
        if (routeZoneToGroup(zoneId, false, 0))
            return;
        gateway.openGate.release(zoneId);
        gwSendValveCmd(z->node, z->index, z->tipo, 0, 0, z->id, 1);
    }
}

// Avalia as regras de controle de nível 1×/tick. Resolve cada boia no cache de
// telemetria (leitura digital + frescor via atMs) e executa os intents do engine.
void IrrigationModule::gwLevelTick(uint32_t nowMs)
{
    if (gateway.levels.count() == 0)
        return;

    LevelInput inputs[LevelControlTable::MAX];
    for (size_t i = 0; i < gateway.levels.count() && i < LevelControlTable::MAX; i++) {
        const LevelRule *r = gateway.levels.ruleAt(i);
        LevelInput in{};
        const StationTelemetry *t = gateway.telemetry.byNode(r->sensorNode);
        if (t && t->node) {
            for (uint8_t k = 0; k < t->sensorCount && k < IrrigationProto::HB_MAX_SENSORS; k++)
                if (t->sensors[k].id == r->sensorIdx) {
                    in.present = true;
                    in.active = (t->sensors[k].valueCenti != 0);
                    break;
                }
            in.fresh = ((uint32_t)(nowMs - t->atMs) <= (uint32_t)r->staleTimeoutS * 1000u);
        }
        inputs[i] = in;
    }

    LevelIntent out[LevelControlTable::MAX];
    size_t n = gateway.levelEngine.evaluate(gateway.levels, inputs, gateway.levels.count(), nowMs, out,
                                            LevelControlTable::MAX);
    for (size_t i = 0; i < n; i++) {
        const LevelIntent &it = out[i];
        switch (it.act) {
        case LevelIntent::Act::START:
        case LevelIntent::Act::RENEW:
            gwDriveZone(it.zoneId, true, it.durS);
            if (it.act == LevelIntent::Act::START) {
                const Zone *z = gateway.zones.byId(it.zoneId);
                auditEvent(AuditOrigin::NIVEL, AuditAction::ABRIR, it.zoneId, AuditResult::OK, z ? z->node : 0);
            }
            break;
        case LevelIntent::Act::STOP:
            gwDriveZone(it.zoneId, false, 0);
            {
                const Zone *z = gateway.zones.byId(it.zoneId);
                auditEvent(AuditOrigin::NIVEL, AuditAction::FECHAR, it.zoneId, AuditResult::OK, z ? z->node : 0);
            }
            break;
        case LevelIntent::Act::STALE_STOP: {
            gwDriveZone(it.zoneId, false, 0);
            const Zone *z = gateway.zones.byId(it.zoneId);
            auditEvent(AuditOrigin::NIVEL, AuditAction::FECHAR, it.zoneId, AuditResult::TIMEOUT, z ? z->node : 0);
            const LevelRule *r = gateway.levels.byId(it.ruleId);
            Alert a{};
            a.type = AlertType::NIVEL_BOIA_MUDA;
            a.node = r ? r->sensorNode : 0;
            a.arg = it.zoneId;
            a.atMs = nowMs;
            gateway.alerts.push(a);
            break;
        }
        case LevelIntent::Act::NONE:
            break;
        }
    }
}

bool IrrigationModule::gwApplyLevelUpsert(LevelRule &r, char *err, size_t errCap)
{
    if (r.id == 0) { // aloca menor id livre 1..MAX
        for (uint8_t cand = 1; cand <= LevelControlTable::MAX; cand++)
            if (!gateway.levels.byId(cand)) {
                r.id = cand;
                break;
            }
        if (r.id == 0) {
            snprintf(err, errCap, "tabela de niveis cheia");
            return false;
        }
    }
    if (!gateway.levels.upsert(r)) {
        snprintf(err, errCap, "tabela de niveis cheia");
        return false;
    }
    saveLevels();
    return true;
}

bool IrrigationModule::gwApplyLevelDelete(uint8_t id)
{
    if (!gateway.levels.removeById(id))
        return false;
    saveLevels();
    return true;
}

// ---------------------------------------------------------------------------
// Fase 6b, Task 14b: reconstrói e empurra regras locais de intertravamento
// para cada estação conhecida. Deve ser chamado no init (após loadInterlocks +
// loadGatewayState) e após mutações na tabela de interlocks (Task 18).
//
// Epoch idiom: o gateway nunca "inventa" um epoch novo; ele usa
//   entry->desiredEpoch + 1
// para sinalizar que o blob foi modificado pelo gateway, superando o epoch
// que a estação já conhece. O guard de memcmp garante que reboots sem
// mudança real não causam epoch-bump nem churn de push.
// ---------------------------------------------------------------------------
void IrrigationModule::gwRebuildLocalInterlocks()
{
    bool anyChanged = false;

    for (size_t si = 0; si < gateway.stations.count(); si++) {
        // Acessa a entrada mutável (por índice de ocupação).
        // nodeAt() retorna const; precisamos do ponteiro mutável via mutableByNode.
        const StationEntry *centry = gateway.stations.nodeAt(si);
        if (!centry || centry->node == 0)
            continue;
        StationEntry *entry = gateway.stations.mutableByNode(centry->node);
        if (!entry)
            continue;

        // Só faz sentido modificar entradas que já receberam blob válido (desiredEpoch != 0).
        // Se desiredEpoch == 0 a entrada ainda não tem blob e não deve ser tocada (§5.4).
        if (entry->desiredEpoch == 0)
            continue;

        // 1. Carrega a config desejada atual do blob.
        IrrigationSettings s;
        if (!migrateIrrigationSettings(entry->blob, sizeof(entry->blob), s))
            continue;

        // 2. Guarda o estado anterior dos slots locais para comparação final.
        IrrigationSettings::LocalInterlock oldRules[IrrigationSettings::MAX_LOCAL_INTERLOCKS];
        memcpy(oldRules, s.localInterlocks, sizeof(oldRules));

        // 3. Zera os slots (serão recomputados a seguir).
        for (auto &li : s.localInterlocks)
            li = {};

        // 4. Percorre todas as regras de intertravamento do gateway e calcula
        //    as máscaras de saída locais para esta estação.
        uint8_t nextSlot = 0;
        for (size_t ri = 0; ri < InterlockTable::MAX && nextSlot < IrrigationSettings::MAX_LOCAL_INTERLOCKS; ri++) {
            const InterlockRule *r = gateway.interlocks.ruleAtSlot(ri);
            if (!r || r->id == 0)
                continue; // slot vazio
            if (r->tipo != IL_SENSOR)
                continue; // só regras de sensor geram réplica local
            if (r->node != entry->node)
                continue; // regra pertence a outra estação

            // Calcula quais saídas desta estação são cobertas pela regra.
            uint8_t valvMask = 0, gpoMask = 0;
            for (size_t zi = 0; zi < gateway.zones.count(); zi++) {
                const Zone *z = gateway.zones.zoneAt(zi);
                if (!z || z->node != entry->node)
                    continue;
                bool coberta = r->todas;
                if (!coberta) {
                    for (uint8_t k = 0; k < 8; k++) {
                        if (r->zoneIds[k] == 0)
                            break;
                        if (r->zoneIds[k] == z->id) {
                            coberta = true;
                            break;
                        }
                    }
                }
                if (!coberta)
                    continue;
                if (z->tipo == 1)
                    gpoMask |= (uint8_t)(1u << (z->index & 7));
                else
                    valvMask |= (uint8_t)(1u << (z->index & 7));
            }

            // Se a regra não afeta nenhuma saída local desta estação, pula.
            if (!valvMask && !gpoMask)
                continue;

            // Preenche o próximo slot livre.
            IrrigationSettings::LocalInterlock &li = s.localInterlocks[nextSlot++];
            li.sensorIdx       = r->sensorIdx;
            li.condicao        = r->condicao;
            li.acao            = r->acao;
            li.saidasValvMask  = valvMask;
            li.valorCenti      = r->valorCenti;
            li.histereseCenti  = r->histereseCenti;
            li.saidasGpoMask   = gpoMask;
            li.pad             = 0;
        }

        // 5. Verifica se algo mudou (guard contra boot-churn).
        if (memcmp(oldRules, s.localInterlocks, sizeof(oldRules)) == 0)
            continue; // sem mudança: não toca o epoch nem o blob

        // 6. Escreve o blob de volta (version e magic vêm intactos do migrate→v5).
        //    Epoch sobe em +1 para sinalizar ao mecanismo de reconciliação que o
        //    gateway quer empurrar esta config atualizada para a estação.
        memcpy(entry->blob, &s, sizeof(s));
        entry->desiredEpoch += 1;
        anyChanged = true;
        LOG_INFO("Irrigation GW: rebuilt local interlocks for node=0x%08x (%u slots), epoch→%u",
                 entry->node, nextSlot, entry->desiredEpoch);
    }

    // 7. Persiste o estado do gateway uma única vez se qualquer estação mudou.
    if (anyChanged)
        saveGatewayState();
}

// ---------------------------------------------------------------------------
// Gateway engine — handlers e tick (Task 6, decisões 1–6)
// ---------------------------------------------------------------------------

// Decisão §1: envia CmdValvula ou CmdGpo e registra no tracker.
uint32_t IrrigationModule::gwSendValveCmd(uint32_t node, uint8_t index, uint8_t tipo, uint8_t action, uint16_t durationS,
                                          uint8_t zoneId, uint8_t attempts, AuditOrigin origin)
{
    // Alvo = próprio gateway ⇒ aciona a saída LOCAL diretamente (sem rádio).
    if (isLocalTarget(node, nodeDB->getNodeNum())) {
        // Modo seguro: bloqueia ativação (paridade com a estação); desligar segue permitido.
        if (safeMode && action == 1) {
            auditEvent(origin, tipo == 1 ? AuditAction::GPO_ON : AuditAction::ABRIR, index, AuditResult::NACK, node);
            return 0;
        }
        if (tipo == 1) {
            gpos.command(index, action, durationS, millis());
        } else if (action) {
            valves.open(index, durationS, 0 /*teto compilado; clamp de maxMin já no chamador*/, millis());
        } else {
            valves.close(index);
        }
        auditEvent(origin,
                   action ? (tipo == 1 ? AuditAction::GPO_ON : AuditAction::ABRIR)
                          : (tipo == 1 ? AuditAction::GPO_OFF : AuditAction::FECHAR),
                   index, AuditResult::OK, node);
        uint32_t usedSeq = ++txSeq;
        // Enfileira ACK sintético (drenado no gwTick, após noteSent do motor de grupos).
        if (pendingLocalAckCount < 8) {
            pendingLocalAck[pendingLocalAckCount].node = node;
            pendingLocalAck[pendingLocalAckCount].seq = usedSeq;
            pendingLocalAckCount++;
        }
        LOG_DEBUG("Irrigation GW: drive LOCAL zone=%u idx=%u tipo=%u action=%u dur=%u", zoneId, index, tipo, action,
                  durationS);
        return usedSeq;
    }

    meshtastic_MeshPacket *p = allocDataPacket();
    p->to = node;
    uint32_t usedSeq = ++txSeq; // mesmo seq p/ CmdGpo/CmdValvula e o tracker.track abaixo
    if (tipo == 1) {
        CmdGpo cmd = {};
        cmd.gpoId = index;
        cmd.action = action;
        cmd.durationS = durationS;
        p->decoded.payload.size = (uint16_t)encodeCmdGpo(p->decoded.payload.bytes, sizeof(p->decoded.payload.bytes), usedSeq, cmd);
    } else {
        CmdValvula cmd = {};
        cmd.valveId = index;
        cmd.action = action;
        cmd.durationS = durationS;
        p->decoded.payload.size = (uint16_t)encodeCmdValvula(p->decoded.payload.bytes, sizeof(p->decoded.payload.bytes), usedSeq, cmd);
    }
    if (!p->decoded.payload.size) {
        packetPool.release(p);
        return 0;
    }
    txPacket(p);
    gateway.tracker.track(usedSeq, node, zoneId, action, durationS, attempts, millis());
    LOG_DEBUG("Irrigation GW: sent cmd zone=%u node=0x%08x action=%u dur=%u", zoneId, node, action, durationS);
    return usedSeq;
}

// Fase 6b Task 15: envia MSG_CMD_MAINT a uma estação para abrir/fechar janela de manutenção do tamper.
// minutes == 0 fecha a janela imediatamente. Task 18 chamará este helper do endpoint.
void IrrigationModule::gwSendMaintWindow(uint32_t node, uint16_t minutes)
{
    CmdMaint cmd = {};
    cmd.durationMin = minutes;
    meshtastic_MeshPacket *p = allocDataPacket();
    p->to = node;
    p->decoded.payload.size =
        (uint16_t)encodeCmdMaint(p->decoded.payload.bytes, sizeof(p->decoded.payload.bytes), ++txSeq, cmd);
    if (!p->decoded.payload.size) {
        packetPool.release(p);
        return;
    }
    txPacket(p);
    LOG_INFO("Irrigation GW: CMD_MAINT enviado para 0x%08x (%u min)", node, minutes);
}

// Fonte única de hora local do gateway (mesma que o scheduler consome no gwTick).
bool IrrigationModule::computeLocalSecs(uint32_t &out) const
{
    uint32_t epochLocal = getValidTime(RTCQualityDevice, true);
    out = epochLocal;
    return epochLocal != 0;
}

// --- Fase 8b: cola da página Horário (fonte de hora / manual / fuso / sync NTP) ---
size_t IrrigationModule::gwBuildTimeStatus(char *buf, size_t cap)
{
    IrrigationWeb::TimeStatusCtx c = {};
    // Epoch UTC real (local=false): o navegador aplica o fuso ao formatar. Passar local=true
    // embutiria o offset do fuso e o cliente o somaria de novo (hora dobrada).
    c.nowEpoch = getValidTime(RTCQualityDevice, false);
    c.quality = (int)getRTCQuality();
#if defined(ARCH_ESP32)
    c.staUp = WiFi.isConnected();
    unsigned long last = ntpLastRunMs();
    c.lastSyncS = (last != 0) ? (int32_t)((millis() - last) / 1000UL) : -1;
#else
    c.staUp = false;
    c.lastSyncS = -1;
#endif
    c.ntpServer = config.network.ntp_server[0] ? config.network.ntp_server : "pool.ntp.org";
    c.tz = config.device.tzdef; // "" se não definido
    return IrrigationWeb::buildTimeStatus(c, buf, cap);
}

bool IrrigationModule::gwSetManualTime(uint32_t epoch)
{
    if (epoch < 1600000000u)
        return false;
    struct timeval tv;
    tv.tv_sec = (time_t)epoch;
    tv.tv_usec = 0;
    perhapsSetRTC(RTCQualityDevice, &tv, /*forceUpdate=*/true);
    LOG_INFO("Irrigation GW: hora definida manualmente (epoch=%u)", epoch);
    return true;
}

bool IrrigationModule::gwSetTimezone(const char *posix)
{
    if (!posix || !IrrigationWeb::tzIsValidPreset(posix))
        return false;
    strncpy(config.device.tzdef, posix, sizeof(config.device.tzdef) - 1);
    config.device.tzdef[sizeof(config.device.tzdef) - 1] = '\0';
    setenv("TZ", config.device.tzdef, 1);
    tzset(); // aplica o fuso já neste boot (localtime passa a usar o novo TZ)
    // Persiste só o segmento de config (main.cpp relê tzdef no próximo boot). Evita o
    // reloadConfig(), que dispara reconfig de rádio/observers — desnecessário p/ um fuso.
    nodeDB->saveToDisk(SEGMENT_CONFIG);
    LOG_INFO("Irrigation GW: fuso ajustado (%s)", config.device.tzdef);
    return true;
}

bool IrrigationModule::gwSyncNtpNow()
{
#if defined(ARCH_ESP32)
    if (!WiFi.isConnected())
        return false;
    triggerNtpUpdate();
    return true;
#else
    return false;
#endif
}

// --- Supressão meteorológica (Task 10) ---
bool IrrigationModule::gwWeatherSetConfig(uint8_t enabled, int32_t latE7, int32_t lonE7)
{
    gateway.weatherConfig.enabled = enabled ? 1 : 0;
    gateway.weatherConfig.latE7 = latE7;
    gateway.weatherConfig.lonE7 = lonE7;
    return saveWeatherConfig();
}

uint8_t IrrigationModule::gwWeatherUpsertRule(const WeatherRule &rIn)
{
    WeatherRule r = rIn;
    if (!r.id) {
        r.id = gateway.weatherRules.nextFreeId();
        if (!r.id)
            return 0; // tabela cheia
    }
    if (!gateway.weatherRules.upsert(r))
        return 0;
    if (!saveWeatherRules())
        return 0;
    return r.id;
}

bool IrrigationModule::gwWeatherDeleteRule(uint8_t id)
{
    if (!gateway.weatherRules.removeById(id))
        return false;
    return saveWeatherRules();
}

bool IrrigationModule::gwWeatherRefresh()
{
#if defined(ARCH_ESP32)
    if (!WiFi.isConnected())
        return false;
    uint32_t nowLocal = 0;
    computeLocalSecs(nowLocal);
    return weatherClient.pollNow(gateway.weatherConfig, nowLocal, gateway.weatherCache);
#else
    return false;
#endif
}

// --- Serviço do painel web (gateway). Ponte entre a cola HTTP (Task 10) e o estado do gateway. ---
bool IrrigationModule::gwIsGateway() const
{
    return settings.role == (uint8_t)IrrigationRole::GATEWAY;
}

// --- Fase 6b Task 18: gwApply* para intertravamentos/sensores (remove const_cast dos endpoints) ---
bool IrrigationModule::gwApplyInterlockUpsert(const InterlockRule &r)
{
    if (!gateway.interlocks.upsert(r))
        return false;
    saveInterlocks();
    gwRebuildLocalInterlocks();
    return true;
}
bool IrrigationModule::gwApplyInterlockDelete(uint8_t id)
{
    if (!gateway.interlocks.removeById(id))
        return false;
    saveInterlocks();
    gwRebuildLocalInterlocks();
    return true;
}
bool IrrigationModule::gwApplyGroupUpsert(HydraulicGroup &g, char *err, size_t errCap)
{
    if (!IrrigationWeb::validateGroupZones(g, gateway.zones, err, errCap))
        return false; // err preenchido
    if (g.id == 0) {
        // Aloca 1º id livre 1..MAX.
        uint8_t freeId = 0;
        for (uint8_t cand = 1; cand <= HydraulicGroupTable::MAX; cand++) {
            if (!gateway.groups.byId(cand)) { freeId = cand; break; }
        }
        if (freeId == 0) {
            snprintf(err, errCap, "tabela de grupos cheia");
            return false;
        }
        g.id = freeId;
    }
    if (!gateway.groups.upsert(g)) {
        snprintf(err, errCap, "grupo invalido (zona em outro grupo?)");
        return false;
    }
    saveGroups();
    return true;
}

bool IrrigationModule::gwApplyGroupDelete(uint8_t id)
{
    if (!gateway.groups.removeById(id))
        return false;
    saveGroups();
    return true;
}

bool IrrigationModule::gwRunGroupCommand(uint8_t id, bool open, uint16_t durationS)
{
    const HydraulicGroup *g = gateway.groups.byId(id);
    if (!g)
        return false;
    uint16_t dur = durationS;
    if (open && dur == 0) {
        // Default: maior maxMin (s) entre os membros; fallback 600 s.
        uint16_t best = 0;
        for (uint8_t i = 0; i < g->zoneCount && i < 8; i++) {
            const Zone *z = gateway.zones.byId(g->zoneIds[i]);
            if (z && z->maxMin > 0) {
                uint16_t candSecs = (uint16_t)(z->maxMin * 60);
                if (candSecs > best) best = candSecs;
            }
        }
        dur = best ? best : 600;
    }
    if (open && dur > HydraulicGroupEngine::PUMP_CEILING_S)
        dur = HydraulicGroupEngine::PUMP_CEILING_S;
    bool anyOpened = false;
    for (uint8_t i = 0; i < g->zoneCount && i < 8; i++) {
        uint8_t zid = g->zoneIds[i];
        if (open) {
            if (gateway.interlockEngine.zoneVerdict(zid).bloqueada)
                continue; // pula zona bloqueada
            gateway.groupEngine.setDesired(id, zid, true, dur);
            anyOpened = true;
        } else {
            gateway.groupEngine.setDesired(id, zid, false, 0);
        }
    }
    if (open && !anyOpened)
        auditEvent(AuditOrigin::PAINEL, AuditAction::CMD_REJEITADO, id, AuditResult::NACK);
    else
        auditEvent(AuditOrigin::PAINEL, open ? AuditAction::ABRIR : AuditAction::FECHAR, id, AuditResult::OK);
    return true;
}

bool IrrigationModule::gwApplySensorName(uint32_t node, uint8_t sensorIdx, const char *name)
{
    if (!gateway.sensorNames.set(node, sensorIdx, name))
        return false;
    saveSensorNames();
    return true;
}
void IrrigationModule::gwOpenMaintWindow(uint32_t node, uint16_t minutes)
{
    gwSendMaintWindow(node, minutes);
}

bool IrrigationModule::gwHasRtc() const
{
    uint32_t s = 0;
    return computeLocalSecs(s);
}
bool IrrigationModule::gwPairingPending() const
{
    return gatewayPairing.hasPending(millis());
}
uint32_t IrrigationModule::gwPairingNode() const
{
    return gatewayPairing.pendingNode();
}
uint16_t IrrigationModule::gwPairingSecondsLeft() const
{
    return gatewayPairing.pendingSecondsLeft(millis());
}
uint32_t IrrigationModule::gwLocalSecs() const
{
    uint32_t s = 0;
    computeLocalSecs(s);
    return s;
}

bool IrrigationModule::gwStaConnected() const
{
#if defined(ARCH_ESP32)
    return WiFi.isConnected();
#else
    return false;
#endif
}

const char *IrrigationModule::gwNodeLabel() const
{
    if (owner.long_name[0])
        return owner.long_name;
    return "Gateway";
}

uint32_t IrrigationModule::gwSelfNode() const
{
    return nodeDB->getNodeNum();
}

bool IrrigationModule::gwApplyZoneUpsert(const Zone &z)
{
    if (!gateway.zones.upsert(z))
        return false;
    saveGatewayState();
    return true;
}
bool IrrigationModule::gwApplyZoneDelete(uint8_t id)
{
    bool ok = gateway.zones.removeById(id);
    if (ok)
        saveGatewayState();
    return ok;
}
bool IrrigationModule::gwApplyProgramUpsert(const Program &p)
{
    if (!gateway.scheduler.upsert(p))
        return false;
    saveGatewayState();
    return true;
}
bool IrrigationModule::gwApplyProgramToggle(uint8_t id, bool enabled)
{
    // Localiza o programa atual e re-upsert com enabled ajustado.
    for (size_t i = 0; i < gateway.scheduler.count(); i++) {
        const Program *cur = gateway.scheduler.programAt(i);
        if (cur && cur->id == id) {
            Program np = *cur;
            np.enabled = enabled;
            gateway.scheduler.upsert(np);
            saveGatewayState();
            return true;
        }
    }
    return false;
}
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
