jeffersonpimenta/firmware/src/modules/irrigation/IrrigationModule.h

#pragma once
#include "SinglePortModule.h"
#include "concurrency/OSThread.h"
#include "modules/irrigation/Allowlist.h"
#include "modules/irrigation/AuditLog.h"
#include "modules/irrigation/ButtonGesture.h"
#include "modules/irrigation/FlashAuditRing.h"
#include "modules/irrigation/FragmentReassembler.h"
#include "modules/irrigation/IrrigationGateway.h"
#include "modules/irrigation/IrrigationProtocol.h"
#include "modules/irrigation/IrrigationSettings.h"
#include "modules/irrigation/LedPattern.h"
#include "modules/irrigation/Pairing.h"
#include "modules/irrigation/RateLimiter.h"
#include "modules/irrigation/SeqTable.h"
#include "modules/irrigation/PortalSession.h"
#include "modules/irrigation/GpoController.h"
#include "modules/irrigation/ValveController.h"
#include "modules/irrigation/SensorSampler.h"
#include "modules/irrigation/SurveyBeacon.h"
#include "modules/irrigation/SurveyLog.h"
#include "modules/irrigation/LittleFsByteStore.h"
#include "modules/irrigation/ServiceController.h"
#include "modules/irrigation/ServicePortalApi.h" // Fase 8c: tipos/builders do portal SERVICO
#include "modules/irrigation/LittleFsProfileStore.h"
#include "modules/irrigation/WeatherClient.h"
#include "modules/irrigation/RemoteButtonEdge.h"
#include "modules/irrigation/RemoteLedFsm.h"
#include "modules/irrigation/RemoteFallbackTracker.h"

// Forward-decl da cola web (definida em IrrigationWebApi.h, incluída só no .cpp).
namespace IrrigationWeb
{
struct WebCommand;
struct NodeStateCtx;
struct PortalPulseReq;
struct NetCommand;
struct PortalSensorsCtx;
struct PortalGpoReq;
struct PortalCoords;
struct SurveyStartReq;
struct ProvisionReq;
struct LinkCtx;
// Fase 8a — provisionamento WiFi STA
struct WifiStatusCtx;
struct WifiScanCtx;
struct WifiConnectReq;
struct WifiConnectCtx;
struct WifiToggleReq;
// Modo Remoto
struct RemoteUpsertReq;
// OTA local por contato (BLE) — §3.3/§9. ESP32/webserver-only.
struct OtaArmReq;
struct OtaStatusCtx;
}

// Saída de nível (relé/MOSFET) dos GPOs.
class GpioGpoDriver : public IGpoDriver
{
  public:
    void configure(const IrrigationSettings &s);
    void set(uint8_t index, bool on) override;

  private:
    int8_t pins[IrrigationSettings::MAX_GPO] = {-1, -1};
};

// Ponte H latching: pulso em A abre, pulso em B fecha.
class GpioValveDriver : public IValveDriver
{
  public:
    void configure(const IrrigationSettings &s);
    void pulse(uint8_t index, bool open) override;

  private:
    int8_t pinsA[IrrigationSettings::MAX_VALVES];
    int8_t pinsB[IrrigationSettings::MAX_VALVES];
    uint16_t pulseMs = 60;
};

class IrrigationModule : public SinglePortModule, private concurrency::OSThread
{
  public:
    IrrigationModule();

    // Called by IrrigationUiThread (25 ms poll) to dispatch button gestures.
    void onButtonEvent(ButtonGestureDetector::Event ev);
    // Janela de acesso (spec 2026-08-11): aplica a ação de SHORT press (reabre a
    // janela ou agenda reboot conforme o BLE já ter sido liberado neste boot).
    void applyAccessWindowShort();
    // Called by IrrigationUiThread to read current LED state (pure function of time).
    bool ledOnNow() { return led.ledOn(millis()); }

    // --- Serviço do painel web (gateway). Chamados pela cola HTTP (IrrigationWebEndpoints). ---
    bool gwIsGateway() const;
    const IrrigationGateway &gwState() const { return gateway; }
    // Badge "Alertas" do overview: conta pendentes (aplica a mesma régua de reconhecimento de gwBuildAlerts).
    uint16_t gwUnackedAlertCount() const { return (uint16_t)gateway.alerts.unackedCount(lastAckAllMs); }
    bool gwHasRtc() const;
    uint32_t gwLocalSecs() const;
    // Supressão meteorológica — wrappers finos para os endpoints /weather.
    bool gwStaConnected() const; // true se WiFi STA conectado (ARCH_ESP32); false caso contrário
    const char *gwNodeLabel() const; // owner.long_name ou "Gateway"
    uint32_t gwSelfNode() const;     // nodeDB->getNodeNum() — painel oferece "Gateway (local)" no form de zona
    // Fase 9: estado de pareamento pendente (§6) para o overview/painel.
    bool gwPairingPending() const;
    uint32_t gwPairingNode() const;
    uint16_t gwPairingSecondsLeft() const;
    bool gwApplyZoneUpsert(const Zone &z);
    bool gwApplyZoneDelete(uint8_t id);
    bool gwApplyProgramUpsert(const Program &p);
    bool gwApplyProgramToggle(uint8_t id, bool enabled);
    bool gwApplyProgramDelete(uint8_t id);
    bool gwRunCommand(const IrrigationWeb::WebCommand &c);
    // Fase 9: painel de estação. config = muta blob desejado + bump epoch + re-push §5.4.
    bool gwApplyStationConfig(const IrrigationWeb::StationConfigReq &r); // false se estação sem blob adotado
    int gwCountZonesForNode(uint32_t node) const;                       // zonas vinculadas ao nó
    bool gwRemoveStation(uint32_t node);                                // false se há zonas vinculadas
    bool gwStationPulse(const IrrigationWeb::StationPulseReq &r);       // false se estação/saída ausente
    // Fase 6b, Task 14b: remonta e empurra regras locais de intertravamento para cada estação.
    // Deve ser chamado após loadInterlocks()+loadGatewayState() (init) e após CRUD de interlocks (Task 18).
    void gwRebuildLocalInterlocks(); // GATEWAY-only
    // Fase 6b Task 18: métodos de alto nível para os endpoints de intertravamentos/sensores/manutenção.
    // Espelham o padrão gwApplyZone*/gwApplyProgram*: mutam, persistem e retornam false se falhar.
    bool gwApplyInterlockUpsert(const InterlockRule &r); // upsert + saveInterlocks() + gwRebuildLocalInterlocks()
    bool gwApplyInterlockDelete(uint8_t id);             // removeById + saveInterlocks() + gwRebuildLocalInterlocks()
    // Fase 7b: grupos hidráulicos (painel). Espelham gwApplyInterlock*.
    bool gwApplyGroupUpsert(HydraulicGroup &g, char *err, size_t errCap); // valida + aloca id se 0 + saveGroups()
    bool gwApplyGroupDelete(uint8_t id);                                  // removeById + saveGroups()
    bool gwRunGroupCommand(uint8_t id, bool open, uint16_t durationS);    // controle manual do grupo
    // Controle de nível por boia (Task 5): avaliação, executor e CRUD.
    void gwLevelTick(uint32_t nowMs);
    void gwDriveZone(uint8_t zoneId, bool open, uint16_t durS);
    bool gwApplyLevelUpsert(LevelRule &r, char *err, size_t errCap); // aloca id se 0; salva
    bool gwApplyLevelDelete(uint8_t id);
    bool gwApplySensorName(uint32_t node, uint8_t sensorIdx, const char *name); // set + saveSensorNames()
    void gwOpenMaintWindow(uint32_t node, uint16_t minutes); // chama gwSendMaintWindow() privado
    // Acesso de leitura ao log de auditoria flash do gateway (Task 16). GATEWAY-only.
    const FlashAuditRing &auditFlashRef() const { return auditFlash; }
    // Fase 8b: backup §5.5 completo (PSK + tabelas) num envelope de 1 cliente, p/ o cofre
    // do device SERVICO / botão de export do painel. GATEWAY-only. → bytes escritos (0 se falhou).
    size_t gwBuildBackup(char *buf, size_t cap);
    // Sistema restore: importa as 4 tabelas de config de um envelope de backup (NÃO toca PSK/estações/epoch).
    // Sucesso: persiste, audita, escreve JSON {ok,zonas,programas,intertravamentos,grupos} em resp, retorna true.
    // Falha: escreve {ok:false,err:"..."} em resp, retorna false. CI-only (gateado pelo endpoint).
    bool gwImportTables(const char *json, size_t len, char *resp, size_t respCap);
    // Alertas não reconhecidos (§8.1–§8.3) p/ a Visão Geral do painel. Vazio ("[]") fora do gateway.
    size_t gwBuildAlerts(char *buf, size_t cap);
    // Modo Espelhamento UI (Fase X): habilita/desabilita o espelho; edita/remove mapeamento porta→zona;
    // serializa o estado ao vivo. Chamados pelos endpoints CI-only /api/irrigation/mirror/*.
    void gwSetMirrorEnabled(bool enabled);
    bool gwApplyMirrorMapping(int8_t input, uint8_t zoneId, bool invertido, bool habilitado,
                              char *err, size_t errCap);
    bool gwDeleteMirrorMapping(int8_t input);
    size_t gwBuildMirror(char *buf, size_t cap);

    // Fase 8b: página Horário. gwBuildTimeStatus monta o TimeStatusCtx + serializa.
    size_t gwBuildTimeStatus(char *buf, size_t cap);
    bool gwSetManualTime(uint32_t epoch);  // perhapsSetRTC(Device, force) — true se aplicou
    bool gwSetTimezone(const char *posix); // grava config.device.tzdef + setenv + persiste
    bool gwSyncNtpNow();                   // dispara NTP; false se WiFi STA down

    // Supressão meteorológica (Open-Meteo) — Task 10.
    // Modo Remoto (Task 6): CRUD de associações botoeira→saída.
    bool gwApplyRemoteUpsert(const IrrigationWeb::RemoteUpsertReq &u); // upsert + save + push LED
    bool gwApplyRemoteDelete(uint8_t id);                              // removeById + save + recompute cfg
    bool gwRunRemoteCommand(uint8_t targetZoneId);                     // toggle manual (botão "Acionar" da UI)
    // Modo Remoto (Task 8): acessores públicos chamados pelos endpoints CI-only /api/irrigation/remote/*.
    // Espelham os mirror* (gwBuildMirror/gwApplyMirrorMapping/gwDeleteMirrorMapping).
    size_t remoteBuildStatus(char *buf, size_t cap);           // estado ao vivo (dedup por targetZoneId)
    bool   remoteApplyUpsert(const char *json, size_t n);     // parse → gwApplyRemoteUpsert
    bool   remoteApplyDelete(const char *json, size_t n);     // parse → gwApplyRemoteDelete
    bool   remoteRunCommand(const char *json, size_t n);      // parse → gwRunRemoteCommand

    bool gwWeatherSetConfig(uint8_t enabled, int32_t latE7, int32_t lonE7);
    uint8_t gwWeatherUpsertRule(const WeatherRule &r); // retorna id atribuído (0=falha/sem espaço)
    bool gwWeatherDeleteRule(uint8_t id);
    bool gwWeatherRefresh(); // poll imediato; false se sem WiFi ou config desabilitada
    const WeatherConfig    &gwWeatherConfig() const { return gateway.weatherConfig; }
    const WeatherRuleTable &gwWeatherRules()  const { return gateway.weatherRules;  }
    const WeatherCache     &gwWeatherCache()  const { return gateway.weatherCache;  }

    // --- Serviço do portal de campo (todos os papéis). Chamados pela cola HTTP (IrrigationPortalEndpoints). ---
    void portalFillNodeState(IrrigationWeb::NodeStateCtx &out) const;
    void portalFillLink(IrrigationWeb::LinkCtx &out) const;
    bool portalPulse(const IrrigationWeb::PortalPulseReq &p);
    bool portalRunNetCommand(const IrrigationWeb::NetCommand &c);
    void portalFillSensors(IrrigationWeb::PortalSensorsCtx &out) const;
    bool portalGpo(const IrrigationWeb::PortalGpoReq &r); // biestável (durationS==0 ao ligar) exige confirm
    void portalGetCoords(IrrigationWeb::PortalCoords &out) const;
    bool portalSetCoords(const IrrigationWeb::PortalCoords &c); // persiste settings (coordenada é local, não mexe em epoch)
    // Wizard de 1º boot (§6): grava o papel escolhido (+ PSK da fazenda se GATEWAY) e reinicia.
    bool portalProvision(const IrrigationWeb::ProvisionReq &r);
    void startBleWindow(uint8_t minutes); // janela BLE sob demanda: grava flag RTC + reboot
    // OTA local por contato (BLE) — §3.3/§9. ESP32/webserver-only.
    bool portalOtaArm(const IrrigationWeb::OtaArmReq &r);
    void portalFillOtaStatus(IrrigationWeb::OtaStatusCtx &c);
    PortalSession &portalSession() { return portal; }
    // Acesso de leitura ao mini-log de auditoria (Task 10: portal de campo). §8.9
    const AuditLog &auditLogRef() const { return audit; }

    // Fase 8c — portal do device SERVICO (§11.8). Chamados pelos endpoints /api/portal/service/*.
    bool svcIsService() const;
    size_t svcPortalListClients(char *buf, size_t cap);
    bool svcPortalSelect(const char *id); // planRetune + applyRetune (re-tune + reboot)
    void svcPortalStartScan();
    size_t svcPortalScanResults(char *buf, size_t cap);
    bool svcPortalReadConfig(uint32_t node);  // envia GET_CONFIG direto
    bool svcPortalConfigReady(uint32_t node); // reply remontado pronto?
    size_t svcPortalGetReadConfig(char *buf, size_t cap);
    bool svcPortalWriteConfig(const IrrigationWeb::NodeConfigReq &req); // rota DIRECT (§11.6); VIA_GATEWAY=follow-on
    bool svcPortalNodeAction(const IrrigationWeb::NodeAction &a);       // pulso/zona/resync; approve_pair=follow-on
    size_t svcPortalBuildLog(char *buf, size_t cap);
    size_t svcPortalExport(char *buf, size_t cap); // §11.7 despeja o envelope multi-cliente do cofre
    bool svcPortalImport(const char *json, size_t n, bool replace, char *err, size_t errCap); // §11.7 valida+merge
    bool svcPortalSeedConfig(uint32_t node, IrrigationSettings &out); // out = último blob lido do nó (campos geridos)
    uint32_t gwTimeAdopted() const { return 0; } // TODO banca: ts adotado do gateway (HB/ACK); 0=sem RTC

    // Fase 8a — provisionamento WiFi STA (glue ESP32; stub no native)
    void portalWifiStatus(IrrigationWeb::WifiStatusCtx &out);
    void portalWifiStartScan();
    void portalWifiScanResult(IrrigationWeb::WifiScanCtx &out);
    bool portalWifiConnect(const IrrigationWeb::WifiConnectReq &req);
    void portalWifiConnectProgress(IrrigationWeb::WifiConnectCtx &out);
    void portalWifiForget();
    void portalWifiToggle(bool enabled);

    // Fase 8d — site survey (§8.5). Portais (nó §7.2 / SERVICO §11.8) iniciam o beacon;
    // o painel do gateway lê o log. portalStart/Stop valem p/ qualquer papel que beacona.
    bool portalStartSurvey(const IrrigationWeb::SurveyStartReq &r);
    void portalStopSurvey();
    size_t buildSurveyLog(char *buf, size_t cap); // GATEWAY: tabela Cobertura do painel
    void clearSurveyLog();

  protected:
    bool wantPacket(const meshtastic_MeshPacket *p) override;
    ProcessMessage handleReceived(const meshtastic_MeshPacket &mp) override;
    int32_t runOnce() override;

  private:
    // §8.9: mini-log de auditoria da estação (100 registros em ring).
    static constexpr size_t AUDIT_CAP = 100;
    AuditRecord auditStore[AUDIT_CAP];
    AuditLog audit{auditStore, AUDIT_CAP};
    bool auditDirty = false;
    uint32_t lastAuditSaveMs = 0;
    void auditEvent(AuditOrigin o, AuditAction a, uint8_t target, AuditResult res, uint32_t node = 0, uint32_t seq = 0);
    bool loadAuditLog();
    bool saveAuditLog();

    // Fase 6b Task 16: log de auditoria persistente em flash no gateway (~5 meses, 256 KB).
    // Somente usado quando role == GATEWAY; inicializado em loadGatewayState().
    static constexpr size_t AUDIT_FLASH_CAP = 16384; // slots
    static constexpr size_t AUDIT_FLASH_SIZE = FlashAuditRing::HEADER + AUDIT_FLASH_CAP * FlashAuditRing::REC;
    LittleFsByteStore auditFlashStore{"/prefs/irrigation_audit.dat", AUDIT_FLASH_SIZE};
    FlashAuditRing auditFlash{auditFlashStore};

    void handleCmdValvula(const meshtastic_MeshPacket &mp, const IrrigationProto::Header &h);
    void handleCmdGpo(const meshtastic_MeshPacket &mp, const IrrigationProto::Header &h);
    void handleCmdMaint(const meshtastic_MeshPacket &mp, const IrrigationProto::Header &h);
    void handleSetConfig(const meshtastic_MeshPacket &mp, const IrrigationProto::Header &h);
    void handleGetConfig(const meshtastic_MeshPacket &mp, const IrrigationProto::Header &h);
    // Pairing handlers — no senderAuthorized check; physical window + button is the authorization (spec §6).
    void handlePairAnnounce(const meshtastic_MeshPacket &mp, const IrrigationProto::Header &h);
    void handlePairGrant(const meshtastic_MeshPacket &mp, const IrrigationProto::Header &h);
    // Gateway handlers (Fase 4, Task 6: decisões 1-6)
    void handleRemoteCmd(const meshtastic_MeshPacket &mp, const IrrigationProto::Header &h);
    void handleResyncSeq(const meshtastic_MeshPacket &mp, const IrrigationProto::Header &h);   // §11.5 responder
    void handlePingSurvey(const meshtastic_MeshPacket &mp, const IrrigationProto::Header &h);  // §11.4 responder (todos papéis)
    // Fase 8b — device SERVICO (role == SERVICO). Executores das intents do ServiceController.
    void applyRetune(const char *clientId);   // §11.3 re-tune do canal + reboot
    void svcEmitProbe();                       // §11.4 emissor da sonda PING_SURVEY (broadcast, FROM_SERVICE)
    void emitSurveyBeacon();                   // §8.5 beacon de cobertura PING_SURVEY kind=2 (broadcast)
    void svcSendResyncRequest(uint32_t node);  // §11.5 RESYNC_SEQ REQUEST (FROM_SERVICE)
    void svcExportToConsole();                 // §11.7 despeja o envelope do cofre no serial (bancada)
    void handleGwAck(const meshtastic_MeshPacket &mp, const IrrigationProto::Header &h);
    // OTA local por contato (BLE) — §3.3/§9. ESP32/webserver-only. Helper privado: decompõe o estado de ciclo.
#if defined(ARCH_ESP32) && !MESHTASTIC_EXCLUDE_WEBSERVER
    void otaCycleDecompose(bool &anyValve, bool &anyGpo, bool &groupActive);
    bool otaCycleActive();
#endif
    // Núcleo de confirmação de comando: tracker + motor de grupos + alerta no NACK.
    // Chamado pelo ACK de rádio (handleGwAck) e pelo drive local (ACK sintético no gwTick).
    void confirmCommand(uint32_t node, uint32_t seq, uint8_t reason, bool ok);
    void handleGwHeartbeat(const meshtastic_MeshPacket &mp, const IrrigationProto::Header &h);
    void handleGwEvento(const meshtastic_MeshPacket &mp, const IrrigationProto::Header &h);
    void handleGwSetConfig(const meshtastic_MeshPacket &mp, const IrrigationProto::Header &h);
    void gwTick(); // chamado no runOnce do GATEWAY 1×/s
    // Fonte única de hora local do gateway: true + segundos-de-epoch local se há RTC válido; false caso contrário.
    bool computeLocalSecs(uint32_t &out) const;
    uint32_t gwSendValveCmd(uint32_t node, uint8_t index, uint8_t tipo, uint8_t action, uint16_t durationS,
                            uint8_t zoneId, uint8_t attempts,
                            AuditOrigin origin = AuditOrigin::PAINEL); // decisão §1 — retorna o txSeq usado (0 se falhou)
                            // node==self ⇒ aciona saída LOCAL (origin usado só nesse caminho de auditoria)
    // Fase 7b: ponto único de decisão de roteamento de open/close de UMA zona.
    // Zona de grupo hidráulico => motor (setDesired); zona livre => false (caminho atual).
    bool routeZoneToGroup(uint8_t zoneId, bool open, uint16_t durationS);
    void gwSendMaintWindow(uint32_t node, uint16_t minutes); // Fase 6b Task 15: janela de manutenção do tamper
    void gwReconcileEpoch(uint32_t node, uint32_t remoteEpoch);
    // P2P-fallback: preenche os campos de rota de fallback de `cfg` (config de UMA estação
    // `stationNode`) a partir das botoeiras/zonas/grupos do gateway, no push de SET_CONFIG.
    void gwOverlayFallbackRoute(uint32_t stationNode, IrrigationSettings &cfg);
    void commitPairing();
    void factoryReset();
    void logFarmKey(); // dumps primary PSK as base64 to serial (spec §11.2)
    void sendEvento(uint8_t code, uint32_t arg = 0);
    void refreshLedMode(); // call at end of runOnce
    void tickTamper(uint32_t nowMs);
    void resetTamperState();
    void configureSensorPins();
    bool loadAllowlist();
    bool saveAllowlist();
    bool loadGatewayState();
    bool saveGatewayState(); // persiste stations, zones, programs, mirror
    bool loadInterlocks();      // Fase 6b: carrega tabela de intertravamentos do flash
    bool saveInterlocks();      // Fase 6b: persiste tabela de intertravamentos (staged-write)
    bool loadSensorNames();     // Fase 6b Task 18: carrega nomes de sensores do flash
    bool saveSensorNames();     // Fase 6b Task 18: persiste nomes de sensores (staged-write)
    bool loadGroups();          // Fase 7a: carrega tabela de grupos hidráulicos do flash
    bool saveGroups();          // Fase 7a: persiste tabela de grupos hidráulicos (staged-write)
    bool loadLevels();          // controle de nível: carrega tabela do flash
    bool saveLevels();          // controle de nível: persiste tabela (staged-write)
    bool loadWeather();         // carrega config + regras de supressão climática
    bool saveWeatherConfig();   // persiste WeatherConfig (staged-write)
    bool saveWeatherRules();    // persiste WeatherRuleTable (staged-write)
    // Veredito de supressão climática para a zona (resolve grupo-dono via OR).
    WeatherVerdict weatherVerdictForZone(uint8_t zoneId);
    IrrigationSettings mergeRemoteConfig(const IrrigationSettings &fresh, uint32_t newEpoch) const;
    void activateSettings(const IrrigationSettings &merged);
    void sendAck(uint32_t to, uint32_t ackedSeq, uint8_t status, uint8_t reason);
    void sendHeartbeat();
    // Choke point de envio: aplica prioridade por tipo e o gate de airtime
    // (HB/survey cedem sob congestionamento; comando/ACK/alarme sempre passam).
    // Devolve true se enviado, false se barrado (pacote é liberado).
    bool txPacket(meshtastic_MeshPacket *p);
    bool senderAuthorized(uint32_t from, uint16_t flags) const;
    uint16_t batteryCentiV() const;

    // settings must be declared before driver and valves so it is constructed
    // first and can feed the ValveController initializer (reference member).
    IrrigationSettings settings;
    GpioValveDriver driver;
    ValveController valves;
    GpioGpoDriver gpoDriver;
    GpoController gpos;
    SeqTable seqTable;
    RateLimiter rateLimiter;
    FragmentReassembler reasm;
    StationPairing stationPairing;
    GatewayPairing gatewayPairing;
    Allowlist allowlist;
    LedPatternController led;
    PortalSession portal; // ciclo de vida do AP do captive portal (Fase 5b)
    // Gateway aggregate — only meaningful when role == GATEWAY (Task 6, decisão §1).
    IrrigationGateway gateway;
    // Fase supressão meteorológica: cliente de rede (ARCH_ESP32 only; no-op no nativo).
    WeatherClient weatherClient;
    // Fase 6b: bitmask de zonas já fechadas por intertravamento (borda de subida).
    // Indexado por zoneId (0..255); usa array compacto de 32 bytes (256 bits).
    uint8_t interlockClosedMask[32] = {0};
    // Cooldowns de reconciliação de epoch indexados por nó (Fix 3: node-keyed, não por posição na allowlist).
    struct EpochCooldown {
        uint32_t node = 0;
        uint32_t lastMs = 0;
    };
    EpochCooldown epochCooldowns[StationRegistry::MAX];
    uint32_t txSeq = 0;
    // ACK sintético do drive local: confirmado no próximo gwTick para não reentrar no
    // loop de emissão do motor de grupos (noteSent roda depois de gwSendValveCmd).
    struct LocalAck {
        uint32_t node = 0;
        uint32_t seq = 0;
    };
    LocalAck pendingLocalAck[8];
    uint8_t pendingLocalAckCount = 0;
    uint32_t lastHeartbeatMs = 0;
    uint32_t hbJitterMs = 0;           // offset de jitter atual (reavaliado no epoch)
    uint32_t hbSeedEpoch = 0xFFFFFFFF; // epoch com que hbJitterMs foi semeado
    uint32_t lastGatewayRxMs = 0; // last millis() we received a packet from boundGateway
    // Enlace (repetidor): última métrica de rx do gateway + ring de histórico p/ o portal.
    int8_t linkSnrQ = 0;
    int16_t linkRssi = 0;
    uint8_t linkHist[12] = {0};
    uint8_t linkHistCount = 0;
    uint8_t linkHistHead = 0;
    void noteGatewayLink(int8_t snrQ, int16_t rssi);
    bool safeMode = false;
    bool provisioned = false; // false = nó de fábrica (sem config salva no boot) → wizard de 1º boot (§6)
    // Janela de acesso (Portal AP + BLE) nos nós de campo — spec 2026-08-11.
    bool bleReleasedThisBoot = false; // BLE já foi liberado (RAM) nesta sessão; release é sticky até reboot.
    bool apWasUp = false;             // nível anterior de portal.apShouldBeUp() p/ detectar a borda OPEN->CLOSED.
    bool bleWindowActive = false;     // janela BLE sob demanda ativa neste boot (WiFi off, BLE on)
    uint32_t bleWindowDeadlineMs = 0; // fim da janela BLE -> reboot de retorno
    bool bootHeartbeatPending = true;
    // Controle de LOG_WARN de RTC (1×/h para não spam)
    uint32_t lastRtcWarnMs = 0;
    // Marcador de "reconhecimento" de alertas (Fase 5a): alertas com atMs <= este valor são
    // considerados reconhecidos pelo overview. ACK_ALERT seta = millis().
    uint32_t lastAckAllMs = 0;
    SensorSampler sampler;
    // Fase 8d — site survey (§8.5): beacon (qualquer papel que beacona) + log (gateway).
    SurveyBeacon surveyBeacon;
    SurveyLog surveyLog;
    // Fase 8b — device SERVICO: cofre + controlador. Alocados só quando role == SERVICO.
    LittleFsProfileStore *svcStore = nullptr;
    ServiceController *svc = nullptr;
    // Fase 8c — leitura de config de um nó pelo device: GET_CONFIG → SET_CONFIG reply remontado
    // (cacheado, NÃO aplicado em si mesmo, ao contrário de handleSetConfig da estação).
    void handleSvcSetConfigReply(const meshtastic_MeshPacket &mp, const IrrigationProto::Header &h);
    uint32_t svcReadNode = 0;
    bool svcReadReady = false;
    IrrigationSettings svcReadBlob;
    // Fase 6b Task 14c: estado da réplica local de intertravamento (estação).
    // Latch por regra (>= MAX_LOCAL_INTERLOCKS entradas); prev-mask p/ borda de subida.
    bool localInterlockLatch[IrrigationSettings::MAX_LOCAL_INTERLOCKS] = {false};
    uint8_t localFecharValvPrev = 0;
    uint8_t localFecharGpoPrev = 0;
    // Tamper (§8.12): debounce próprio, fora dos 4 slots de sensor.
    bool tamperActive = false;
    bool tamperRawLast = false;
    uint32_t tamperRawSinceMs = 0;
    bool tamperInit = false;
    // Janela de manutenção do tamper (Fase 6b Task 15): suprime EV_TAMPER até este instante.
    // 0 = janela fechada. Combinado com portal.apShouldBeUp() por OR.
    uint32_t tamperMaintUntilMs = 0;

    // ── Modo Remoto (Task 6/7) ────────────────────────────────────────────────
    // Detector de borda de botão local (compartilhado gateway e estação).
    RemoteButtonEdge _btnEdge[IrrigationSettings::MAX_DIGITAL_IN];
    // FSM dos 2 LEDs de feedback local (gateway tem pinsRemoteLed[]; estação Task 7 reusa).
    RemoteLedFsm _remoteLed[2];
    RemoteFallbackTracker _fallback{REMOTE_FALLBACK_DEFAULT_MS};
    // casamento ACK direto → LED do fallback P2P: seq do comando direto emitido por slot de LED.
    struct PendingDirect { uint32_t seq = 0; uint8_t ledSlot = 3; bool armed = false; };
    PendingDirect _pendingDirect[IrrigationSettings::MAX_DIGITAL_IN];
    // Cache change-driven: último estado de LEDs por nó-gatilho (até 16 entradas).
    static constexpr size_t LED_CACHE_MAX = 16;
    struct LedCacheEntry { uint32_t node = 0; uint8_t states = 0; };
    LedCacheEntry _ledCache[LED_CACHE_MAX];
    uint8_t _ledCacheCount = 0;
    // Lê/atualiza o cache node→states; retorna 0xFF se node não está no cache.
    uint8_t _ledCacheLookup(uint32_t node) const;
    void _ledCacheSet(uint32_t node, uint8_t states);
    // Persistência da tabela de associações.
    bool loadRemoteButtons();
    bool saveRemoteButtons();
    // Estado de zona: authoritative open-state — driver local (válvula/GPO) para zona local do gateway;
    // StationTelemetry (valveStates/gpoStates do ACK ou HB) para zona remota; groupEngine para zonas de grupo.
    bool gwZoneIsOpen(uint8_t zoneId) const;
    // Handlers de botoeira remota.
    void handleRemoteLed(const meshtastic_MeshPacket &mp, const IrrigationProto::Header &h);
    void handleRemoteTrigger(const meshtastic_MeshPacket &mp, const IrrigationProto::Header &h);
    void gwFireRemote(uint32_t node, uint8_t inputIdx);
    void gwPushRemoteLed();
    void applyLocalRemoteLeds(uint8_t states);
    // Apply-helpers chamados pelo CRUD de associações (endpoints Task 8).
    uint8_t gwAllocRemoteId() const;
    void gwPushStationBtnConfig(const RemoteAssoc &a);
    // Recomputa e grava btnMask/ledIdx para um nó-gatilho a partir da tabela inteira.
    void gwRecomputeNodeBtnConfig(uint32_t node);
    // Abertura/fechamento pelo caminho manual (extrai helper para reuso sem duplicar coreografia).
    void gwRunCommandOpen(uint8_t zoneId);
    void gwRunCommandClose(uint8_t zoneId);
};

extern IrrigationModule *irrigationModule;
