jeffersonpimenta/firmware/src/mesh/http/ContentHandler.cpp

#if !MESHTASTIC_EXCLUDE_WEBSERVER
#include "NodeDB.h"
#include "PowerFSM.h"
#include "RadioLibInterface.h"
#include "airtime.h"
#include "main.h"
#include "mesh/http/ContentHelper.h"
#include "mesh/http/WebServer.h"
#if HAS_WIFI
#include "mesh/wifi/WiFiAPClient.h"
#include <WiFi.h> // WiFi.softAPIP() no redirect do portal cativo
#endif
#include "Power.h"
#include "SPILock.h"
#include <FSCommon.h>
#include <HTTPBodyParser.hpp>
#include <HTTPMultipartBodyParser.hpp>
#include <HTTPURLEncodedBodyParser.hpp>
#include <cmath>
#include <sstream>

#ifdef ARCH_ESP32
#include "esp_task_wdt.h"
#endif

/*
  Including the esp32_https_server library will trigger a compile time error. I've
  tracked it down to a reoccurrance of this bug:
    https://gcc.gnu.org/bugzilla/show_bug.cgi?id=57824
  The work around is described here:
    https://forums.xilinx.com/t5/Embedded-Development-Tools/Error-with-Standard-Libaries-in-Zynq/td-p/450032

  Long story short is we need "#undef str" before including the esp32_https_server.
    - Jm Casler (jm@casler.org) Oct 2020
*/
#undef str

// Includes for the https server
//   https://github.com/fhessel/esp32_https_server
#include <HTTPRequest.hpp>
#include <HTTPResponse.hpp>
#include <HTTPSServer.hpp>
#include <HTTPServer.hpp>
#include <SSLCert.hpp>

// The HTTPS Server comes in a separate namespace. For easier use, include it here.
using namespace httpsserver;

#include "mesh/http/ContentHandler.h"
#if !MESHTASTIC_EXCLUDE_IRRIGATION
#include "modules/irrigation/IrrigationPortalEndpoints.h"
#include "modules/irrigation/IrrigationWebEndpoints.h"
#include "modules/irrigation/ServicePortalEndpoints.h"
#endif

#define DEST_FS_USES_LITTLEFS

// We need to specify some content-type mapping, so the resources get delivered with the
// right content type and are displayed correctly in the browser
char const *contentTypes[][2] = {{".txt", "text/plain"},          {".html", "text/html"},
                                 {".json", "application/json"},    {".js", "text/javascript"},
                                 {".png", "image/png"},            {".jpg", "image/jpg"},
                                 {".gz", "application/gzip"},       {".gif", "image/gif"},
                                 {".css", "text/css"},             {".ico", "image/vnd.microsoft.icon"},
                                 {".svg", "image/svg+xml"},         {"", ""}};

// const char *certificate = NULL; // change this as needed, leave as is for no TLS check (yolo security)

// Our API to handle messages to and from the radio.
HttpAPI webAPI;

void registerHandlers(HTTPServer *insecureServer, HTTPSServer *secureServer)
{

    // For every resource available on the server, we need to create a ResourceNode
    // The ResourceNode links URL and HTTP method to a handler function

    ResourceNode *nodeAPIv1ToRadioOptions = new ResourceNode("/api/v1/toradio", "OPTIONS", &handleAPIv1ToRadio);
    ResourceNode *nodeAPIv1ToRadio = new ResourceNode("/api/v1/toradio", "PUT", &handleAPIv1ToRadio);
    ResourceNode *nodeAPIv1FromRadioOptions = new ResourceNode("/api/v1/fromradio", "OPTIONS", &handleAPIv1FromRadio);
    ResourceNode *nodeAPIv1FromRadio = new ResourceNode("/api/v1/fromradio", "GET", &handleAPIv1FromRadio);

    //    ResourceNode *nodeHotspotApple = new ResourceNode("/hotspot-detect.html", "GET", &handleHotspot);
    //    ResourceNode *nodeHotspotAndroid = new ResourceNode("/generate_204", "GET", &handleHotspot);

    ResourceNode *nodeAdmin = new ResourceNode("/admin", "GET", &handleAdmin);
    //    ResourceNode *nodeAdminSettings = new ResourceNode("/admin/settings", "GET", &handleAdminSettings);
    //    ResourceNode *nodeAdminSettingsApply = new ResourceNode("/admin/settings/apply", "POST", &handleAdminSettingsApply);
    //    ResourceNode *nodeAdminFs = new ResourceNode("/admin/fs", "GET", &handleFs);
    //    ResourceNode *nodeUpdateFs = new ResourceNode("/admin/fs/update", "POST", &handleUpdateFs);
    //    ResourceNode *nodeDeleteFs = new ResourceNode("/admin/fs/delete", "GET", &handleDeleteFsContent);

    ResourceNode *nodeRestart = new ResourceNode("/restart", "POST", &handleRestart);
    ResourceNode *nodeFormUpload = new ResourceNode("/upload", "POST", &handleFormUpload);

    ResourceNode *nodeJsonScanNetworks = new ResourceNode("/json/scanNetworks", "GET", &handleScanNetworks);
    ResourceNode *nodeJsonReport = new ResourceNode("/json/report", "GET", &handleReport);
    ResourceNode *nodeJsonNodes = new ResourceNode("/json/nodes", "GET", &handleNodes);
    ResourceNode *nodeJsonFsBrowseStatic = new ResourceNode("/json/fs/browse/static", "GET", &handleFsBrowseStatic);
    ResourceNode *nodeJsonDelete = new ResourceNode("/json/fs/delete/static", "DELETE", &handleFsDeleteStatic);

    ResourceNode *nodeRoot = new ResourceNode("/*", "GET", &handleStatic);

    // Secure nodes — pulados quando secureServer == nullptr (portal AP serve só HTTP:80, sem cert SSL).
    if (secureServer) {
    secureServer->registerNode(nodeAPIv1ToRadioOptions);
    secureServer->registerNode(nodeAPIv1ToRadio);
    secureServer->registerNode(nodeAPIv1FromRadioOptions);
    secureServer->registerNode(nodeAPIv1FromRadio);
    //    secureServer->registerNode(nodeHotspotApple);
    //    secureServer->registerNode(nodeHotspotAndroid);
    secureServer->registerNode(nodeRestart);
    secureServer->registerNode(nodeFormUpload);
    secureServer->registerNode(nodeJsonScanNetworks);
    secureServer->registerNode(nodeJsonFsBrowseStatic);
    secureServer->registerNode(nodeJsonDelete);
    secureServer->registerNode(nodeJsonReport);
    secureServer->registerNode(nodeJsonNodes);
    //    secureServer->registerNode(nodeUpdateFs);
    //    secureServer->registerNode(nodeDeleteFs);
    secureServer->registerNode(nodeAdmin);
    //    secureServer->registerNode(nodeAdminFs);
    //    secureServer->registerNode(nodeAdminSettings);
    //    secureServer->registerNode(nodeAdminSettingsApply);
#if !MESHTASTIC_EXCLUDE_IRRIGATION
    // Rotas do painel de irrigação — antes do catch-all nodeRoot ("/*", GET) para não serem sombreadas.
    registerIrrigationHandlers(secureServer);
    // Portal de campo (Fase 5b): role-agnóstico — /api/portal/* respondem em qualquer papel (não gateado por gwIsGateway).
    registerIrrigationPortalHandlers(secureServer);
    // Portal do device SERVICO (Fase 8c): /api/portal/service/* respondem só quando role==SERVICO.
    registerIrrigationServicePortalHandlers(secureServer);
#endif
    // Estáticos multi-nível (ex.: /irrigacao/portal/app.js): "*" casa 1 segmento, então
    // registramos profundidades extras apontando pro mesmo handleStatic (que usa o path cru).
    secureServer->registerNode(new ResourceNode("/*/*", "GET", &handleStatic));
    secureServer->registerNode(new ResourceNode("/*/*/*", "GET", &handleStatic));
    secureServer->registerNode(new ResourceNode("/*/*/*/*", "GET", &handleStatic));
    secureServer->registerNode(new ResourceNode("/*/*/*/*/*", "GET", &handleStatic));
    secureServer->registerNode(nodeRoot); // This has to be last
    }

    // Insecure nodes
    insecureServer->registerNode(nodeAPIv1ToRadioOptions);
    insecureServer->registerNode(nodeAPIv1ToRadio);
    insecureServer->registerNode(nodeAPIv1FromRadioOptions);
    insecureServer->registerNode(nodeAPIv1FromRadio);
    //    insecureServer->registerNode(nodeHotspotApple);
    //    insecureServer->registerNode(nodeHotspotAndroid);
    insecureServer->registerNode(nodeRestart);
    insecureServer->registerNode(nodeFormUpload);
    insecureServer->registerNode(nodeJsonScanNetworks);
    insecureServer->registerNode(nodeJsonFsBrowseStatic);
    insecureServer->registerNode(nodeJsonDelete);
    insecureServer->registerNode(nodeJsonReport);
    //    insecureServer->registerNode(nodeUpdateFs);
    //    insecureServer->registerNode(nodeDeleteFs);
    insecureServer->registerNode(nodeAdmin);
    //    insecureServer->registerNode(nodeAdminFs);
    //    insecureServer->registerNode(nodeAdminSettings);
    //    insecureServer->registerNode(nodeAdminSettingsApply);
#if !MESHTASTIC_EXCLUDE_IRRIGATION
    // Rotas do painel de irrigação — antes do catch-all nodeRoot ("/*", GET) para não serem sombreadas.
    // Os próprios handlers do painel respondem 404 quando irrigationModule->gwIsGateway() é falso.
    registerIrrigationHandlers(insecureServer);
    // Portal de campo (Fase 5b): role-agnóstico — /api/portal/* respondem em qualquer papel (não gateado por gwIsGateway).
    registerIrrigationPortalHandlers(insecureServer);
    // Portal do device SERVICO (Fase 8c): /api/portal/service/* respondem só quando role==SERVICO.
    registerIrrigationServicePortalHandlers(insecureServer);
#endif
    // Estáticos multi-nível (ex.: /irrigacao/portal/app.js): "*" casa 1 segmento, então
    // registramos profundidades extras apontando pro mesmo handleStatic (que usa o path cru).
    insecureServer->registerNode(new ResourceNode("/*/*", "GET", &handleStatic));
    insecureServer->registerNode(new ResourceNode("/*/*/*", "GET", &handleStatic));
    insecureServer->registerNode(new ResourceNode("/*/*/*/*", "GET", &handleStatic));
    insecureServer->registerNode(new ResourceNode("/*/*/*/*/*", "GET", &handleStatic));
    insecureServer->registerNode(nodeRoot); // This has to be last
}

void handleAPIv1FromRadio(HTTPRequest *req, HTTPResponse *res)
{
    if (webServerThread)
        webServerThread->markActivity();

    LOG_DEBUG("webAPI handleAPIv1FromRadio");

    /*
        For documentation, see:
            https://meshtastic.org/docs/development/device/http-api
            https://meshtastic.org/docs/development/device/client-api
    */

    // Get access to the parameters
    ResourceParameters *params = req->getParams();

    // std::string paramAll = "all";
    std::string valueAll;

    // Status code is 200 OK by default.
    res->setHeader("Content-Type", "application/x-protobuf");
    res->setHeader("Access-Control-Allow-Origin", "*");
    res->setHeader("Access-Control-Allow-Methods", "GET");
    res->setHeader("X-Protobuf-Schema", "https://raw.githubusercontent.com/meshtastic/protobufs/master/meshtastic/mesh.proto");

    if (req->getMethod() == "OPTIONS") {
        res->setStatusCode(204); // Success with no content
        res->print("");
        return;
    }

    uint8_t txBuf[MAX_STREAM_BUF_SIZE];
    uint32_t len = 1;

    if (params->getQueryParameter("all", valueAll)) {

        // If all is true, return all the buffers we have available
        //   to us at this point in time.
        if (valueAll == "true") {
            while (len) {
                len = webAPI.getFromRadio(txBuf);
                res->write(txBuf, len);
            }

            // Otherwise, just return one protobuf
        } else {
            len = webAPI.getFromRadio(txBuf);
            res->write(txBuf, len);
        }

        // the param "all" was not specified. Return just one protobuf
    } else {
        len = webAPI.getFromRadio(txBuf);
        res->write(txBuf, len);
    }

    LOG_DEBUG("webAPI handleAPIv1FromRadio, len %d", len);
}

void handleAPIv1ToRadio(HTTPRequest *req, HTTPResponse *res)
{
    LOG_DEBUG("webAPI handleAPIv1ToRadio");

    /*
        For documentation, see:
            https://meshtastic.org/docs/development/device/http-api
            https://meshtastic.org/docs/development/device/client-api
    */

    res->setHeader("Content-Type", "application/x-protobuf");
    res->setHeader("Access-Control-Allow-Headers", "Content-Type");
    res->setHeader("Access-Control-Allow-Origin", "*");
    res->setHeader("Access-Control-Allow-Methods", "PUT, OPTIONS");
    res->setHeader("X-Protobuf-Schema", "https://raw.githubusercontent.com/meshtastic/protobufs/master/meshtastic/mesh.proto");

    if (req->getMethod() == "OPTIONS") {
        res->setStatusCode(204); // Success with no content
        res->print("");
        return;
    }

    byte buffer[MAX_TO_FROM_RADIO_SIZE];
    size_t s = req->readBytes(buffer, MAX_TO_FROM_RADIO_SIZE);

    LOG_DEBUG("Received %d bytes from PUT request", s);
    webAPI.handleToRadio(buffer, s);

    res->write(buffer, s);
    LOG_DEBUG("webAPI handleAPIv1ToRadio");
}

void htmlDeleteDir(const char *dirname)
{

    File root = FSCom.open(dirname);
    if (!root) {
        return;
    }
    if (!root.isDirectory()) {
        return;
    }

    File file = root.openNextFile();
    while (file) {
        if (file.isDirectory() && !String(file.name()).endsWith(".")) {
            htmlDeleteDir(file.name());
            file.flush();
            file.close();
        } else {
            String fileName = String(file.name());
            file.flush();
            file.close();
            LOG_DEBUG("    %s", fileName.c_str());
            FSCom.remove(fileName);
        }
        file = root.openNextFile();
    }
    root.flush();
    root.close();
}

// Escape a string into a JSON double-quoted literal. Matches the previous
// SimpleJSON StringifyString behavior (0x00-0x1F and 0x7F -> \u00xx lowercase,
// escapes " \ / \b \f \n \r \t, UTF-8 passes through unchanged).
static std::string jsonEscape(const std::string &str)
{
    std::string out = "\"";
    for (size_t i = 0; i < str.size(); ++i) {
        char chr = str[i];
        if (chr == '"' || chr == '\\' || chr == '/') {
            out += '\\';
            out += chr;
        } else if (chr == '\b') {
            out += "\\b";
        } else if (chr == '\f') {
            out += "\\f";
        } else if (chr == '\n') {
            out += "\\n";
        } else if (chr == '\r') {
            out += "\\r";
        } else if (chr == '\t') {
            out += "\\t";
        } else if ((unsigned char)chr < 0x20 || chr == 0x7F) {
            char buf[8];
            snprintf(buf, sizeof(buf), "\\u%04x", (unsigned char)chr);
            out += buf;
        } else {
            out += chr;
        }
    }
    out += "\"";
    return out;
}

// Format a numeric value the way the previous SimpleJSON serializer did
// (std::stringstream with precision 15, NaN/Inf -> "null").
static std::string jsonNum(double v)
{
    if (std::isinf(v) || std::isnan(v))
        return "null";
    std::ostringstream ss;
    ss.precision(15);
    ss << v;
    return ss.str();
}

// Build a serialized JSON array string listing files in `dirname`.
// Subdirectories recurse as nested arrays (up to `levels` deep).
std::string htmlListDir(const char *dirname, uint8_t levels)
{
    File root = FSCom.open(dirname, FILE_O_READ);
    std::string out = "[";
    bool first = true;
    if (!root) {
        out += "]";
        return out;
    }
    if (!root.isDirectory()) {
        out += "]";
        return out;
    }

    // iterate over the file list
    File file = root.openNextFile();
    while (file) {
        std::string element;
        bool haveElement = false;
        if (file.isDirectory() && !String(file.name()).endsWith(".")) {
            if (levels) {
#ifdef ARCH_ESP32
                element = htmlListDir(file.path(), levels - 1);
#else
                element = htmlListDir(file.name(), levels - 1);
#endif
                haveElement = true;
                file.close();
            }
        } else {
#ifdef ARCH_ESP32
            String fileName = String(file.path()).substring(1);
#else
            String fileName = String(file.name()).substring(1);
#endif
            String tempName = String(file.name()).substring(1);
            // Keys in the previous std::map<string,...> were emitted in
            // alphabetical order: name, nameModified, size.
            element = "{";
            element += jsonEscape("name");
            element += ":";
            element += jsonEscape(fileName.c_str());
            if (tempName.endsWith(".gz")) {
#ifdef ARCH_ESP32
                String modifiedFile = String(file.path()).substring(1);
#else
                String modifiedFile = String(file.name()).substring(1);
#endif
                modifiedFile.remove((modifiedFile.length() - 3), 3);
                element += ",";
                element += jsonEscape("nameModified");
                element += ":";
                element += jsonEscape(modifiedFile.c_str());
            }
            element += ",";
            element += jsonEscape("size");
            element += ":";
            element += jsonNum((int)file.size());
            element += "}";
            haveElement = true;
        }
        if (haveElement) {
            if (!first)
                out += ",";
            out += element;
            first = false;
        }
        file.close();
        file = root.openNextFile();
    }
    root.close();
    out += "]";
    return out;
}

void handleFsBrowseStatic(HTTPRequest *req, HTTPResponse *res)
{
    res->setHeader("Content-Type", "application/json");
    res->setHeader("Access-Control-Allow-Origin", "*");
    res->setHeader("Access-Control-Allow-Methods", "GET");

    concurrency::LockGuard g(spiLock);
    std::string fileList = htmlListDir("/static", 10);

    uint64_t total = FSCom.totalBytes();
    uint64_t used = FSCom.usedBytes();

    // Key order matches the previous std::map-based emission (alphabetical).
    std::string out;
    out.reserve(fileList.size() + 128);
    out += "{\"data\":{\"files\":";
    out += fileList;
    out += ",\"filesystem\":{\"free\":";
    out += jsonNum((int)(total - used));
    out += ",\"total\":";
    out += jsonNum((int)total);
    out += ",\"used\":";
    out += jsonNum((int)used);
    out += "}},\"status\":\"ok\"}";

    res->print(out.c_str());
}

void handleFsDeleteStatic(HTTPRequest *req, HTTPResponse *res)
{
    ResourceParameters *params = req->getParams();
    std::string paramValDelete;

    res->setHeader("Content-Type", "application/json");
    res->setHeader("Access-Control-Allow-Origin", "*");
    res->setHeader("Access-Control-Allow-Methods", "DELETE");

    if (params->getQueryParameter("delete", paramValDelete)) {
        std::string pathDelete = "/" + paramValDelete;
        concurrency::LockGuard g(spiLock);
        const char *status = FSCom.remove(pathDelete.c_str()) ? "ok" : "Error";
        LOG_INFO("%s", pathDelete.c_str());
        std::string out = "{\"status\":";
        out += jsonEscape(status);
        out += "}";
        res->print(out.c_str());
        return;
    }
}

void handleStatic(HTTPRequest *req, HTTPResponse *res)
{
    if (webServerThread)
        webServerThread->markActivity();

    // Get access to the parameters
    ResourceParameters *params = req->getParams();

    std::string parameter1;
    // Print the first parameter value
    if (params->getPathParameter(0, parameter1)) {

        // O wildcard "*" da lib casa só UM segmento; para caminhos multi-nível
        // (ex.: /irrigacao/portal/index.html) reconstruímos o path a partir da request crua,
        // descartando query string e a "/" inicial.
        {
            std::string reqPath = req->getRequestString();
            size_t qm = reqPath.find('?');
            if (qm != std::string::npos)
                reqPath = reqPath.substr(0, qm);
            if (!reqPath.empty() && reqPath[0] == '/')
                reqPath.erase(0, 1);
            parameter1 = reqPath;
        }

        // Assets de irrigacao mudam a cada reflash; forca revalidacao para nao servir
        // app.js/index.html/css velhos do cache do browser (portal cativo).
        if (parameter1.rfind("irrigacao", 0) == 0)
            res->setHeader("Cache-Control", "no-cache");

#if !MESHTASTIC_EXCLUDE_IRRIGATION
        // Portal cativo de irrigação: quando o softAP do portal está no ar, qualquer navegação que
        // NÃO seja um arquivo existente (raiz "/", sondas de captive-portal tipo /generate_204 e
        // /hotspot-detect.html, path desconhecido) redireciona pro portal. Assets reais (/irrigacao/*,
        // /static/*) seguem servidos normalmente abaixo. Dispara o popup de "entrar na rede" no celular.
        if (webServerPortalMode) {
            bool haveFile = false;
            if (!parameter1.empty() && parameter1 != "/") {
                concurrency::LockGuard g(spiLock);
                haveFile = FSCom.exists(("/" + parameter1).c_str()) || FSCom.exists(("/" + parameter1 + ".gz").c_str()) ||
                           FSCom.exists(("/static/" + parameter1).c_str()) ||
                           FSCom.exists(("/static/" + parameter1 + ".gz").c_str());
            }
            if (!haveFile) {
                res->setStatusCode(302);
                res->setStatusText("Found");
#if HAS_WIFI
                std::string loc = "http://" + std::string(WiFi.softAPIP().toString().c_str()) + "/irrigacao/portal/index.html";
#else
                std::string loc = "http://192.168.4.1/irrigacao/portal/index.html";
#endif
                res->setHeader("Location", loc);
                res->setHeader("Content-Length", "0");
                return;
            }
        }
#endif

        std::string filename = "/static/" + parameter1;
        std::string filenameGzip = "/static/" + parameter1 + ".gz";
        // Painel de irrigação e afins vivem na raiz do LittleFS (ex.: /irrigacao/*), não em /static/.
        // Fallback: se não achar sob /static/, tenta o caminho cru a partir da raiz.
        std::string filenameRoot = "/" + parameter1;
        std::string filenameRootGzip = "/" + parameter1 + ".gz";

        // Try to open the file
        File file;

        bool has_set_content_type = false;

        if (filename == "/static/") {
            filename = "/static/index.html";
            filenameGzip = "/static/index.html.gz";
        }

        concurrency::LockGuard g(spiLock);

        if (FSCom.exists(filename.c_str())) {
            file = FSCom.open(filename.c_str());
            if (!file.available()) {
                LOG_WARN("File not available - %s", filename.c_str());
            }
        } else if (FSCom.exists(filenameGzip.c_str())) {
            file = FSCom.open(filenameGzip.c_str());
            res->setHeader("Content-Encoding", "gzip");
            if (!file.available()) {
                LOG_WARN("File not available - %s", filenameGzip.c_str());
            }
        } else if (FSCom.exists(filenameRoot.c_str())) {
            filename = filenameRoot; // para o content-type ser deduzido pela extensão certa
            file = FSCom.open(filenameRoot.c_str());
            if (!file.available()) {
                LOG_WARN("File not available - %s", filenameRoot.c_str());
            }
        } else if (FSCom.exists(filenameRootGzip.c_str())) {
            filename = filenameRoot;
            file = FSCom.open(filenameRootGzip.c_str());
            res->setHeader("Content-Encoding", "gzip");
            if (!file.available()) {
                LOG_WARN("File not available - %s", filenameRootGzip.c_str());
            }
        } else {
            has_set_content_type = true;
            filenameGzip = "/static/index.html.gz";
            file = FSCom.open(filenameGzip.c_str());
            res->setHeader("Content-Type", "text/html");
            if (!file.available()) {

                LOG_WARN("File not available - %s", filenameGzip.c_str());
                res->println("Web server is running.<br><br>The content you are looking for can't be found. Please see: <a "
                             "href=https://meshtastic.org/docs/software/web-client/>FAQ</a>.<br><br><a "
                             "href=/admin>admin</a>");

                return;
            } else {
                res->setHeader("Content-Encoding", "gzip");
            }
        }

        res->setHeader("Content-Length", httpsserver::intToString(file.size()));

        // Content-Type is guessed using the definition of the contentTypes-table defined above
        int cTypeIdx = 0;
        do {
            if (filename.rfind(contentTypes[cTypeIdx][0]) != std::string::npos) {
                res->setHeader("Content-Type", contentTypes[cTypeIdx][1]);
                has_set_content_type = true;
                break;
            }
            cTypeIdx += 1;
        } while (strlen(contentTypes[cTypeIdx][0]) > 0);

        if (!has_set_content_type) {
            // Set a default content type
            res->setHeader("Content-Type", "application/octet-stream");
        }

        // Read the file and write it to the HTTP response body
        size_t length = 0;
        do {
            char buffer[256];
            length = file.read((uint8_t *)buffer, 256);
            std::string bufferString(buffer, length);
            res->write((uint8_t *)bufferString.c_str(), bufferString.size());
        } while (length > 0);

        file.close();

        return;
    } else {
        LOG_ERROR("This should not have happened");
        res->println("ERROR: This should not have happened");
    }
}

void handleFormUpload(HTTPRequest *req, HTTPResponse *res)
{

    LOG_DEBUG("Form Upload - Disable keep-alive");
    res->setHeader("Connection", "close");

    // First, we need to check the encoding of the form that we have received.
    // The browser will set the Content-Type request header, so we can use it for that purpose.
    // Then we select the body parser based on the encoding.
    // Actually we do this only for documentary purposes, we know the form is going
    // to be multipart/form-data.
    LOG_DEBUG("Form Upload - Creating body parser reference");
    HTTPBodyParser *parser;
    std::string contentType = req->getHeader("Content-Type");

    // The content type may have additional properties after a semicolon, for example:
    // Content-Type: text/html;charset=utf-8
    // Content-Type: multipart/form-data;boundary=------s0m3w31rdch4r4c73rs
    // As we're interested only in the actual mime _type_, we strip everything after the
    // first semicolon, if one exists:
    size_t semicolonPos = contentType.find(";");
    if (semicolonPos != std::string::npos) {
        contentType.resize(semicolonPos);
    }

    // Now, we can decide based on the content type:
    if (contentType == "multipart/form-data") {
        LOG_DEBUG("Form Upload - multipart/form-data");
        parser = new HTTPMultipartBodyParser(req);
    } else {
        LOG_DEBUG("Unknown POST Content-Type: %s", contentType.c_str());
        return;
    }

    res->println("<html><head><meta http-equiv=\"refresh\" content=\"1;url=/static\" /><title>File "
                 "Upload</title></head><body><h1>File Upload</h1>");

    // We iterate over the fields. Any field with a filename is uploaded.
    // Note that the BodyParser consumes the request body, meaning that you can iterate over the request's
    // fields only a single time. The reason for this is that it allows you to handle large requests
    // which would not fit into memory.
    bool didwrite = false;

    // parser->nextField() will move the parser to the next field in the request body (field meaning a
    // form field, if you take the HTML perspective). After the last field has been processed, nextField()
    // returns false and the while loop ends.
    while (parser->nextField()) {
        // For Multipart data, each field has three properties:
        // The name ("name" value of the <input> tag)
        // The filename (If it was a <input type="file">, this is the filename on the machine of the
        //   user uploading it)
        // The mime type (It is determined by the client. So do not trust this value and blindly start
        //   parsing files only if the type matches)
        std::string name = parser->getFieldName();
        std::string filename = parser->getFieldFilename();
        std::string mimeType = parser->getFieldMimeType();
        // We log all three values, so that you can observe the upload on the serial monitor:
        LOG_DEBUG("handleFormUpload: field name='%s', filename='%s', mimetype='%s'", name.c_str(), filename.c_str(),
                  mimeType.c_str());

        // Double check that it is what we expect
        if (name != "file") {
            LOG_DEBUG("Skip unexpected field");
            res->println("<p>No file found.</p>");
            delete parser;
            return;
        }

        // Double check that it is what we expect
        if (filename == "") {
            LOG_DEBUG("Skip unexpected field");
            res->println("<p>No file found.</p>");
            delete parser;
            return;
        }

        // You should check file name validity and all that, but we skip that to make the core
        // concepts of the body parser functionality easier to understand.
        std::string pathname = "/static/" + filename;

        concurrency::LockGuard g(spiLock);
        // Create a new file to stream the data into
        File file = FSCom.open(pathname.c_str(), FILE_O_WRITE);
        size_t fileLength = 0;
        didwrite = true;

        // With endOfField you can check whether the end of field has been reached or if there's
        // still data pending. With multipart bodies, you cannot know the field size in advance.
        while (!parser->endOfField()) {
            esp_task_wdt_reset();

            byte buf[512];
            size_t readLength = parser->read(buf, 512);
            // LOG_DEBUG("readLength - %i", readLength);

            // Abort the transfer if there is less than 50k space left on the filesystem.
            if (FSCom.totalBytes() - FSCom.usedBytes() < 51200) {
                file.flush();
                file.close();
                res->println("<p>Write aborted! Reserving 50k on filesystem.</p>");

                // enableLoopWDT();

                delete parser;
                return;
            }

            // if (readLength) {
            file.write(buf, readLength);
            fileLength += readLength;
            LOG_DEBUG("File Length %i", fileLength);
            //}
        }
        // enableLoopWDT();

        file.flush();
        file.close();

        res->printf("<p>Saved %d bytes to %s</p>", (int)fileLength, pathname.c_str());
    }
    if (!didwrite) {
        res->println("<p>Did not write any file</p>");
    }
    res->println("</body></html>");
    delete parser;
}

void handleReport(HTTPRequest *req, HTTPResponse *res)
{
    ResourceParameters *params = req->getParams();
    std::string content;

    if (!params->getQueryParameter("content", content)) {
        content = "json";
    }

    if (content == "json") {
        res->setHeader("Content-Type", "application/json");
        res->setHeader("Access-Control-Allow-Origin", "*");
        res->setHeader("Access-Control-Allow-Methods", "GET");
    } else {
        res->setHeader("Content-Type", "text/html");
        res->println("<pre>");
    }

    auto arrayFromLog = [](const uint32_t *logArray, int count) -> std::string {
        std::string s = "[";
        for (int i = 0; i < count; i++) {
            if (i)
                s += ",";
            s += jsonNum((int)logArray[i]);
        }
        s += "]";
        return s;
    };

    uint32_t *logArray;
    logArray = airTime->airtimeReport(TX_LOG);
    std::string txLog = arrayFromLog(logArray, airTime->getPeriodsToLog());
    logArray = airTime->airtimeReport(RX_LOG);
    std::string rxLog = arrayFromLog(logArray, airTime->getPeriodsToLog());
    logArray = airTime->airtimeReport(RX_ALL_LOG);
    std::string rxAllLog = arrayFromLog(logArray, airTime->getPeriodsToLog());

    String wifiIPString = WiFi.localIP().toString();
    std::string wifiIP = wifiIPString.c_str();

    spiLock->lock();
    uint64_t fsTotal = FSCom.totalBytes();
    uint64_t fsUsed = FSCom.usedBytes();
    spiLock->unlock();

    // Emit keys in the same alphabetical order as the previous
    // std::map-based JSON output to keep responses byte-compatible.
    std::string out;
    out.reserve(1024);
    out += "{\"data\":{";

    // airtime
    out += "\"airtime\":{";
    out += "\"channel_utilization\":";
    out += jsonNum(airTime->channelUtilizationPercent());
    out += ",\"periods_to_log\":";
    out += jsonNum(airTime->getPeriodsToLog());
    out += ",\"rx_all_log\":";
    out += rxAllLog;
    out += ",\"rx_log\":";
    out += rxLog;
    out += ",\"seconds_per_period\":";
    out += jsonNum((int)airTime->getSecondsPerPeriod());
    out += ",\"seconds_since_boot\":";
    out += jsonNum((int)airTime->getSecondsSinceBoot());
    out += ",\"tx_log\":";
    out += txLog;
    out += ",\"utilization_tx\":";
    out += jsonNum(airTime->utilizationTXPercent());
    out += "}";

    // device
    out += ",\"device\":{\"reboot_counter\":";
    out += jsonNum((int)myNodeInfo.reboot_count);
    out += "}";

    // memory
    out += ",\"memory\":{";
    out += "\"fs_free\":";
    out += jsonNum((int)(fsTotal - fsUsed));
    out += ",\"fs_total\":";
    out += jsonNum((int)fsTotal);
    out += ",\"fs_used\":";
    out += jsonNum((int)fsUsed);
    out += ",\"heap_free\":";
    out += jsonNum((int)memGet.getFreeHeap());
    out += ",\"heap_total\":";
    out += jsonNum((int)memGet.getHeapSize());
    out += ",\"psram_free\":";
    out += jsonNum((int)memGet.getFreePsram());
    out += ",\"psram_total\":";
    out += jsonNum((int)memGet.getPsramSize());
    out += "}";

    // power (has_* / is_charging were serialized as the strings "true"/"false")
    out += ",\"power\":{";
    out += "\"battery_percent\":";
    out += jsonNum(powerStatus->getBatteryChargePercent());
    out += ",\"battery_voltage_mv\":";
    out += jsonNum(powerStatus->getBatteryVoltageMv());
    out += ",\"has_battery\":";
    out += jsonEscape(BoolToString(powerStatus->getHasBattery()));
    out += ",\"has_usb\":";
    out += jsonEscape(BoolToString(powerStatus->getHasUSB()));
    out += ",\"is_charging\":";
    out += jsonEscape(BoolToString(powerStatus->getIsCharging()));
    out += "}";

    // radio
    out += ",\"radio\":{\"frequency\":";
    out += jsonNum(RadioLibInterface::instance->getFreq());
    out += ",\"lora_channel\":";
    out += jsonNum((int)RadioLibInterface::instance->getChannelNum() + 1);
    out += "}";

    // wifi
    out += ",\"wifi\":{\"ip\":";
    out += jsonEscape(wifiIP);
    out += ",\"rssi\":";
    out += jsonNum(WiFi.RSSI());
    out += "}";

    out += "},\"status\":\"ok\"}";

    res->print(out.c_str());
}

void handleNodes(HTTPRequest *req, HTTPResponse *res)
{
    ResourceParameters *params = req->getParams();
    std::string content;

    if (!params->getQueryParameter("content", content)) {
        content = "json";
    }

    if (content == "json") {
        res->setHeader("Content-Type", "application/json");
        res->setHeader("Access-Control-Allow-Origin", "*");
        res->setHeader("Access-Control-Allow-Methods", "GET");
    } else {
        res->setHeader("Content-Type", "text/html");
        res->println("<pre>");
    }

    std::string out;
    out.reserve(2048);
    out += "{\"data\":{\"nodes\":[";

    bool firstNode = true;
    uint32_t readIndex = 0;
    const meshtastic_NodeInfoLite *tempNodeInfo = nodeDB->readNextMeshNode(readIndex);
    while (tempNodeInfo != NULL) {
        if (nodeInfoLiteHasUser(tempNodeInfo)) {
            char id[16];
            snprintf(id, sizeof(id), "!%08x", tempNodeInfo->num);

            std::string position;
            if (nodeDB->hasValidPosition(tempNodeInfo)) {
                meshtastic_PositionLite posLite;
                if (nodeDB->copyNodePosition(tempNodeInfo->num, posLite)) {
                    position = "{\"altitude\":";
                    position += jsonNum((int)posLite.altitude);
                    position += ",\"latitude\":";
                    position += jsonNum((float)posLite.latitude_i * 1e-7);
                    position += ",\"longitude\":";
                    position += jsonNum((float)posLite.longitude_i * 1e-7);
                    position += "}";
                } else {
                    position = "null";
                }
            } else {
                position = "null";
            }

            if (!firstNode)
                out += ",";
            firstNode = false;

            // Alphabetical key order matches previous std::map-based output.
            out += "{\"hw_model\":";
            out += jsonNum(tempNodeInfo->hw_model);
            out += ",\"id\":";
            out += jsonEscape(id);
            out += ",\"last_heard\":";
            out += jsonNum((int)tempNodeInfo->last_heard);
            out += ",\"long_name\":";
            out += jsonEscape(tempNodeInfo->long_name);
            out += ",\"mac_address\":";
            out += jsonEscape("00:00:00:00:00:00");
            out += ",\"position\":";
            out += position;
            out += ",\"short_name\":";
            out += jsonEscape(tempNodeInfo->short_name);
            out += ",\"snr\":";
            out += jsonNum(tempNodeInfo->snr);
            out += ",\"via_mqtt\":";
            out += jsonEscape(BoolToString(nodeInfoLiteViaMqtt(tempNodeInfo)));
            out += "}";
        }
        tempNodeInfo = nodeDB->readNextMeshNode(readIndex);
    }

    out += "]},\"status\":\"ok\"}";
    res->print(out.c_str());
}

/*
    This supports the Apple Captive Network Assistant (CNA) Portal
*/
void handleHotspot(HTTPRequest *req, HTTPResponse *res)
{
    LOG_INFO("Hotspot Request");

    /*
        If we don't do a redirect, be sure to return a "Success" message
        otherwise iOS will have trouble detecting that the connection to the SoftAP worked.
    */

    // Status code is 200 OK by default.
    // We want to deliver a simple HTML page, so we send a corresponding content type:
    res->setHeader("Content-Type", "text/html");
    res->setHeader("Access-Control-Allow-Origin", "*");
    res->setHeader("Access-Control-Allow-Methods", "GET");

    // res->println("<!DOCTYPE html>");
    res->println("<meta http-equiv=\"refresh\" content=\"0;url=/\" />");
}

void handleDeleteFsContent(HTTPRequest *req, HTTPResponse *res)
{
    res->setHeader("Content-Type", "text/html");
    res->setHeader("Access-Control-Allow-Origin", "*");
    res->setHeader("Access-Control-Allow-Methods", "GET");

    res->println("<h1>Meshtastic</h1>");
    res->println("Delete Content in /static/*");

    LOG_INFO("Delete files from /static/* : ");

    concurrency::LockGuard g(spiLock);
    htmlDeleteDir("/static");

    res->println("<p><hr><p><a href=/admin>Back to admin</a>");
}

void handleAdmin(HTTPRequest *req, HTTPResponse *res)
{
    res->setHeader("Content-Type", "text/html");
    res->setHeader("Access-Control-Allow-Origin", "*");
    res->setHeader("Access-Control-Allow-Methods", "GET");

    res->println("<h1>Meshtastic</h1>");
    //    res->println("<a href=/admin/settings>Settings</a><br>");
    //    res->println("<a href=/admin/fs>Manage Web Content</a><br>");
    res->println("<a href=/json/report>Device Report</a><br>");
}

void handleAdminSettings(HTTPRequest *req, HTTPResponse *res)
{
    res->setHeader("Content-Type", "text/html");
    res->setHeader("Access-Control-Allow-Origin", "*");
    res->setHeader("Access-Control-Allow-Methods", "GET");

    res->println("<h1>Meshtastic</h1>");
    res->println("This isn't done.");
    res->println("<form action=/admin/settings/apply method=post>");
    res->println("<table border=1>");
    res->println("<tr><td>Set?</td><td>Setting</td><td>current value</td><td>new value</td></tr>");
    res->println("<tr><td><input type=checkbox></td><td>WiFi SSID</td><td>false</td><td><input type=radio></td></tr>");
    res->println("<tr><td><input type=checkbox></td><td>WiFi Password</td><td>false</td><td><input type=radio></td></tr>");
    res->println(
        "<tr><td><input type=checkbox></td><td>Smart Position Update</td><td>false</td><td><input type=radio></td></tr>");
    res->println("</table>");
    res->println("<table>");
    res->println("<input type=submit value=Apply New Settings>");
    res->println("<form>");
    res->println("<p><hr><p><a href=/admin>Back to admin</a>");
}

void handleAdminSettingsApply(HTTPRequest *req, HTTPResponse *res)
{
    res->setHeader("Content-Type", "text/html");
    res->setHeader("Access-Control-Allow-Origin", "*");
    res->setHeader("Access-Control-Allow-Methods", "POST");
    res->println("<h1>Meshtastic</h1>");
    res->println(
        "<html><head><meta http-equiv=\"refresh\" content=\"1;url=/admin/settings\" /><title>Settings Applied. </title>");

    res->println("Settings Applied. Please wait.");
}

void handleFs(HTTPRequest *req, HTTPResponse *res)
{
    res->setHeader("Content-Type", "text/html");
    res->setHeader("Access-Control-Allow-Origin", "*");
    res->setHeader("Access-Control-Allow-Methods", "GET");

    res->println("<h1>Meshtastic</h1>");
    res->println("<a href=/admin/fs/delete>Delete Web Content</a><p><form action=/admin/fs/update "
                 "method=post><input type=submit value=UPDATE_WEB_CONTENT></form>Be patient!");
    res->println("<p><hr><p><a href=/admin>Back to admin</a>");
}

void handleRestart(HTTPRequest *req, HTTPResponse *res)
{
    res->setHeader("Content-Type", "text/html");
    res->setHeader("Access-Control-Allow-Origin", "*");
    res->setHeader("Access-Control-Allow-Methods", "GET");

    res->println("<h1>Meshtastic</h1>");
    res->println("Restarting");

    LOG_DEBUG("Restarted on HTTP(s) Request");
    webServerThread->requestRestart = (millis() / 1000) + 5;
}

void handleScanNetworks(HTTPRequest *req, HTTPResponse *res)
{
    res->setHeader("Content-Type", "application/json");
    res->setHeader("Access-Control-Allow-Origin", "*");
    res->setHeader("Access-Control-Allow-Methods", "GET");
    // res->setHeader("Content-Type", "text/html");

    int n = WiFi.scanNetworks();

    std::string out = "{\"data\":[";
    bool firstNet = true;
    if (n > 0) {
        for (int i = 0; i < n; ++i) {
            char ssidArray[50];
            // The previous implementation pre-escaped quotes before handing
            // the value to the JSON serializer; preserve that (byte-compatible
            // even if it double-encodes a quote) so existing clients are not
            // affected by this refactor.
            String ssidString = String(WiFi.SSID(i));
            ssidString.replace("\"", "\\\"");
            ssidString.toCharArray(ssidArray, 50);

            if (WiFi.encryptionType(i) != WIFI_AUTH_OPEN) {
                if (!firstNet)
                    out += ",";
                firstNet = false;
                out += "{\"rssi\":";
                out += jsonNum((int)WiFi.RSSI(i));
                out += ",\"ssid\":";
                out += jsonEscape(ssidArray);
                out += "}";
            }
            // Yield some cpu cycles to IP stack.
            //   This is important in case the list is large and it takes us time to return
            //   to the main loop.
            yield();
        }
    }
    out += "],\"status\":\"ok\"}";
    res->print(out.c_str());
}
#endif
