jeffersonpimenta/firmware/src/modules/irrigation/IrrigationWebApi.h

#pragma once
#include "modules/irrigation/GatewayTables.h"
#include "modules/irrigation/HydraulicGroupTable.h"
#include "modules/irrigation/InterlockTable.h"
#include "modules/irrigation/IrrigationProtocol.h"
#include "modules/irrigation/LevelControlTable.h"
#include "modules/irrigation/ProgramScheduler.h"
#include "modules/irrigation/RemoteButtonTable.h"
#include "modules/irrigation/StationMonitor.h" // AlertCenter/Alert p/ buildAlerts
#include "modules/irrigation/SurveyLog.h"
#include "modules/irrigation/WeatherConfig.h"
#include "modules/irrigation/WeatherForecast.h"
#include "modules/irrigation/WeatherRuleTable.h"
#include <cstddef>
#include <cstdint>

namespace IrrigationWeb
{

// Writer JSON mínimo: escreve em um buffer fixo do chamador. overflow() vira true e
// todas as escritas subsequentes viram no-op; done() devolve bytes escritos ou 0 se
// houve overflow. Sem alocação, sem dependência externa.
class JsonWriter
{
  public:
    JsonWriter(char *buf, size_t cap) : _b(buf), _cap(cap) {}
    void beginObject();
    void endObject();
    void beginArray();
    void endArray();
    void key(const char *k);          // escreve "k": e arma vírgula pós-valor
    void str(const char *v);          // valor string (com escape básico)
    void num(int64_t v);              // valor inteiro
    void boolean(bool v);
    void raw(const char *v);          // valor já-JSON (ex.: objeto aninhado montado à parte)
    void keyStr(const char *k, const char *v) { key(k); str(v); }
    void keyNum(const char *k, int64_t v) { key(k); num(v); }
    void keyBool(const char *k, bool v) { key(k); boolean(v); }
    bool overflow() const { return _ovf; }
    size_t done();                    // fecha nada; devolve _len (0 se overflow)

  private:
    void putc_(char c);
    void puts_(const char *s);
    void sep_();                      // vírgula entre itens conforme estado
    char *_b;
    size_t _cap;
    size_t _len = 0;
    bool _ovf = false;
    bool _needComma = false;
};

enum class SyncState : uint8_t { SINCRONIZADA = 0, PENDENTE = 1, INALCANCAVEL = 2 };
SyncState computeSync(uint32_t desiredEpoch, uint32_t reportedEpoch, bool silent);
const char *syncLabel(SyncState s); // "sincronizada" | "pendente" | "inalcancavel"

struct OverviewCtx {
    bool hasRtc = false;
    uint16_t stationCount = 0;
    uint8_t running = 0; // 0 = ocioso, 1 = executando
    uint16_t alertCount = 0;
    bool pairingPending = false;
    uint32_t pairingNodeId = 0;
    uint16_t pairingSecondsLeft = 0;
    uint8_t runningZoneId = 0;
    uint16_t runningRemainMin = 0;
    uint32_t selfNode = 0; // node do próprio gateway (p/ opção "Gateway (local)" no form de zona)
};
size_t buildOverview(const OverviewCtx &ctx, char *buf, size_t cap);

// --- Fase 8b: Horário (relógio do gateway) ---
struct TzPreset {
    const char *label; // IANA-like exibido na UI
    const char *posix; // string gravada em config.device.tzdef
};
extern const TzPreset TZ_PRESETS[];
extern const size_t TZ_PRESETS_COUNT;
// "Personalizado" se posix não bate nenhum preset (ou é vazio).
const char *tzLabelFor(const char *posix);
bool tzIsValidPreset(const char *posix);

struct TimeStatusCtx {
    uint32_t nowEpoch = 0;      // 0 = sem relógio válido
    int quality = 0;            // getRTCQuality() cru (NTP=3, GPS=2, Device=1, None=0)
    const char *ntpServer = ""; // config.network.ntp_server
    int32_t lastSyncS = -1;     // segundos desde o último NTP set; -1 = nunca
    const char *tz = "";        // config.device.tzdef
    bool staUp = false;         // WiFi STA conectado
};
size_t buildTimeStatus(const TimeStatusCtx &ctx, char *buf, size_t cap);

// Alertas não reconhecidos (§8.1–§8.3): serializa os alertas do AlertCenter com atMs > ackMs.
// ageS = (nowMs - atMs)/1000. JSON: [{type,node,arg,ageS}]. "[]" se nada pendente.
size_t buildAlerts(const AlertCenter &ac, uint32_t nowMs, uint32_t ackMs, char *buf, size_t cap);

// Saída física de uma estação (deriva dos pinos configurados no blob). tipo: 0=válvula, 1=gpo.
struct StationOutput {
    uint8_t tipo = 0;
    uint8_t index = 0;
};

struct StationView {
    uint32_t node = 0;
    const char *name = "";
    SyncState sync = SyncState::SINCRONIZADA;
    uint32_t secsSinceHeard = 0;
    uint16_t vbatCentiV = 0;
    uint16_t vpanelCentiV = 0;
    int8_t snrQuarterDb = 0;
    int16_t rssiDbm = 0;
    uint16_t rebootCount = 0;
    uint8_t flags = 0; // HbFlags: tamper/safe/hibernation
    int32_t lat = 0, lon = 0;
    // Fase 9: config desejada (do blob) exposta p/ leitura/edição no sheet.
    uint16_t hbMinutes = 0;
    uint16_t vbatAvisoCentiV = 0;
    uint16_t vbatCriticaCentiV = 0;
    // Fase 9: saídas físicas p/ o teste de pulso.
    static constexpr uint8_t MAX_OUTPUTS = 10; // MAX_VALVES(8) + MAX_GPO(2)
    StationOutput outputs[MAX_OUTPUTS];
    uint8_t outputCount = 0;
};
size_t buildStations(const StationView *views, size_t n, char *buf, size_t cap);

size_t buildZones(const ZoneTable &zones, char *buf, size_t cap);
size_t buildPrograms(const ProgramScheduler &sched, char *buf, size_t cap);

struct ParseError {
    char msg[48];
};
struct ParseResult {
    bool ok = true;
    uint8_t errorCount = 0;
    ParseError errors[4];
    void fail(const char *m);
};

// Reader de objeto JSON plano: só o nível superior, valores número/string/bool.
// Sem aninhamento (arrays/objetos são ignorados pelas getters escalares). Suficiente
// para os corpos que o painel envia. Para programas (com array), ver Task 7.
class JsonReader
{
  public:
    JsonReader(const char *json, size_t len) : _j(json), _len(len) {}
    bool getInt(const char *key, int64_t &out) const;
    bool getStr(const char *key, char *out, size_t cap) const;
    bool getBool(const char *key, bool &out) const;

  private:
    const char *findValue(const char *key) const; // aponta pro 1º char do valor, ou nullptr
    const char *_j;
    size_t _len;
};

ParseResult parseZoneUpsert(const char *json, size_t len, Zone &out);
ParseResult parseZoneDelete(const char *json, size_t len, uint8_t &outId);

// --- Fase 8b: Horário (parsers) ---
// epoch plausível: >= 1_600_000_000 (2020-09) e <= 4_102_444_800 (2100).
ParseResult parseTimeSet(const char *json, size_t len, uint32_t &epochOut);
// Copia tz para out (validado contra TZ_PRESETS). Rejeita fora do preset.
ParseResult parseTimezone(const char *json, size_t len, char *out, size_t outCap);

ParseResult parseProgramUpsert(const char *json, size_t len, Program &out);
ParseResult parseProgramToggle(const char *json, size_t len, uint8_t &outId, bool &outEnabled);
ParseResult parseProgramDelete(const char *json, size_t len, uint8_t &outId);

enum class CmdKind : uint8_t { NONE, PULSE_TEST, OPEN, CLOSE, ACK_ALERT, APPROVE_PAIRING };
struct WebCommand {
    CmdKind kind = CmdKind::NONE;
    uint8_t zoneId = 0;
    uint16_t durationS = 0;
    uint32_t node = 0;
    // ACK_ALERT: identidade do alerta clicado (node acima + estes 3). atMs==0 ⇒ reconhecer todos (legado).
    uint8_t alertType = 0;
    uint32_t arg = 0;
    uint32_t atMs = 0;
};
ParseResult parseCommand(const char *json, size_t len, WebCommand &out);

// ── Fase 9 — configuração/remoção/pulso de estação ───────────────────────────
// Config de estação (POST /stations/config). Tudo inteiro (JsonReader é int-only):
// volts em centi-volt, coordenadas em graus×1e7 (mesma escala do blob latE7/lonE7).
struct StationConfigReq {
    uint32_t node = 0;
    uint16_t hbMinutes = 10;
    uint16_t vbatAvisoCentiV = 1220;
    uint16_t vbatCriticaCentiV = 1180;
    int32_t latE7 = 0;
    int32_t lonE7 = 0;
};
ParseResult parseStationConfig(const char *json, size_t len, StationConfigReq &out);
ParseResult parseStationDelete(const char *json, size_t len, uint32_t &outNode);

// Teste de pulso por saída (POST /stations/pulse).
struct StationPulseReq {
    uint32_t node = 0;
    uint8_t tipo = 0; // 0=válvula, 1=gpo
    uint8_t index = 0;
    uint16_t durationS = 10;
};
ParseResult parseStationPulse(const char *json, size_t len, StationPulseReq &out);

// ── Fase 6b — intertravamentos ───────────────────────────────────────────────

size_t buildInterlocks(const InterlockTable &tbl, char *buf, size_t cap);
ParseResult parseInterlockUpsert(const char *json, size_t len, InterlockRule &out);
ParseResult parseInterlockDelete(const char *json, size_t len, uint8_t &outId);

// ── Fase 6b — sensores do gateway ────────────────────────────────────────────

// Item de sensor individual para exibição no painel.
struct GwSensorItem {
    uint8_t idx;           // 0..HB_MAX_SENSORS-1
    uint8_t tipo;          // tipo de sensor (campo raw do protocolo)
    int16_t valueCenti;    // valor em centésimos da unidade
    const char *name;      // ponteiro p/ nome — "" = sem nome configurado
};

// Vista de uma estação com seus sensores, pronta para serialização.
struct GwStationSensors {
    uint32_t node;
    const char *stationName; // "" = sem nome
    bool tamper;
    uint8_t count;           // quantos itens válidos em `itens`
    GwSensorItem itens[IrrigationProto::HB_MAX_SENSORS];
};

// Serializa array de estações com sensores.
// JSON: [{node,nome,tamper,sensores:[{idx,tipo,valor,nome},...]}]
size_t buildSensorsGateway(const GwStationSensors *views, size_t n, char *buf, size_t cap);

// ── Fase 6b — janela de manutenção / nomes de sensor ─────────────────────────

// Parse {node, minutes}. minutes validado em 0..1440.
ParseResult parseMaintWindow(const char *json, size_t len, uint32_t &outNode, uint16_t &outMinutes);

// Parse {node, sensor, nome}. sensor validado em 0..3; nome truncado a nameCap-1.
ParseResult parseSensorName(const char *json, size_t len,
                            uint32_t &outNode, uint8_t &outIdx,
                            char *outName, size_t nameCap);

// ── Fase 7b — grupos hidráulicos ─────────────────────────────────────────────

ParseResult parseGroupUpsert(const char *json, size_t len, HydraulicGroup &out);
ParseResult parseGroupDelete(const char *json, size_t len, uint8_t &outId);
// {id, acao:"abrir"|"fechar", durationS?}. durationS omitido => 0 (módulo aplica default).
ParseResult parseGroupCommand(const char *json, size_t len, uint8_t &outId, bool &outOpen, uint16_t &outDurationS);

// Validação semântica (precisa da ZoneTable). true=ok; senão preenche err (>=48 bytes).
bool validateGroupZones(const HydraulicGroup &g, const ZoneTable &zones, char *err, size_t errCap);

const char *groupStateLabel(uint8_t state);
size_t buildGroups(const HydraulicGroupTable &tbl, char *buf, size_t cap);

struct GroupStatusView {
    uint8_t id = 0;
    const char *name = "";
    uint8_t state = 0;     // HydraulicGroupEngine::State
    bool pump = false;
    uint8_t curZone = 0;
    uint8_t openCount = 0;
};
size_t buildGroupsStatus(const GroupStatusView *views, size_t n, char *buf, size_t cap);

// ── Fase 8b — controle de nível (boia) ───────────────────────────────────────

size_t buildLevelControls(const LevelControlTable &tbl, char *buf, size_t cap);
ParseResult parseLevelUpsert(const char *json, size_t len, LevelRule &out);
ParseResult parseLevelDelete(const char *json, size_t len, uint8_t &outId);

// ── Fase 8d — site survey (§8.5) ─────────────────────────────────────────────
// Serializa pontos de survey p/ a tabela Cobertura do painel. idadeS = nowS - uptimeS.
size_t buildSurvey(const SurveyPoint *pts, size_t n, uint32_t nowS, char *buf, size_t cap);

struct SurveyStartReq {
    uint16_t intervalS = 5;
    uint16_t timeoutS = 300;
    int32_t latE7 = 0, lonE7 = 0;
    bool hasCoord = false;
};
// {intervalS?, timeoutS?, lat?, lon?}. Defaults 5 s / 300 s; clamp [1,3600].
// hasCoord = lat E lon presentes. Nunca falha (pr.ok sempre true).
ParseResult parseSurveyStart(const char *json, size_t len, SurveyStartReq &out);

// ── Sistema restore — import de tabelas de configuração (§5.5) ───────────────

struct ImportCounts {
    uint8_t zonas = 0;
    uint8_t programas = 0;
    uint8_t intertravamentos = 0;
    uint8_t grupos = 0;
};
// Aplica os 4 arrays de tabela do primeiro client do envelope. NÃO toca PSK/estações.
// false = envelope inválido (validateEnvelope) — tabelas ficam intactas.
bool importConfigTablesFromBackup(const char *json, size_t len, ZoneTable &zones,
                                  ProgramScheduler &sched, InterlockTable &interlocks,
                                  HydraulicGroupTable &groups, ImportCounts &out,
                                  char *err, size_t errCap);

// Importa o array remoteButtons do primeiro client do envelope para a tabela fornecida.
// Retorna o número de itens importados (0 = seção ausente ou vazia).
// Não valida o envelope — deve ser chamada após importConfigTablesFromBackup que já valida.
size_t importRemoteButtonsFromBackup(const char *json, size_t n, RemoteButtonTable &out);

// ── Supressão meteorológica (fase 11) ────────────────────────────────────────

// Contexto de status agregado da página Meteorologia.
struct WeatherStatusCtx {
    const WeatherConfig *cfg = nullptr;
    const WeatherCache *cache = nullptr;
    const WeatherRuleTable *rules = nullptr;
    uint32_t nowEpoch = 0;
    bool staUp = false;
    const char *location = ""; // rótulo (nome do nó / "Gateway")
};
size_t buildWeatherStatus(const WeatherStatusCtx &ctx, char *buf, size_t cap);

// Parse do POST de regra. Espelha saveWeatherRule() do mockup.
struct WeatherRuleParse {
    bool ok = false;
    WeatherRule rule;
    const char *err = "";
};
WeatherRuleParse parseWeatherRule(const char *body, size_t n);

struct WeatherConfigParse {
    bool ok = false;
    uint8_t enabled = 0;
    int32_t latE7 = 0;
    int32_t lonE7 = 0;
    const char *err = "";
};
WeatherConfigParse parseWeatherConfig(const char *body, size_t n);

// ── Modo Espelhamento UI — web helpers ────────────────────────────────────────

// {enabled: bool}. Falha se "enabled" ausente.
ParseResult parseMirrorToggle(const char *json, size_t len, bool &enabled);

// {input:0..3, zoneId:1..255, invertido?:bool, habilitado?:bool}.
// Falha se input fora de 0..3 ou zoneId fora de 1..255.
ParseResult parseMirrorMapping(const char *json, size_t len, int8_t &input, uint8_t &zoneId,
                               bool &invertido, bool &habilitado);

// Serializa estado do modo espelho: {enabled, ports:[{i,active,invertido[,zoneId,zoneName,habilitado,driving]}]}.
// Per porta (i=0..3): emite zoneId/zoneName/habilitado/driving apenas se uma zona tem fonteInput==i.
// liveActive[i]: estado ao vivo do GPIO (após inversão de hardware).
size_t buildMirror(char *buf, size_t cap, bool enabled, const ZoneTable &zones,
                   uint8_t digitalInActiveLow, const bool liveActive[4]);

// ── Modo Remoto — web helpers ─────────────────────────────────────────────────

struct RemoteUpsertReq {
    uint8_t id = 0;
    uint8_t enabled = 1;
    uint8_t targetZoneId = 0;
    RemoteTriggerRef triggers[4];
    uint8_t triggerCount = 0;
};

// {id, enabled?, targetZoneId, triggers:[{node,inputIdx,ledSlot?}]}
// ledSlot ausente → 255. Falha se targetZoneId==0 ou triggers ausente/vazio.
bool parseRemoteUpsert(const char *json, size_t n, RemoteUpsertReq &out);

// {id:1..255}
bool parseRemoteDelete(const char *json, size_t n, uint8_t &idOut);

// {targetZoneId:1..255}
bool parseRemoteCommand(const char *json, size_t n, uint8_t &targetZoneIdOut);

// Valida semântica: targetZoneId!=0, triggerCount>=1, cada inputIdx<4,
// cada ledSlot in {0,1,255}, sem nó duplicado entre gatilhos.
bool validateRemoteTriggers(const RemoteUpsertReq &u);

// Serializa array de associações: [{id,enabled,targetZoneId,zoneName,triggers:[{node,inputIdx,ledSlot}]}]
size_t buildRemote(char *buf, size_t cap, const RemoteButtonTable &t, const ZoneTable &zones);

// Serializa status por saída distinta (dedup por targetZoneId):
// [{targetZoneId,name,on,triggers:[{node,inputIdx,ledSlot}]}]
// on = zoneOpenById[targetZoneId]. Cada saída emitida UMA vez mesmo com múltiplas associações.
size_t buildRemoteStatus(char *buf, size_t cap, const RemoteButtonTable &t, const ZoneTable &zones,
                         const bool *zoneOpenById /*index 0..255*/);

} // namespace IrrigationWeb
