jeffersonpimenta/firmware/src/modules/irrigation/ServiceBackup.cpp

#include "modules/irrigation/ServiceBackup.h"
#include "modules/irrigation/IrrigationWebApi.h" // JsonWriter
#include <cstdio>
#include <cstdlib>
#include <cstring>

namespace IrrigationService {

static const char kB64[] = "ABCDEFGHIJKLMNOPQRSTUVWXYZabcdefghijklmnopqrstuvwxyz0123456789+/";

size_t base64Encode(const uint8_t *in, size_t n, char *out, size_t cap)
{
    size_t need = ((n + 2) / 3) * 4;
    if (need > cap)
        return 0;
    size_t o = 0;
    for (size_t i = 0; i < n; i += 3) {
        uint32_t v = in[i] << 16;
        if (i + 1 < n)
            v |= in[i + 1] << 8;
        if (i + 2 < n)
            v |= in[i + 2];
        out[o++] = kB64[(v >> 18) & 63];
        out[o++] = kB64[(v >> 12) & 63];
        out[o++] = (i + 1 < n) ? kB64[(v >> 6) & 63] : '=';
        out[o++] = (i + 2 < n) ? kB64[v & 63] : '=';
    }
    return o;
}

static int b64val(char c)
{
    if (c >= 'A' && c <= 'Z')
        return c - 'A';
    if (c >= 'a' && c <= 'z')
        return c - 'a' + 26;
    if (c >= '0' && c <= '9')
        return c - '0' + 52;
    if (c == '+')
        return 62;
    if (c == '/')
        return 63;
    return -1;
}

int base64Decode(const char *in, size_t n, uint8_t *out, size_t cap)
{
    if (n % 4 != 0)
        return -1;
    size_t o = 0;
    for (size_t i = 0; i < n; i += 4) {
        int a = b64val(in[i]), b = b64val(in[i + 1]);
        if (a < 0 || b < 0)
            return -1;
        bool p2 = in[i + 2] == '=', p3 = in[i + 3] == '=';
        int c = p2 ? 0 : b64val(in[i + 2]);
        int d = p3 ? 0 : b64val(in[i + 3]);
        if ((!p2 && c < 0) || (!p3 && d < 0))
            return -1;
        uint32_t v = (a << 18) | (b << 12) | (c << 6) | d;
        if (o >= cap)
            return -1;
        out[o++] = (v >> 16) & 0xff;
        if (!p2) {
            if (o >= cap)
                return -1;
            out[o++] = (v >> 8) & 0xff;
        }
        if (!p3) {
            if (o >= cap)
                return -1;
            out[o++] = v & 0xff;
        }
    }
    return (int)o;
}

// ── Structural JSON scanner ─────────────────────────────────────────────────

static const char *skipWs(const char *p, const char *end)
{
    while (p < end && (*p == ' ' || *p == '\t' || *p == '\n' || *p == '\r'))
        ++p;
    return p;
}

// p at value start → pointer just past the value (string/object/array/scalar).
static const char *skipValue(const char *p, const char *end)
{
    p = skipWs(p, end);
    if (p >= end)
        return end;
    if (*p == '"') {
        ++p;
        while (p < end && *p != '"') {
            if (*p == '\\' && p + 1 < end)
                ++p;
            ++p;
        }
        return (p < end) ? p + 1 : end;
    }
    if (*p == '{' || *p == '[') {
        char open = *p, close = (open == '{') ? '}' : ']';
        int d = 0;
        bool ins = false;
        for (; p < end; ++p) {
            char c = *p;
            if (ins) {
                if (c == '\\') {
                    ++p;
                    continue;
                }
                if (c == '"')
                    ins = false;
                continue;
            }
            if (c == '"')
                ins = true;
            else if (c == open)
                ++d;
            else if (c == close && --d == 0)
                return p + 1;
        }
        return end;
    }
    while (p < end && *p != ',' && *p != '}' && *p != ']' && *p != ' ' && *p != '\t' && *p != '\n' && *p != '\r')
        ++p;
    return p;
}

// Iterate object members; cb(ctx, keySlice(without quotes), valueSlice). Stop if cb false.
static bool forEachObjMember(const char *obj, size_t n, void *ctx, bool (*cb)(void *, Slice, Slice))
{
    const char *p = obj, *end = obj + n;
    p = skipWs(p, end);
    if (p >= end || *p != '{')
        return false;
    ++p;
    while (p < end) {
        p = skipWs(p, end);
        if (p < end && *p == '}')
            return true;
        if (p >= end || *p != '"')
            return false;
        const char *ks = p + 1, *ke = ks;
        while (ke < end && *ke != '"') {
            if (*ke == '\\')
                ++ke;
            ++ke;
        }
        p = (ke < end) ? ke + 1 : end;
        p = skipWs(p, end);
        if (p >= end || *p != ':')
            return false;
        ++p;
        p = skipWs(p, end);
        const char *vs = p, *ve = skipValue(p, end);
        Slice ks2{ks, (size_t)(ke - ks)}, vs2{vs, (size_t)(ve - vs)};
        if (!cb(ctx, ks2, vs2))
            return true;
        p = skipWs(ve, end);
        if (p < end && *p == ',')
            ++p;
    }
    return true;
}

struct MemberFind {
    const char *key;
    size_t klen;
    Slice out;
    bool found;
};
static bool memberFindCb(void *c, Slice k, Slice v)
{
    auto *m = (MemberFind *)c;
    if (k.n == m->klen && memcmp(k.p, m->key, m->klen) == 0) {
        m->out = v;
        m->found = true;
        return false; // stop
    }
    return true;
}

bool jsonMember(const char *obj, size_t n, const char *key, Slice &out)
{
    MemberFind m{key, strlen(key), {}, false};
    forEachObjMember(obj, n, &m, memberFindCb);
    if (m.found)
        out = m.out;
    return m.found;
}

bool jsonForEachMember(Slice obj, void *ctx, bool (*cb)(void *, Slice, Slice))
{
    return forEachObjMember(obj.p, obj.n, ctx, cb);
}

bool jsonForEachArray(Slice arr, void *ctx, bool (*cb)(void *, Slice))
{
    const char *p = arr.p, *end = arr.p + arr.n;
    p = skipWs(p, end);
    if (p >= end || *p != '[')
        return false;
    ++p;
    while (p < end) {
        p = skipWs(p, end);
        if (p < end && *p == ']')
            return true;
        const char *vs = p, *ve = skipValue(p, end);
        Slice el{vs, (size_t)(ve - vs)};
        if (!cb(ctx, el))
            return true;
        p = skipWs(ve, end);
        if (p < end && *p == ',')
            ++p;
    }
    return true;
}

bool jsonInt(Slice obj, const char *key, int64_t &out)
{
    Slice v;
    if (!jsonMember(obj.p, obj.n, key, v) || v.n == 0)
        return false;
    out = strtoll(v.p, nullptr, 10);
    return true;
}

bool jsonStr(Slice obj, const char *key, char *out, size_t cap)
{
    Slice v;
    if (!jsonMember(obj.p, obj.n, key, v) || v.n < 2 || v.p[0] != '"')
        return false;
    size_t o = 0;
    for (size_t i = 1; i + 1 < v.n && o + 1 < cap; ++i) {
        char c = v.p[i];
        if (c == '\\' && i + 2 < v.n)
            c = v.p[++i];
        out[o++] = c;
    }
    out[o] = 0;
    return true;
}

// ── Multi-client envelope ───────────────────────────────────────────────────

bool envelopeForEachClient(const char *json, size_t n, void *ctx, bool (*cb)(void *, Slice))
{
    Slice clients;
    if (!jsonMember(json, n, "clients", clients))
        return false;
    return jsonForEachArray(clients, ctx, cb);
}

struct ValCtx {
    char *err;
    size_t cap;
    bool ok;
};
static void setErr(ValCtx *v, const char *m)
{
    v->ok = false;
    if (v->cap) {
        strncpy(v->err, m, v->cap - 1);
        v->err[v->cap - 1] = 0;
    }
}
static bool valClientCb(void *c, Slice cl)
{
    auto *v = (ValCtx *)c;
    char buf[64];
    if (!jsonStr(cl, "id", buf, sizeof buf) || buf[0] == 0) {
        setErr(v, "client missing id");
        return false;
    }
    if (!jsonStr(cl, "gateway", buf, sizeof buf) || buf[0] == 0) {
        setErr(v, "client missing gateway");
        return false;
    }
    Slice canal;
    char psk[64];
    if (!jsonMember(cl.p, cl.n, "canal", canal) || !jsonStr(canal, "psk_b64", psk, sizeof psk)) {
        setErr(v, "client missing psk_b64");
        return false;
    }
    uint8_t raw[48];
    if (base64Decode(psk, strlen(psk), raw, sizeof raw) < 0) {
        setErr(v, "invalid psk_b64");
        return false;
    }
    return true;
}

bool validateEnvelope(const char *json, size_t n, char *err, size_t errCap)
{
    if (errCap)
        err[0] = 0;
    char fmt[24];
    Slice root{json, n};
    if (!jsonStr(root, "fmt", fmt, sizeof fmt) || strcmp(fmt, "irrig-vault") != 0) {
        if (errCap)
            strncpy(err, "bad fmt", errCap - 1);
        return false;
    }
    int64_t ver = 0;
    if (!jsonInt(root, "version", ver) || ver != 1) {
        if (errCap)
            strncpy(err, "bad version", errCap - 1);
        return false;
    }
    ValCtx v{err, errCap, true};
    if (!envelopeForEachClient(json, n, &v, valClientCb)) {
        if (v.ok && errCap)
            strncpy(err, "missing clients[]", errCap - 1);
        return false;
    }
    return v.ok;
}

// ── Light profile extraction ────────────────────────────────────────────────

static const char *kPresets[] = {"LONG_FAST",  "LONG_SLOW",  "VERY_LONG_SLOW", "MEDIUM_SLOW",
                                 "MEDIUM_FAST", "SHORT_SLOW", "SHORT_FAST",     "LONG_MODERATE"};
uint8_t presetFromString(const char *s)
{
    for (uint8_t i = 0; i < 8; i++)
        if (strcmp(s, kPresets[i]) == 0)
            return i;
    return 0;
}
const char *presetToString(uint8_t p) { return (p < 8) ? kPresets[p] : kPresets[0]; }

uint32_t parseNodeHex(const char *s)
{
    if (*s == '!')
        ++s;
    return (uint32_t)strtoul(s, nullptr, 16);
}

struct EstCtx {
    LightProfile *p;
};
static bool estCb(void *c, Slice el)
{
    auto *e = (EstCtx *)c;
    LightProfile *p = e->p;
    if (p->estacaoCount >= 16)
        return false;
    LightStation &st = p->estacoes[p->estacaoCount];
    char no[16];
    if (jsonStr(el, "no", no, sizeof no))
        st.node = parseNodeHex(no);
    jsonStr(el, "nome", st.name, sizeof st.name);
    int64_t v;
    st.lat = jsonInt(el, "lat", v) ? (int32_t)v : 0;
    st.lon = jsonInt(el, "lon", v) ? (int32_t)v : 0;
    p->estacaoCount++;
    return true;
}

bool extractLight(Slice client, LightProfile &out)
{
    out = LightProfile{};
    if (!jsonStr(client, "id", out.id, sizeof out.id) || out.id[0] == 0)
        return false;
    jsonStr(client, "nome", out.nome, sizeof out.nome);
    char gw[16];
    if (jsonStr(client, "gateway", gw, sizeof gw))
        out.gateway = parseNodeHex(gw);
    Slice canal;
    if (jsonMember(client.p, client.n, "canal", canal)) {
        jsonStr(canal, "nome", out.canalNome, sizeof out.canalNome);
        jsonStr(canal, "psk_b64", out.pskB64, sizeof out.pskB64);
        char pre[24];
        if (jsonStr(canal, "modem_preset", pre, sizeof pre))
            out.preset = presetFromString(pre);
    }
    Slice est;
    if (jsonMember(client.p, client.n, "estacoes", est)) {
        EstCtx c{&out};
        jsonForEachArray(est, &c, estCb);
    }
    return true;
}

// ── §5.5 client backup assembly ─────────────────────────────────────────────

size_t buildClientBackup(const BackupSource &s, char *buf, size_t cap)
{
    IrrigationWeb::JsonWriter w(buf, cap);
    char gw[12];
    snprintf(gw, sizeof gw, "!%08x", s.gateway);
    w.beginObject();
    w.keyStr("id", s.id);
    w.keyStr("nome", s.nome ? s.nome : "");
    w.key("canal");
    w.beginObject();
    w.keyStr("nome", s.canalNome ? s.canalNome : "");
    w.keyStr("psk_b64", s.pskB64 ? s.pskB64 : "");
    w.keyStr("modem_preset", presetToString(s.preset));
    w.endObject();
    w.keyStr("gateway", gw);
    w.key("estacoes");
    w.raw(s.estacoesJson ? s.estacoesJson : "[]");
    w.key("snapshot_epoch");
    w.raw(s.snapshotEpochJson ? s.snapshotEpochJson : "{}");
    if (s.seqJson && s.seqJson[0]) {
        w.key("seq");
        w.raw(s.seqJson);
    }
    w.key("config");
    w.beginObject();
    w.key("zonas");
    w.raw(s.zonasJson ? s.zonasJson : "[]");
    w.key("programas");
    w.raw(s.programasJson ? s.programasJson : "[]");
    w.key("intertravamentos");
    w.raw(s.intertravamentosJson ? s.intertravamentosJson : "[]");
    w.key("grupos");
    w.raw(s.gruposJson ? s.gruposJson : "[]");
    w.key("sensorNames");
    w.raw(s.sensorNamesJson ? s.sensorNamesJson : "[]");
    w.key("niveis");
    w.raw(s.niveisJson ? s.niveisJson : "[]");
    w.key("remoteButtons");
    w.raw(s.remoteButtonsJson ? s.remoteButtonsJson : "[]");
    w.endObject();
    w.endObject();
    return w.done();
}

bool planMerge(const char *const *existingIds, size_t nExisting, const char *const *incomingIds,
               size_t nIncoming, bool replace, void *ctx, void (*removeCb)(void *, const char *))
{
    if (!replace)
        return true;
    for (size_t i = 0; i < nExisting; i++) {
        bool keep = false;
        for (size_t j = 0; j < nIncoming; j++)
            if (strcmp(existingIds[i], incomingIds[j]) == 0) {
                keep = true;
                break;
            }
        if (!keep)
            removeCb(ctx, existingIds[i]);
    }
    return true;
}

} // namespace IrrigationService
