jeffersonpimenta/firmware/(commit log)

2026-07-09 get sensor and NMEA data from indicator. Will test tomorrow, don't merge yet.
2026-07-10 indicator: switch to new interdevice protocol
    Remove FakeI2C tunneling, bump protobufs submodule and regenerate
    interdevice bindings, power the sensor rail via IO expander on boot.
    [main.cpp]
2026-07-11 feat(irrigation): add binary application protocol codec
    Implements IrrigationProto namespace with encoders/decoders for CmdValvula,
    CmdGpo, Ack, and Heartbeat messages. Pure-logic binary protocol codec with
    little-endian serialization and no hardware dependencies.
2026-07-11 fix(irrigation): give test setup/loop C linkage via Arduino.h include
    Portduino's main expects extern "C" setup/loop; pure-logic suites must
    pull the declarations from Arduino.h like the other test suites do.
    [test_main.cpp]
2026-07-11 feat(irrigation): add fail-safe valve controller with local timer
    Implements ValveController with fail-safe timers (120-min ceiling),
    battery lockout, timer renewal without re-pulsing, and millisecond
    rollover handling. All 9 unit tests pass.
    [ValveController.cpp, ValveController.h, test_main.cpp]
2026-07-11 feat(irrigation): add persisted role/pin-map settings with staged write
    Implements IrrigationSettings struct with atomic file I/O, staging write pattern to prevent corruption on power loss, and IrrigationRole enum (ESTACAO, GATEWAY, REPETIDOR, SERVICO). Provides loadIrrigationSettings() and saveIrrigationSettings() functions for persistence layer as spec §5.1/§5.3. Minimal Layer 1 implementation; Phase 2 adds sensors and NVS epoch tracking.
    [IrrigationSettings.cpp, IrrigationSettings.h]
2026-07-11 fix(irrigation): remove orphaned tmp file when settings rename fails
    [IrrigationSettings.cpp]
2026-07-11 feat(irrigation): add station module with fail-safe valve command handling
    Implements IrrigationModule (SinglePortModule + OSThread) on
    meshtastic_PortNum_PRIVATE_APP: anti-replay via SeqTable, rate-limit via
    RateLimiter, battery lockout via ValveController, heartbeat via Throttle.
    GpioValveDriver provides latching H-bridge pulses (no-op under ARCH_PORTDUINO).
    Registers irrigationModule in setupModules() guarded by
    !MESHTASTIC_EXCLUDE_IRRIGATION. Updates native-suite-count 31→34.
    [IrrigationModule.cpp, IrrigationModule.h]
2026-07-11 fix(irrigation): register module before RoutingModule and drop double battery read
    RoutingModule must stay the last registered module (it deduplicates acks
    from earlier modules' replies).
    [IrrigationModule.cpp]
2026-07-11 fix(irrigation): force-close valves at boot and harden fail-safe paths
    Latching solenoids retain state across MCU resets. If a reset occurred
    mid-irrigation, the ValveController's internal open=false slots would
    prevent closeAll() from pulsing the close coil, leaving the solenoid
    physically open indefinitely.
    - Add forceCloseAll(): unconditionally pulses close on every valve slot
    regardless of internal open bit, then clears all state. Used at boot
    in IrrigationModule constructor (replaces closeAll call).
    - Move valves.tick() before the role early-return in runOnce() so the
    fail-safe timer runs on every role; a misconfigured node can never
    leave an open valve without a running countd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
    [IrrigationModule.cpp, ValveController.cpp, ValveController.h, test_main.cpp]
2026-07-11 chore(irrigation): lock settings ABI, clamp pulse width, cleanup
    Add static_assert(sizeof(IrrigationSettings) == 40) to lock the on-disk
    binary format; any struct layout change (field add/remove/reorder) will
    now fail at compile time, requiring an explicit version bump and assert
    update.
    Note: pulseMs ≤1000 clamp in loadIrrigationSettingsOrDefault, packetPool
    release guards in sendAck/sendHeartbeat, static linkage for loader helper,
    explicit string.h include, seqTable comment, and stray .superpowers removal
    were applied in the preceding safety-fix commit to keep IrrigationModule.cpp
    changes atomic.
    [IrrigationSettings.h]
2026-07-11 feat(irrigation): add config transfer codec with crc32 and new nack reasons
    Implements Phase 2 Task 1: adds crc32 function, SetConfig struct and codec (encodeSetConfig/decodeSetConfig), encodeGetConfig function, new NackReason enum values (7-11), FRAG_DATA_MAX constant, and 5 new tests plus missing asserts in existing tests.
    [IrrigationProtocol.cpp, IrrigationProtocol.h, test_main.cpp]
2026-07-11 feat(irrigation): version settings format to v2 with epoch and digital-input polarity
    Upgrade IrrigationSettings struct from v1 (40 B) to v2 (52 B) adding:
    - configEpoch (uint32_t) for timestamp tracking per spec §5.4
    - pinsDigitalIn[4] (int8_t array) for digital input pin configuration
    - digitalInActiveLow (uint8_t bitmask) for configurable polarity
    Implement pure migrateIrrigationSettings function that:
    - Accepts both v1 and v2 formats (validates magic + version + size)
    - Copies v1 to v2 with defaults for new fields
    - Rejects invalid input (bad magic, version, size)
    Update loadIrrigationSettings to delegate to migrate and re-save v1→v2 migrations.
    Add test suite with 4 tests validatin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
2026-07-11 fix(irrigation): cover geometric fragment rejection and harden reassembler reset
    [FragmentReassembler.cpp, test_main.cpp]
2026-07-11 feat(irrigation): allow runtime valve-count reconfiguration with safe pulses
2026-07-12 fix(irrigation): revert in-memory epoch when config commit fails
    A failed save must not leave heartbeats announcing an epoch that never
    reached flash — the gateway would stop retrying the config push.
    [IrrigationModule.cpp]
2026-07-12 fix(irrigation): close valves on old pin map and persist before activating config
    Previously, applySettings() swapped the pin map while valves might still be
    physically open: subsequent close pulses would fire on the NEW pins, leaving
    the old solenoid stranded open (H-bridge latching, no self-reset). Also, config
    was applied to RAM before the save call; on save failure the device ran a config
    the gateway was told had failed, breaking the ACK⇔persisted⇔active invariant.
    Replace applySettings with mergeRemoteConfig (pure, builds sanitised merged
    struct including identity fields and limit clamps) and activateSettings (calls
    forceCloseAll on OLD pin map FIRST, then swaps settings and reconf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
    [IrrigationModule.cpp, IrrigationModule.h]
2026-07-12 fix(irrigation): make settings padding explicit and deterministic
    IrrigationSettings had 6 implicit padding bytes (offsets 19, 38-39, 49-51)
    that leaked uninitialized RAM to flash and radio, making CRC32 of the blob
    nondeterministic across boots and compilers.
    Replace all implicit padding with explicitly named, zero-initialized members
    (pad0, pad1[2], pad2[3]) without changing any field offset or the total size
    of 52 bytes. Update the layout comment to document every byte. static_assert
    on size 52 is preserved.
    Add test_defaultStruct_bytesDeterministic to test_irrigation_config: constructs
    two IrrigationSettings instances over different uninitialized memory (0xAA vs
    0x55), then asserts all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
    [IrrigationSettings.h, test_main.cpp]
2026-07-12 docs(irrigation): phase 3 plan with pairing, factory reset, button/led and farm-key export
2026-07-12 fix(irrigation): stop decoding pair grant early on short buffer
    [IrrigationProtocol.cpp]
2026-07-12 feat(irrigation): settings v3 with button and led pins
    Adds v3 migration: pinBtn and pinLed fields (offsets 49-50, default -1)
    replace pad2[3]. Version bumped to 3. Struct size unchanged at 52 bytes.
    v1/v2 blobs get default -1 on migration; v3 passes through unchanged.
    Load re-saves on version upgrade (v1/v2→v3). Test suite: 8 tests
    (5 adjusted for v3, 3 new button/led pin migrations).
    [IrrigationSettings.cpp, IrrigationSettings.h, test_main.cpp]
2026-07-12 feat(irrigation): add button gesture detector and led pattern table
    Pure logic modules for UI control: ButtonGestureDetector debounces button
    input and emits SHORT/DOUBLE/LONG_3S/HOLD_10S events; LedPatternController
    generates 6 mode-specific LED patterns from time. All 8 unit tests pass.
    Branch-order decision: Both LONG and HOLD fire independently via reset of
    longFired flag - LONG fires at 3s, then HOLD at 10s on same press. Fixed
    DOUBLE press to prevent spurious SHORT: added doubleDetected flag.
    [ButtonGesture.cpp, ButtonGesture.h, LedPattern.cpp, LedPattern.h, test_main.cpp]
2026-07-12 fix(irrigation): make double-press flag handling symmetric in gesture detector
    [ButtonGesture.cpp]
2026-07-12 fix(irrigation): harden gateway pairing cooldown slots
    - Reject nodeId 0 in approveAnnounce (invalid broadcast address)
    - Clear cooldown slots when window reopens
    - Increase cooldown buffer from 4 to 8 slots
    [Pairing.cpp, Pairing.h]
2026-07-12 feat(irrigation): pairing flow, factory reset, button gestures and status led
    Physical pairing: factory node button opens a 2-min announce window; the
    gateway button opens a matching accept window (anticipates the phase 5
    panel approval). PAIR_GRANT carries the farm PSK; the station writes it
    to the primary channel, persists the gateway bind atomically and reboots.
    Also: 10-s button factory reset, multifunction gestures (manual valve,
    test pulse), single-table status LED at 25 ms UI thread, and farm-key
    export to serial via long press on the gateway.
    [IrrigationModule.cpp, IrrigationModule.h]
2026-07-12 fix(irrigation): persist channel psk to disk before pairing reboot
    Power loss between the settings save and the reboot must not leave the
    station bound to the gateway while its channel still has the factory PSK.
    [IrrigationModule.cpp]
2026-07-12 fix(irrigation): close valves and preserve pins on factory reset; grant on announce channel
    Two field-blocking defects from the phase review: (1) factory reset wiped
    the pin map before anything closed the latching valves — an open valve
    would stay open forever with no local timer; now valves force-close on
    the old map and hardware pins survive the wipe (role and pins are
    physical reality, not credentials). (2) PAIR_GRANT went out on the
    farm-keyed primary channel, which a factory station cannot decrypt; it
    now replies on the channel the announce arrived on. Also: pairing commit
    failure is retryable without power-cycle, and a full allowlist refuses
    the grant instead of silently dropping the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
    [IrrigationModule.cpp, Pairing.cpp, Pairing.h, test_main.cpp]
2026-07-12 fix(irrigation): guard adoptConfig against null blob
    [GatewayTables.cpp]
2026-07-12 fix(irrigation): abort active program on hot upsert and reject empty programs
    [ProgramScheduler.cpp]
2026-07-12 feat(irrigation): add command ack tracker with retries
    Implements CommandTracker for managing outgoing commands awaiting ACK
    with automatic retry logic. Tracks up to 8 pending commands with
    unsigned-subtraction based timeout detection (8s). On timeout, RESEND
    is returned with attemptsLeft-1, or FAILED if no attempts remain.
    [CommandTracker.cpp, CommandTracker.h, test_main.cpp]
2026-07-12 fix(irrigation): clamp zero attempts and surface retrack failure
    Prevents phantom FAILED timeouts from zero attempts; surfaces retrack slot
    exhaustion failure (silent loss would hide safety command loss).
    [CommandTracker.cpp, CommandTracker.h]
2026-07-12 feat(irrigation): add station health monitor and alert ring
    Implements StationMonitor with battery hysteresis logic, silence detection,
    and reboot anomaly tracking. Adds AlertCenter as a ring buffer for recent
    alerts. Supports per-station state tracking for battery levels (normal,
    aviso, critico, hibernacao) with asymmetric hysteresis: immediate down
    transitions and recovery-path up transitions requiring hysteresis threshold.
    [StationMonitor.cpp, StationMonitor.h, test_main.cpp]
2026-07-12 fix(irrigation): emit battery level alert on first downward transition
    [StationMonitor.cpp]
2026-07-12 fix(irrigation): triple-alert buffer, zero-baseline reboot detection and monitor hardening
    The out-parameter could receive three alerts on one heartbeat (silence
    recovery + battery drop + reboot anomaly) overflowing Alert[2]; and a
    freshly flashed station reporting rebootCount 0 re-baselined every
    heartbeat, permanently blinding anomaly detection.
    [StationMonitor.cpp, StationMonitor.h, test_main.cpp]
2026-07-12 feat(irrigation): add 24vac mirror mode engine with renewal and bypass state
    Implements MirrorMode class with 100ms debounce, rising edge OPEN,
    falling edge CLOSE, 60s renewal while active, and disable-drain logic.
    Includes serialization and per-input state tracking for independent
    input handling. All 6 tests pass: rise/fall edges, renewals, glitch
    debounce, drain on disable, multi-input independence, serialization.
    [MirrorMode.cpp, MirrorMode.h, test_main.cpp]
2026-07-12 fix(irrigation): debounce mirror inputs before emitting actions
    [MirrorMode.cpp]
2026-07-12 fix(irrigation): report mirror inputs inactive while mode disabled
    [MirrorMode.cpp]
2026-07-12 feat(irrigation): gateway engine - scheduler, retries, epoch reconciliation, alerts and mirror mode
    - Add IrrigationGateway aggregate (zones, stations, scheduler, tracker,
    monitor, alerts, mirror) as public struct; logic lives in module (decision §1).
    - Wire gwTick() called 1×/s in GATEWAY runOnce branch: scheduler tick with
    RTC-optional guard (LOG_WARN 1×/h when no RTC), mirror GPIO read with
    configurable polarity, tracker retry/fail loop, per-station silence check.
    - Scheduler: clamps durationS by zone.maxMin; suppresses OPEN when mirror is
    active on same fonteInput (bypass decision §2).
    - Mirror: bypass total (no clamp); gwSendValveCmd encodes CmdValvula or CmdGpo
    by zone.ti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
    [Allowlist.h, IrrigationGateway.h, IrrigationModule.cpp, IrrigationModule.h]
2026-07-12 fix(irrigation): guard config push, alert on resend encode failure, node-keyed cooldowns
    [IrrigationModule.cpp, IrrigationModule.h]
2026-07-15 docs(irrigation): phase 5a gateway web panel design spec
    Slice phase 5 to 5a (gateway panel §7.1) only; node captive portal §7.2
    becomes 5b. Reuse Meshtastic esp32_https_server/ContentHandler + LittleFS
    static serving; add /api/irrigation/* nodes gated on GATEWAY role. Pure
    IrrigationWebApi (JSON serialize/parse via ArduinoJson, host-tested) vs
    ESP32-only HTTP glue. Frontend from Irrigacao Mobile.dc.html mockup for
    overview/stations/zones/programs; interlocks+log (F6), system/PIN (F8)
    deferred. Folds 3 phase-4 final-review carryover Importants as pre-tasks.
2026-07-15 docs(irrigation): phase 5a implementation plan + spec json correction
    13-task plan: F4 carryover fixes (scheduler CLOSE mirror-suppression,
    StationRegistry::nodeAt, settings/blob static_assert); pure IrrigationWebApi
    (hand-rolled JSON writer/reader, serializers, validating parsers, native
    tested); StationTelemetryCache; module gateway-service methods; ESP32-only
    HTTP endpoints; LittleFS panel frontend (overview/stations/zones/programs).
    Spec corrected: hand-rolled JSON (repo has no ArduinoJson; jsoncpp not
    native-safe) instead of ArduinoJson.
2026-07-16 fix(irrigation): suppress scheduler CLOSE when mirror owns the zone (F4 carryover)
    [IrrigationModule.cpp, MirrorMode.cpp, MirrorMode.h, test_main.cpp]
2026-07-16 feat(irrigation): webapi pure layer — json writer, computeSync, buildOverview
2026-07-16 fix(irrigation): JsonWriter scalar-array separators (str/num/boolean) + escaping/comma tests
    Code-review follow-up: str/num/boolean now emit sep_() like raw(), so scalar
    arrays (e.g. the error-list response in the HTTP layer) get valid commas.
    Safe for key-value output because key() zeroes _needComma before the value.
    [IrrigationWebApi.cpp, test_main.cpp]
2026-07-16 fix(irrigation): make JsonReader honor _len (bounded reads at untrusted-input boundary)
    [IrrigationWebApi.cpp, test_main.cpp]
2026-07-16 fix(irrigation): correct gateway APPROVE_PAIRING + program-delete abort scope
    Code-review follow-ups on the gateway web-service methods:
    - APPROVE_PAIRING now opens the gateway accept window (gatewayPairing.openWindow +
    refreshLedMode), mirroring the SHORT-press gesture. Previously called the
    station-side commitPairing() which writes a PSK and reboots the gateway.
    - gwApplyProgramDelete only closes the running zone when the DELETED program is the
    one running (removeById already aborts internally); deleting an idle program no
    longer disturbs another program in progress. Adds ProgramScheduler::runningProgramId().
    - Note manual web OPEN intentionally bypasses mirror suppression (operato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
    [IrrigationModule.cpp, ProgramScheduler.h]
2026-07-16 feat(irrigation): http endpoints /api/irrigation/* (gateway-gated, esp32-only)
2026-07-16 build(native): exclude IrrigationWebEndpoints.cpp from portduino src filter
    The ESP32-only HTTP glue includes <HTTPServer.hpp> (esp32_https_server). Native
    excludes the web stack via build_src_filter (-<mesh/http/>), not the
    MESHTASTIC_EXCLUDE_WEBSERVER macro, which is undefined on native — so the guard
    alone left the file compiling and failing on the missing header. Filter it out
    like mesh/http; the macro guard remains for wifi-less ESP32 variants.
2026-07-16 fix(irrigation): size web-endpoint response buffers to table maxima + check build* truncation
    [IrrigationWebEndpoints.cpp]
2026-07-17 docs(irrigation): phase 5b captive portal design spec
    Field captive portal (§7.2): button-raised AP + captive DNS, three tabs
    (Este nó / Rede / Instalador). Mirrors 5a's 3-layer split — pure
    host-tested core (PortalSession SM, PortalApi, LinkStat, new codecs) →
    CI-gated ESP32 glue (PortalAp, IrrigationPortalEndpoints) → static
    LittleFS frontend. Rede relays through gateway via new MSG_REMOTE_CMD;
    Instalador echo reuses ACK.
2026-07-17 docs(irrigation): phase 5b implementation plan
    12-task TDD plan across two milestones (AP shell + Este nó; Rede relay).
    Defers local config-write (coords need ABI v4) to a follow-up and aligns
    the spec's endpoint table accordingly.
2026-07-17 feat(irrigation): portal AP lifecycle state machine
    Pure host-tested timer: button raises AP for 10 min; client presence
    renews; idle timeout closes. Phase 5b Marco 1 Task 1. Suite count 44->45.
2026-07-17 docs(irrigation): clarify portal valveId is 0-based physical index
2026-07-17 feat(irrigation): module portal node-state + local pulse service
    Add portalFillNodeState(), portalPulse(), and portalSession() to IrrigationModule
    (public, role-agnostic). Include PortalSession.h in the header and PortalApi.h
    in the .cpp so the portal glue endpoints can call through without coupling the
    header to the full portal type definitions.
2026-07-17 fix(plan): guard portal AP hook with ARCH_ESP32 to avoid native link error
    The runOnce caller compiles on native (ARCH_PORTDUINO), where
    MESHTASTIC_EXCLUDE_WEBSERVER is undefined; only ARCH_ESP32 in the guard
    keeps the call and the src-filtered PortalAp.cpp from mismatching.
2026-07-17 feat(irrigation): portal Wi-Fi AP + captive DNS glue (ESP32)
    Adds PortalAp.h/.cpp: softAP (WPA2) + DNSServer captive portal loop
    driven by PortalSession::apShouldBeUp(). Guarded with
    `#if defined(ARCH_ESP32) && !MESHTASTIC_EXCLUDE_WEBSERVER` throughout,
    matching the WebServerThread guard in main.cpp:1134. portduino.ini
    src_filter excludes PortalAp.cpp on native; IrrigationModule::runOnce
    calls portalApLoop(millis()) under the same guard. Native build: exit 3
    FILTERED, 5/5 passed, no link/compile errors.
    [IrrigationModule.cpp, PortalAp.cpp, PortalAp.h]
2026-07-17 feat(irrigation): portal /api/portal/node endpoints (ESP32)
    Registers GET /api/portal/node and POST /api/portal/node/pulse on both
    secureServer and insecureServer via registerIrrigationPortalHandlers(),
    mirroring the IrrigationWebEndpoints idiom exactly. IrrigationPortalEndpoints.cpp
    is excluded from the native (portduino) src_filter; the #if guard matches
    ContentHandler.cpp (MESHTASTIC_EXCLUDE_WEBSERVER), consistent with 5a.
2026-07-17 feat(irrigation): button short-press raises captive portal
    [IrrigationModule.cpp]
2026-07-17 feat(irrigation): MSG_REMOTE_CMD protocol codec
    Add MSG_REMOTE_CMD = 12 to MsgType enum, RemoteCmd struct
    (zoneId/action/durationS), encodeRemoteCmd/decodeRemoteCmd
    little-endian codec, and two TDD round-trip tests to the
    existing test_irrigation_protocol suite.
2026-07-17 feat(irrigation): remote-command TX + gateway relay handler
    - Add portalRunNetCommand(): on gateway applies locally via gwSendValveCmd;
    on field node encodes MSG_REMOTE_CMD and forwards to boundGateway over radio.
    - Add handleRemoteCmd(): gateway-side handler — anti-replay (seqTable),
    rate-limit, decode, dispatch via portalRunNetCommand, ACK back to sender.
    - Wire MSG_REMOTE_CMD case in handleReceived() switch; non-gateway nodes
    log and ignore.
    - Forward-declare IrrigationWeb::NetCommand in IrrigationModule.h and expose
    portalRunNetCommand() as a public method.
2026-07-17 fix(irrigation): enforce safeMode + reject unknown action in remote-command relay
    portalRunNetCommand issued a valve-open on the gateway without the
    safeMode interlock that handleCmdValvula enforces, and silently treated
    any action != 1 as CLOSE (returning ACK_OK). Add a safeMode guard on the
    open path and reject unknown action codes. Found in code review.
    [IrrigationModule.cpp]
2026-07-17 feat(irrigation): portal /api/portal/net endpoints (ESP32)
2026-07-20 docs(irrigation): fase 6a design spec (sensores, GPO, tamper, mini-log)
2026-07-20 feat(irrigation): settings ABI v4 (sensores, GPO, tamper, coords)
2026-07-20 test(irrigation): fix review nits + pino de offsets ABI v4
    [IrrigationSettings.h, test_main.cpp]
2026-07-20 feat(irrigation): heartbeat sensor block + EV_TAMPER
2026-07-20 test(irrigation): heartbeat sensor block truncado mid-entry rejeitado
2026-07-20 feat(irrigation): SensorSampler (calibração, debounce, HB antecipado)
2026-07-20 fix(irrigation): HB antecipado por condição viva (não latch) no SensorSampler
    [SensorSampler.cpp, SensorSampler.h, test_main.cpp]
2026-07-20 feat(irrigation): GpoController (biestável + temporizado fail-safe)
    [GpoController.cpp, GpoController.h, test_main.cpp]
2026-07-20 fix(irrigation): GpoController força slots novos desligados no grow
    [GpoController.cpp, test_main.cpp]
2026-07-20 fix(irrigation): GpoController não re-aciona driver em re-emissão (renova timer)
    [GpoController.cpp, test_main.cpp]
2026-07-20 fix(irrigation): AuditLog clampa count u16 na serialização + docs
    [AuditLog.cpp, AuditLog.h]
2026-07-20 feat(irrigation): GPO fim-a-fim na estação (MSG_CMD_GPO + estado real)
    - IrrigationModule.h: inclui GpoController.h; adiciona GpioGpoDriver
    (IGpoDriver GPIO) e membros gpoDriver/gpos (GpoController init=0);
    declara handleCmdGpo ao lado de handleCmdValvula.
    - .cpp: GpioGpoDriver::configure (copia pinsGpo, pinMode/digitalWrite
    LOW, guard ARCH_PORTDUINO) e ::set (guard index/pin, HIGH/LOW).
    - static countGpos: conta pinsGpo[i] >= 0.
    - Constructor + activateSettings: gpoDriver.configure + gpos.setNumGpos.
    - handleReceived: case MSG_CMD_GPO -> handleCmdGpo.
    - handleCmdGpo: espelho exato de handleCmdValvula (auth/replay/rate/
    decode/safeMode/command/INVALID_ID/ACK).
    - sendAck + sendHeart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
2026-07-20 fix(irrigation): GPOs desligam nos pinos antigos antes da troca de pin map
    [IrrigationModule.cpp]
2026-07-20 feat(irrigation): sampler + tamper na estação (HB antecipado, EV_TAMPER)
2026-07-20 fix(irrigation): reseta debounce do tamper ao ativar config nova
    [IrrigationModule.cpp, IrrigationModule.h]
2026-07-20 feat(irrigation): auditoria plugada + persistência LittleFS
    §8.9: mini-log de auditoria (AuditLog, 100 registros, ring) integrado
    ao IrrigationModule com persistência staged-write em /prefs/irrigation_log.dat.
    Pontos de registro: REBOOT, SAFE_MODE_IN/OUT, CONFIG_EPOCH (handleSetConfig),
    PAREAR (commitPairing), ABRIR/FECHAR/PULSO (handleCmdValvula, handleCmdGpo,
    onButtonEvent, portalPulse, portalRunNetCommand), FAILSAFE_TIMER (valves e GPOs
    fechados automaticamente no runOnce), TAMPER (tickTamper, sempre auditado mesmo
    quando EVENTO suprimido pela janela do portal). Factory reset apaga o log.
    Flush com debounce de 60 s no runOnce (antes do branch de papel). Accessor
    público auditLogRef()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
    [IrrigationModule.cpp, IrrigationModule.h]
2026-07-20 fix(irrigation): audita NACKs precoces (CMD_REJEITADO) + nits de revisão
    [AuditLog.h, IrrigationModule.cpp]
2026-07-21 fix(irrigation): audita NACKs de SET_CONFIG + flush de boot + reset limpa dirty
    [IrrigationModule.cpp]
2026-07-21 feat(irrigation): PortalApi sensores/GPO/coords/mini-log
2026-07-21 test(irrigation): ordena mini-log por posição + nota de tamanho do buffer
2026-07-21 feat(irrigation): endpoints portal sensores/GPO/coords/log
2026-07-21 chore(irrigation): include cstdlib explícito no glue do portal
2026-07-21 feat(irrigation): portal Este nó — sensores, GPO, tamper, coords, mini-log
2026-07-21 docs(irrigation): marca ações de auditoria reservadas p/ fase futura
2026-07-22 docs(irrigation): design fase 6b — intertravamentos, fila, log flash, UI (gateway)
    Motor de intertravamentos global (gateway) + réplica local na estação
    (Settings ABI v5, push §5.4), fila de simultaneidade (gate de admissão +
    FIFO, cronograma sequencial), log de auditoria em flash ~256KB/~16k com
    export CSV/JSON, janela de manutenção do tamper via painel, nomes de
    sensor lado gateway, UI do painel. 6b inteira num plano, 4 marcos.
2026-07-22 docs(irrigation): plano fase 6b gateway — 20 tasks, 4 marcos, TDD
    Marco 1 núcleo puro (Settings v5, evalCondition, InterlockTable/Engine,
    evalLocalInterlocks, OpenGate). Marco 2 log flash + telemetria
    (FlashAuditRing + export CSV/JSON, SensorNameTable, cache de sensores).
    Marco 3 cola do gateway (tick, admissão+FIFO, push v5, CMD_MAINT,
    persistência). Marco 4 frontend. native-suite-count 49→54.
2026-07-22 feat(irrigation): Settings ABI v5 — réplica local de intertravamentos (fase 6b)
2026-07-22 fix(irrigation): adoptConfig migra p/ v5 canônico + corrige OOB de teste (fase 6b task 1 review)
    [GatewayTables.cpp, GatewayTables.h, IrrigationModule.cpp, test_main.cpp]
2026-07-22 feat(irrigation): InterlockTable — regras globais persistidas (fase 6b)
2026-07-22 fix(irrigation): guarda id!=0 em InterlockTable::removeById (fase 6b task 3 review)
    [InterlockTable.cpp]
2026-07-22 feat(irrigation): InterlockEngine — veredito global por zona (fase 6b)
2026-07-22 fix(irrigation): InterlockEngine indexa por slot físico + testes de latch/combinação (fase 6b task 4 review)
    [InterlockEngine.cpp, InterlockEngine.h, InterlockTable.cpp, InterlockTable.h, test_main.cpp]
2026-07-22 feat(irrigation): evalLocalInterlocks — réplica local sem rádio (fase 6b)
2026-07-22 feat(irrigation): OpenGate — admissão de simultaneidade + FIFO (fase 6b)
2026-07-22 feat(irrigation): FlashAuditRing — log circular em flash (fase 6b)
2026-07-22 feat(irrigation): export CSV/JSON do log de auditoria (fase 6b)
2026-07-22 test(irrigation): endurece FlashAuditRing — guards + cobertura de faixa/trunc/crc (fase 6b task 7-8 review)
2026-07-22 feat(irrigation): SensorNameTable — nomes de sensor no gateway (fase 6b)
2026-07-22 feat(irrigation): telemetria guarda sensores + tamper do heartbeat (fase 6b)
2026-07-22 feat(irrigation): gateway decodifica sensores + tamper do heartbeat (fase 6b)
2026-07-22 feat(irrigation): fila de simultaneidade no cronograma + bloqueio manual por intertravamento (fase 6b)
2026-07-23 fix(irrigation): manual/portal CLOSE libera slot do OpenGate + audita descarte na fila (fase 6b task 13 review)
    [IrrigationModule.cpp]
2026-07-23 feat(irrigation): CMD_MAINT — janela de manutenção do tamper (fase 6b)
2026-07-23 feat(irrigation): log de auditoria persistente em flash no gateway (fase 6b)
    Implementa Task 16: LittleFsByteStore (IByteStore sobre arquivo LittleFS
    de tamanho fixo com seek aleatório) e conecta FlashAuditRing ao gateway.
    - LittleFsByteStore.h/.cpp: abre/fecha o arquivo por operação ("r+" para
    seek+leitura/escrita); ensureAllocated() pré-preenche com zeros em blocos
    de 256 B; guarda com #ifdef FSCom (mesma convenção de saveGatewayState).
    - IrrigationModule: auditFlashStore{"/prefs/irrigation_audit.dat", 262160}
    + auditFlash{auditFlashStore}; inicializados em gateway init logo após
    loadInterlocks(); auditEvent() adiciona auditFlash.append(r) quando role
    == GATEWAY sem tocar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
    [IrrigationModule.cpp, IrrigationModule.h, LittleFsByteStore.cpp, LittleFsByteStore.h]
2026-07-23 feat(irrigation): web builders/parsers de intertravamentos/sensores/maint/nomes (fase 6b)
2026-07-23 test(irrigation): guarda de zonas>8, zonas ausente, minutes=1440 (fase 6b task 17 review)
2026-07-23 feat(irrigation): endpoints de intertravamentos/sensores/log/maint (fase 6b, Task 18)
    Wires SensorNameTable into IrrigationGateway; adds load/save persistence
    (staged-write, mirrors loadInterlocks/saveInterlocks exactly). Adds 7 new
    panel HTTP routes (CI-only, #if ARCH_ESP32/!EXCLUDE_WEBSERVER): GET/POST
    /api/irrigation/interlocks, POST …/interlocks/delete, GET …/sensors, POST
    …/sensors/name, GET …/audit (?fmt=csv|json&n=N), POST …/maint. Native
    suite 40/40 GREEN (routes are #if'd out; Step 1 glue compiles natively).
2026-07-23 feat(irrigation): UI do painel — sensores/GPO/intertravamentos/log/tamper/nomes (fase 6b)
    Adiciona as 5 abas do gateway (Task 19), consumindo os endpoints/JSON da Task 17/18:
    - Sensores: lista por estacao com valores ao vivo, tamper e edicao de nomes (/sensors, /sensors/name)
    - GPO: liga/desliga saidas tipo GPO com aviso de biestavel
    - Intertravamentos: CRUD de regras (/interlocks, /interlocks/delete)
    - Log: /audit json com filtros cliente (origem/acao/node) + export CSV/JSON
    - Tamper: abre/fecha janela de manutencao (/maint)
    Labels ORIGENS/ACOES/RESULTADOS e INTERLOCK_* espelham a ordem dos enums de
    AuditLog.h/InterlockEngine.h (contrato append-only).
    Correcoes de revisao aplicadas na p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
2026-07-24 docs(irrigation): design da Fase 7a — motor de grupos hidraulicos
    HydraulicGroupTable + HydraulicGroupEngine (maquina de estados guiada
    por ACK), matriz de falhas, unificacao com simultaneidade (8.10),
    integracao no gwTick, testes nativos. Sem mudanca na ABI de estacao
    (bomba = zona gpo). 7b cobre endpoints + UI.
2026-07-24 docs(irrigation): plano de implementacao da Fase 7a (grupos hidraulicos)
    10 tasks TDD: HydraulicGroupTable, HydraulicGroupEngine (maquina de
    estados guiada por ACK), matriz de falhas, bridging/max_partidas_hora,
    grupo-sem-bomba (simultaneidade), glue no gwTick + wiring ack/falha/
    heartbeat, registro de suites (56/56).
2026-07-24 feat(irrigation): HydraulicGroupTable — config + serializacao (fase 7a)
2026-07-24 test(irrigation): cobre CRC/tabela-cheia/groupAt + corrige comentario ENTRY (fase 7a task 1 review)
    [HydraulicGroupTable.cpp, test_main.cpp]
2026-07-24 feat(irrigation): HydraulicGroupEngine — nucleo + happy path min=1 (fase 7a)
2026-07-24 fix(irrigation): pump dur usa zona corrente + comenta invariantes do engine (fase 7a task 2 review)
    [HydraulicGroupEngine.cpp]
2026-07-24 feat(irrigation): engine — fechar_antes_de_abrir + minOpen>1 (fase 7a)
2026-07-24 refactor(irrigation): engine — pump dur = max zona confirmada + clareza START_WAIT (fase 7a task 3 review)
2026-07-24 feat(irrigation): engine — renovacao da bomba + deadline local (fase 7a)
2026-07-24 feat(irrigation): engine — matriz de falhas: abrir-proxima falha (fase 7a)
2026-07-24 refactor(irrigation): engine — fail-safe em resolve + comentarios de invariante (fase 7a task 5 review)
    [HydraulicGroupEngine.cpp, test_main.cpp]
2026-07-24 feat(irrigation): engine — close-fail + bridging + max_partidas_hora (fase 7a)
    [HydraulicGroupEngine.cpp, HydraulicGroupEngine.h, test_main.cpp]
2026-07-24 feat(irrigation): engine — grupo sem bomba + reconciliacao por heartbeat (fase 7a)
2026-07-24 feat(irrigation): agregado + persistencia de grupos + AuditOrigin (fase 7a)
2026-07-24 feat(irrigation): glue — roteamento gwTick + ack/falha/heartbeat dos grupos (fase 7a)
2026-07-24 fix(irrigation): grupos — nao trava grupo em falha de encode no dispatch (fase 7a task 9 review)
    [IrrigationModule.cpp]
2026-07-24 test(irrigation): registra suites de grupos hidraulicos (54->56, fase 7a)
2026-07-24 docs(irrigation): marca Fase 7a (motor de grupos) concluida no roadmap
2026-07-24 fix(irrigation): grupos — NACK como falha, interlock deveFechar via engine, pump-start-fail seguro, guarda reconcile (fase 7a review final)
    [HydraulicGroupEngine.cpp, HydraulicGroupEngine.h, IrrigationModule.cpp, test_main.cpp]
2026-07-24 feat(irrigation): grupo — getters currentZone/openConfirmedCount (fase 7b)
2026-07-24 feat(irrigation): grupo — parsers web (upsert/delete/command) (fase 7b)
2026-07-24 feat(irrigation): grupo — validacao semantica de zonas (espelho/existencia) (fase 7b)
2026-07-24 feat(irrigation): grupo — builders web (config + status ao vivo) (fase 7b)
2026-07-24 fix(irrigation): rotear open/close de zona de grupo pelo motor em todos os caminhos (fase 7b)
    [IrrigationModule.cpp, IrrigationModule.h]
2026-07-24 feat(irrigation): grupo — gwApplyGroupUpsert/Delete + gwRunGroupCommand (fase 7b)
2026-07-24 feat(irrigation): grupo — endpoints HTTP /groups[/status|/delete|/command] (fase 7b)
2026-07-24 feat(irrigation): grupo — aba Grupos no painel (CRUD + status ao vivo + comando) (fase 7b)
2026-07-25 docs(irrigation): marca Fase 7b (painel de grupos) concluida no roadmap
2026-07-25 fix(irrigation): grupo — review fixes (minOpen<=zonas, audit sem falso-abriu, front tidy, cobertura state label) (fase 7b)
    [IrrigationModule.cpp, IrrigationWebApi.cpp, test_main.cpp]
2026-07-25 docs(irrigation): design da Fase 8a (SERVICE_MAGIC + RESYNC_SEQ + PING_SURVEY responder)
    Primeiro recorte da Fase 8 (role SERVICO): pre-requisitos de protocolo
    que o parque instalado precisa antes do device de servico existir (spec
    §11.9). Aditivo, sem bump de VERSION, sem mudanca de ABI de settings.
    SeqTable fica RAM-only (posse-da-PSK=autoridade; replay-no-reboot nao
    concede poder novo).
2026-07-25 docs(irrigation): 8a design — teste realista (predicado puro extraido; glue via compile+hw)
    Nenhum teste nativo instancia IrrigationModule; corrige a secao de testes
    para o padrao do repo: senderAuthorizedBy() puro em IrrigationProtocol.h
    (testavel como SeqTable), codec native-tested, wiring do handler validado
    por compilacao nativa + hardware.
2026-07-25 docs(irrigation): plano de implementacao da Fase 8a (6 tasks TDD + glue)
2026-07-25 feat(irrigation): 8a codec — FLAG_FROM_SERVICE, senderAuthorizedBy, RESYNC_SEQ + PING_SURVEY
    Camada pura da Fase 8a (native-tested, sem bump de VERSION):
    - FLAG_FROM_SERVICE (0x0001) + setServiceFlag() (marca no offset 2 do header)
    - senderAuthorizedBy(flags,from,boundGateway) inline puro (SERVICE_MAGIC + vinculo)
    - codec RESYNC_SEQ (kind+lastSeq) e PING_SURVEY (nodeinfo minimo) + APP_FW_VERSION
    - 7 casos novos: test_irrigation_protocol (+4), test_irrigation_replay (+3), todos GREEN
2026-07-25 feat(irrigation): 8a glue — SERVICE_MAGIC nos comandos + responders RESYNC_SEQ/PING_SURVEY
    - senderAuthorized(from, flags) delega ao predicado puro; 5 sitios de comando
    passam h.flags (marca de servico dispensa vinculo, spec §11.5)
    - handleResyncSeq: responde last_seq ao REQUEST, isento do gate anti-replay
    - handlePingSurvey: responde nodeinfo minimo a PROBE em todos os papeis
    - dispatch cases MSG_RESYNC_SEQ / MSG_PING_SURVEY
    - suite nativa completa 865/865 GREEN (exit 0)
    Comportamento de radio (SERVICE_MAGIC/RESYNC/PING entre binarios) exige banca
    2+ nos antes de campo; nao coberto pela suite nativa.
2026-07-25 docs(irrigation): 8b design — device SERVICO nucleo (cofre/re-tune/scan/config/import-export)
    Segundo recorte da Fase 8, combinado (decisao do usuario). Cofre LittleFS
    multi-cliente (backup 5.5 completo por cliente, PSK+grupos — fecha adiado 6b/7b),
    re-tune de canal+reboot, varredura do cliente ativo, config r/w 2 rotas,
    RESYNC requester, import/export via USB serial. Plaintext (cifra 5.5 adiada),
    parse-light/carry-opaque, sem bump de ABI nem VERSION. Novos TUs ServiceBackup/
    ServiceVault/ServiceController + IProfileStore; ~3 suites nativas (56->~59).
    Portal 8c, survey 8d, import-no-gateway follow-on.
2026-07-25 feat(irrigation): 8b buildClientBackup (5.5 envelope assembly)
2026-07-25 feat(irrigation): 8b planMerge (by-id merge/replace)
    [ServiceBackup.cpp, ServiceBackup.h, test_main.cpp]
2026-07-25 feat(irrigation): 8b ServiceController orchestration (planRetune/nextSeq/onResyncReply)
    Vault-owning controller producing intents; pure/native-tested end to end.
    Fixes resync off-by-one: store lastSeq so next nextSeq() resumes at lastSeq+1.
    [ServiceController.cpp, ServiceController.h, test_main.cpp]
2026-07-25 feat(irrigation): 8b module glue — SERVICO vault store + re-tune/scan/RESYNC executors
    LittleFsProfileStore (FSCom, staged writes, index file; no-op sans FSCom).
    IrrigationModule owns ServiceController when role==SERVICO; applyRetune mirrors
    commitPairing (channel+lora preset+reboot); svcEmitProbe/svcSendResyncRequest
    stamp FLAG_FROM_SERVICE; PING/RESYNC REPLY intake feeds the controller; SERVICO
    button LONG dumps vault to serial (§11.7 bench). Native compile+link GREEN.
    [IrrigationModule.cpp, IrrigationModule.h, LittleFsProfileStore.cpp, LittleFsProfileStore.h]
2026-07-25 feat(irrigation): 8b gateway 5.5 export (PSK+tables) + CI-only endpoint + panel button
    gwBuildBackup composes a 1-client irrig-vault envelope from live tables
    (reuses IrrigationWeb::build*), channel PSK base64, stations+epochs. CI-only
    GET /api/irrigation/export (hExport, native-excluded) + header download button.
    native-suite-count 56->59. Full native suite GREEN 897/897.
2026-07-25 docs(irrigation): 8c design — portal device SERVICO (Clientes/Rede/Log + import/export)
    Terceiro recorte da Fase 8. Portal Wi-Fi do device ganha 3 abas no role
    SERVICO (§11.8) + vias portal do import/export (§11.7). Editor de config
    por nó = campos completos (settings v5, 2 rotas §11.6); via cartão-SD
    adiada. Camada pura ServicePortalApi (round-trip buildStationConfig/
    parseStationConfig) + glue ServicePortalEndpoints + writer servico.jsonl.
2026-07-25 docs(irrigation): 8c plano de implementação — portal device SERVICO
    15 tasks TDD: camada pura ServicePortalApi (buildClientList/parseSelect/
    buildScanResults/buildStationConfig+parseStationConfig round-trip/
    parseNodeConfigReq/parseNodeAction/buildServiceLog) → suite nova
    test_service_portal; glue servico.jsonl writer; accessors svcPortal*
    (select/scan/read+write config 2 rotas/ação); endpoints ESP32
    /api/portal/service/* + import/export com staging; frontend 3 abas.
2026-07-25 feat(irrigation): 8c servico.jsonl writer/reader (store + ServiceController.logService)
    IProfileStore ganha appendLog/logReader (IServiceLogReader); RamProfileStore + LittleFsProfileStore implementam (tail 8KB, no-op sem FSCom). ServiceController::logService anexa linha JSONL (uptime + ts adotado do gateway; device sem RTC). ServiceVault::getStore expoe o store. Co-Authored-By: Claude Opus 4.8 <noreply@anthropic.com>
2026-07-25 feat(irrigation): 8c svcPortal accessors — clientes/scan/config r-w (DIRECT)/acao
    svcIsService + svcPortalListClients/Select(applyRetune)/StartScan/ScanResults; svcPortalReadConfig (GET_CONFIG -> handleSvcSetConfigReply remonta blob via reasm, cacheia sem aplicar) + svcPortalGetReadConfig; svcPortalWriteConfig rota DIRECT (epoch+1, gateway adota via 5.4; VIA_GATEWAY=follow-on: wire nao tem config-para-estacao-X via gateway); svcPortalNodeAction pulso(CmdValvula)/zona(RemoteCmd)/resync (approve_pair=follow-on); svcPortalBuildLog. test_service_portal 8/8 GREEN, modulo compila+linka (Docker). Co-Authored-By: Claude Opus 4.8 <noreply@anthropic.com>
2026-07-25 feat(irrigation): 8c endpoints /api/portal/service/* + import/export (staging FSCom)
    ServicePortalEndpoints.cpp (gated role==SERVICO): clientes/select(202 reboot)/scan/node config read+write/action/log/export/import(+replace). Import streama corpo -> arquivo staging -> valida+merge. svcPortalExport/Import/SeedConfig no modulo (seed dos campos geridos exige read-before-write, evita zerar boundGateway/epoch). Excluido do nativo em portduino.ini; registrado em ContentHandler (2 sitios). Modulo compila+linka + test_service_portal 8/8 GREEN (Docker). Endpoints/ContentHandler sao CI/banca-only. Co-Authored-By: Claude Opus 4.8 <noreply@anthropic.com>
    [ContentHandler.cpp, IrrigationModule.cpp, IrrigationModule.h, ServicePortalEndpoints.cpp, ServicePortalEndpoints.h]
2026-07-25 feat(irrigation): 8c frontend — abas Clientes/Rede/Log do portal SERVICO
    index.html + app.js: 3 abas reveladas quando role==Servico (esconde no/rede-local). Clientes (lista+selecionar re-tune+import/export), Rede-cliente (varredura+tabela de nos+editor de config de campos: escalares/pinos como inputs, sensores/intertravamentos como JSON; rota direta/gateway), Log (servico.jsonl). Estatico, validado em banca. Co-Authored-By: Claude Opus 4.8 <noreply@anthropic.com>
2026-07-25 feat(irrigation): 8d module glue — beacon emit + gateway survey log
2026-07-25 feat(irrigation): 8d frontend — Cobertura tab (panel) + beacon control (portal)
2026-07-26 feat(irrigation): UI parity with mockup + 1st-boot role wizard
    Panel: bottom nav 11->5 (Visão Geral/Estações/Zonas/Programas/Mais); "Mais"
    groups the secondary screens (Grupos, Intertravamentos, Sensores, GPO, Tamper,
    Log, Cobertura, Sistema) behind a persistent back sub-bar. Visão Geral redesigned
    to the mockup: stats, running, pairing, unacknowledged alerts (list + Reconhecer),
    upcoming runs (computed client-side from the phone clock, correct even when the
    gateway has no RTC).
    Portal: first-boot role wizard (§6) - full-screen role picker shown only while the
    node is unprovisioned; hidden for good once the role is saved (change = factory
    reset). Restyled in the mockup's oklch/card lan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
    [IrrigationModule.cpp, IrrigationModule.h, IrrigationPortalEndpoints.cpp, IrrigationWebApi.cpp, IrrigationWebApi.h, IrrigationWebEndpoints.cpp, PortalApi.cpp, PortalApi.h]
2026-07-26 chore(irrigation): extend UI mock for alerts, ack and portal wizard
    mock.js now stubs GET /api/irrigation/alerts and the ack command (kind:"ack"
    clears the list), plus the portal endpoints (/api/portal/node, sensors, log,
    coords, net/roster, provision). Open portal/index.html with ?wizard=1 to preview
    the first-boot role wizard (node reported unprovisioned). The portal mock include
    is added (commented) to portal/index.html.
2026-07-26 docs(irrigation): manual operacional para usuarios finais
    Adicionado guia prático focado no ponto de vista operacional:
    - Acesso ao painel web
    - Operação diária (visão geral, estações, zonas)
    - Programas cronograma automático
    - Grupos hidráulicos com coordenação de bombas
    - Sensores e intertravamentos
    - Pareamento de nós novos
    - Troubleshooting comum
    - Checklist de manutenção
    - Segurança: PSK, allowlist, failsafe
    Complementa docs/irrigacao/funcionamento-sistema-irrigacao.md (dev POV).
2026-07-26 fix(irrigation): ack reconhece só o alerta clicado, não todos
    Cada botão "Reconhecer" enviava {kind:'ack'} sem identidade; o backend
    tratava ack como marca-d'água única (lastAckAllMs) e escondia todos os
    alertas anteriores. No mock local o handler zerava STATE.alerts. Um
    clique reconhecia tudo.
    Ack agora carrega a identidade do alerta (node+type+arg+atMs):
    - Alert.acked + AlertCenter::ackMatch()/unackedCount()
    - buildAlerts ignora acked e serializa atMs
    - WebCommand transporta type/arg/atMs; parseCommand os lê
    - ACK_ALERT: com identidade -> ackMatch; atMs==0 -> reconhecer todos (legado)
    - badge "Alertas" do overview passa a contar pendentes (não o ring total)
    - app.js: botão carrega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
    [IrrigationModule.cpp, IrrigationModule.h, IrrigationWebApi.cpp, IrrigationWebApi.h, IrrigationWebEndpoints.cpp, StationMonitor.cpp, StationMonitor.h]
2026-07-30 docs(irrigation): design — controle de nível por boia (enchimento)
    Feature aditiva pós-Fase 8: boia (sensor digital) num nó controla
    partida/parada de bomba em outro nó ou GPO do gateway. Enchimento
    automático, 1 boia, histerese por tempo, fail-safe desliga+alerta na
    perda de sinal. Abordagem A: tabela LevelControl + engine puro no
    gateway, dirige routeZoneToGroup existente. Aditivo total (sem ABI de
    estação, sem novo wire).
2026-07-30 docs(irrigation): plano de implementação — controle de nível por boia
    8 tasks TDD: LevelControlTable + LevelControlEngine (puros, native-tested),
    codec web, enums/agregado/persistência, glue no gwTick + executor de zona,
    backup 5.5, endpoints CI-only + aba painel, verificação. Aditivo total.
2026-07-30 feat(irrigation): nível — LevelControlTable (modelo + serialização)
2026-07-30 feat(irrigation): nível — LevelControlEngine (start/stop/renew/stale)
2026-07-30 feat(irrigation): nível — codec web build/parse de regras
2026-07-30 feat(irrigation): nível — enums, agregado gateway e persistência
2026-07-30 feat(irrigation): nível — avaliação no gwTick, executor de zona e apply-helpers
2026-07-30 feat(irrigation): nível — regras no backup 5.5 do cliente
2026-07-30 feat(irrigation): nível — endpoints CI-only e aba do painel
2026-07-30 fix(irrigation): nível — re-comment mock.js include (prod must not load mock)
2026-07-30 fix(irrigation): nível — veto de intertravamento no open de bomba fora de grupo
    gwDriveZone pulava zoneVerdict.bloqueada no caminho direto (zona livre),
    deixando o controle de nível sobrepor um intertravamento de seguranca ativo
    (fechar_e_bloquear/bloquear_abertura) numa bomba nao-agrupada. Espelha o guard
    canonico do scheduler/routeZoneToGroup. Fecha I1 do review final de branch.
    [IrrigationModule.cpp]
2026-07-30 docs(irrigation): nível — nota de roadmap (feature aditiva pós-Fase 8)
2026-08-01 docs(irrigation): spec — UI de nível (boia) em cards + form em frase
2026-08-01 docs(irrigation): plano — UI de nível (boia) em cards + form em frase
2026-08-01 test(irrigation): nível — mock com 2 regras consistentes + smoke test
2026-08-01 feat(irrigation): nível — helpers puros de HTML (cards/form) + testes
2026-08-01 test(irrigation): nível — reforça testes de escaping/id/fmtDur
    Adições:
    - XSS: verifica escaping de HTML em nomes de sensor (esc());
    - id-prefill: afina asserção de hidden field para id="nv-id" value="1";
    - fmtDur(0): afirma comportamento com zero segundos.
2026-08-01 feat(irrigation): nível — renderNiveis em cards + form em frase com dropdowns
2026-08-01 style(irrigation): nível — CSS de cards + form em frase
    Adiciona bloco .lvl-* completo para estilizar o painel "Controle de
    nível (boia)": cards com espaçamento, chips, botões alinhados, e form
    em frase com selects inline. Reusa vars existentes (--muted, --text,
    --border) e classes (.finput).
2026-08-01 fix(irrigation): nível — test_niveis sai limpo (process.exit) evitando hang do poll em CI
2026-08-01 refactor(irrigation): nível — remove param list não usado de wireNiveis
2026-08-01 feat(irrigation): nível — UI portada do mockup (telas lista/edição, pills, mini-tanque, polaridade 2 botões, delete inline)
2026-08-01 docs(irrigation): spec Fase 9 — painel de estação (detalhe/edição/remoção/pulso)
2026-08-01 docs(irrigation): plano de implementação Fase 9 — painel de estação
2026-08-01 test(irrigation): mock — assert de audit por-node p/ mini-log da estação
2026-08-01 feat(irrigation): estações — card clicável, pills e bottom-sheet de detalhe
    Card de estação vira clicável (role=button, teclado) com chevron e pills de
    estado derivadas (sync, tamper/safe/hibernação via flags, bateria aviso/crítica,
    enlace degradando via SNR). Clique abre bottom-sheet (overlay no body, sobrevive
    ao poll do #view) com bateria/painel/SNR/reboots/coords e mini-log filtrado por
    node do /audit. Fase 9A (só front, dado real).
2026-08-01 feat(irrigation): ABI v6 — limiares de bateria por-estação no blob
    Apêndice vbatAvisoCentiV/vbatCriticaCentiV (defaults 1220/1180) no fim de
    IrrigationSettings, preservando todos os offsets v5 (sizeof 176→180). migrate
    v1..v5→v6 preenche defaults; StationEntry.blob e STATION_ENTRY crescem (180/215)
    com offsets de serialização atualizados. Corrige buffers de save/load da tabela
    de estações (usavam MAX*87, subdimensionado) via StationRegistry::SERIALIZED_MAX.
    Testes de config cobrem defaults/tamanho/offsets v6 e migração v5→v6.
    [GatewayTables.cpp, GatewayTables.h, IrrigationModule.cpp, IrrigationSettings.cpp, IrrigationSettings.h, test_main.cpp]
2026-08-01 feat(irrigation): sheet de estação — editar/remover/pulso + mock dos endpoints
    Sheet ganha botão Editar (modo edição: heartbeat, limiares de bateria, lat/lon →
    POST /stations/config, estação vira "pendente"), remoção com confirmação e trava
    de zonas vinculadas (POST /stations/delete) e teste de pulso por saída escolhida
    (POST /stations/pulse) com estados idle/enviando/aberto/fechado. View mostra
    SNR/RSSI, heartbeat e limiares. mock.js enriquece as estações (vpanel/snr/rssi/
    reboots/flags/coords/hb/limiares/outputs) e simula os 3 endpoints. Front-only;
    endpoints de firmware (B3/C1/D1) ainda pendentes.
    [mock.js]
2026-08-01 feat(irrigation): endpoints de estação — config/delete/pulse + rssi/outputs no /stations
    Backend Fase 9 B3/B4/C1/D1:
    - /stations expõe rssiDbm, hbMinutes, vbatAviso/CriticaCentiV e outputs[] (saídas
    físicas derivadas do blob); StationTelemetry ganha rssiDbm (ingest do heartbeat).
    - POST /stations/config: parseStationConfig (contrato inteiro — centiV, latE7/lonE7)
    + gwApplyStationConfig (muta blob desejado, bump epoch, re-push SET_CONFIG §5.4).
    - POST /stations/delete: gwRemoveStation com trava de zonas vinculadas.
    - POST /stations/pulse: gwStationPulse valida saída no blob e envia CMD_VALVULA/GPO.
    - Front/mock alinhados ao contrato inteiro do /stations/config.
    Native: parsers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
2026-08-01 fix(irrigation): pareamento — card funcional (detecção + aprovação)
    Antes: hOverview nunca populava pairing* e as Estações não tinham botão Aprovar,
    então o pareamento era inoperável pelo painel. Agora:
    - GatewayPairing rastreia announce pendente (janela fechada) via notePending/
    hasPending/pendingSecondsLeft (TTL 2 min = janela do nó); handlePairAnnounce
    registra pendente e limpa ao conceder.
    - hOverview expõe pairingPending/NodeId/SecondsLeft (getters gwPairing*).
    - Overview: card de pareamento clicável → aba Estações.
    - Estações: card "Nó novo detectado" + botão Aprovar → /command approve_pairing.
    - mock simula announce pendente + aprovação (registra estaç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
    [IrrigationModule.cpp, IrrigationModule.h, IrrigationWebEndpoints.cpp, Pairing.h, mock.js, test_main.cpp]
2026-08-01 feat(irrigation): backup — download robusto via fetch+Blob com feedback
    renderSistema troca o <a href=/export download> por botão + fetch→Blob→download,
    dando feedback de sucesso/erro (o <a download> contra o webserver embarcado não
    sinaliza falha). mock /export passa a devolver o envelope §11.7 (fmt irrig-vault +
    clients[]) p/ o preview refletir o formato real. Backend gwBuildBackup inalterado.
2026-08-02 feat(irrigation): backup — inclui config v6 da estação (heartbeat + limiares)
    gwBuildBackup emite hbMinutes/vbatAvisoCentiV/vbatCriticaCentiV por estação (do
    blob desejado migrado) no estacoes[], tornando o backup §5.5 lossless p/ a config
    editável da Fase 9. Seguro p/ o importador: extractLight faz key-seek e ignora
    chaves desconhecidas (test_extractLight_toleratesV6StationFields). estB 1200→2048.
    mock /export reflete os campos.
    Native: test_service_backup 17/17; build native SUCCESS.
2026-08-02 feat(irrigation): board pin-map defaults mapper + native test
    Adds IrrigationBoardDefaults.h (static inline mapper to apply pin mappings from
    board variant macros) and test_irrigation_board_defaults (3-case Unity suite
    verifying pin assignment, sentinel preservation, and non-pin field immutability).
    Suite count bumped 64→65.
2026-08-02 feat(irrigation): apply board pin-map defaults on first boot
2026-08-02 feat(irrigation): custom_irrigation variant (Heltec V2 seed) + board doc
2026-08-02 fix(irrigation): review polish — harden numValves assert, HW_VENDOR/pull-up doc notes, comment
    [IrrigationModule.cpp, test_main.cpp]
2026-08-02 feat(irrigation): mirror endpoints + gateway glue (CI-only)
    Adds gwSetMirrorEnabled/gwApplyMirrorMapping/gwDeleteMirrorMapping/
    gwBuildMirror to IrrigationModule and 4 /api/irrigation/mirror/* endpoints
    (GET mirror, POST mirror, POST mirror/mapping, POST mirror/mapping/delete).
    All endpoints gated by gwReady(). Glue persists via saveGatewayState() +
    saveIrrigationSettings(); enforces one-zone-per-port; sets digitalInActiveLow
    bit per invertido flag. Audits via AuditAction::CONFIG_EPOCH (no CMD_ACEITO
    in enum). Registration added to single registerIrrigationHandlers() which
    ContentHandler.cpp calls for both secureServer and insecureServer.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
2026-08-02 fix(irrigation): mirror review — byFonte clear, ESPELHO audit action, capture id
    [AuditLog.h, IrrigationModule.cpp]
2026-08-02 feat(irrigation): painel — tela Modo Espelhamento (Mais)
2026-08-02 fix(irrigation): espelhamento UI — back button + informative port label
2026-08-02 fix(irrigation): espelhamento — prompt-close on pause/delete + review nits
    Finding 1: gwApplyMirrorMapping now sends an immediate CLOSE
    (gwSendValveCmd node/index/tipo 0 0 id 1) when habilitado=false AND
    mirror.enabled() AND mirror.inputActive(port), avoiding the 120 s
    fail-safe wait when the operator pauses an active association.
    gwDeleteMirrorMapping captures node/index/tipo/fonteInput before
    clearing the zone, then sends the same CLOSE under the same guard.
    Finding 2: Fix buffer-size comment for zones (was 696→800, now 702,
    matching 6 + ZoneTable::MAX*29 with MAX=24).
    Finding 3: renderEspelhamento() returns early when mrUI.screen==='edit'
    so the 3 s poll refreshes mrData cache but d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
    [IrrigationModule.cpp, test_main.cpp]
2026-08-02 fix(irrigation): espelhamento — reset to list after save/delete (poll-guard regression)
2026-08-02 docs(irrigation): specs+plans — custom_irrigation board, espelhamento UI, sistema restore
2026-08-02 feat(irrigation): painel Sistema — Restaurar + remove cards chave/PIN
2026-08-02 fix(irrigation): restore — bound per-item parse to element + mock config nesting
    Finding 1: add sliceToBuf() helper in anon namespace; all four apply callbacks
    (applyZone/applyProgram/applyInterlock/applyGroup) now copy each jsonForEachArray
    element into a 1024-byte NUL-terminated stack buffer before calling the legacy
    strstr/strchr-based parsers, preventing out-of-bounds reads into sibling elements.
    Elements ≥1024 bytes are skipped (return true = continue).
    Add test_import_two_zones_isolated: two zones with distinct node values in one
    envelope; asserts c.zonas==2 and each zone carries its own node, proving isolation.
    Finding 2: mock.js POST /import handler now reads zonas/programas/int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
    [IrrigationWebApi.cpp, mock.js, test_main.cpp]
2026-08-03 feat(irrigation): portal — normaliza CSS p/ linguagem do gateway (header/tabs/btn) + plano de port visual
2026-08-03 feat(irrigation): portal — uptimeS no node-state
2026-08-03 feat(irrigation): portal — componentes .fp-* + header ids + aba Enlace
2026-08-03 feat(irrigation): portal — render Este nó por papel + GPO confirm inline + sensores/log/pulso/rede no visual do mockup
2026-08-03 feat(irrigation): portal — Serviço (clientes/scan/config/log) no visual do mockup
2026-08-03 feat(irrigation): portal — render da aba Enlace + mock (uptime/vpanel + rota /link)
2026-08-03 feat(irrigation): portal — buildLink (enlace do repetidor) + teste
2026-08-03 feat(irrigation): estação — captura SNR/RSSI do gateway + ring + portalFillLink (vizinhos NodeDB)
2026-08-03 feat(irrigation): portal — endpoint GET /api/portal/link (enlace do repetidor)
2026-08-03 fix(irrigation): portal — buf do /link 512→1024 (8 vizinhos + histórico)
    [IrrigationPortalEndpoints.cpp]
2026-08-03 feat(irrigation): gateway — subtela Malha/Enlace (SNR/RSSI/bateria por nó) na aba Mais
2026-08-03 feat(irrigation): portal — aba Mais no nó (Enlace + Coordenadas); Enlace agora estação+repetidor
2026-08-06 docs(irrigation): spec fase 8a — conectividade WiFi gateway (STA+LAN+mDNS)
    Portal ganha card Rede Wi-Fi (provisionamento STA), gateway acessivel
    via irrigacao.local na LAN, arbitragem AP/STA em PortalAp. NTP/relogio
    fora de escopo (fase futura).
2026-08-06 docs(irrigation): plano fase 8a — conectividade WiFi gateway (12 tasks TDD)
2026-08-06 feat(irrigation): portal — PortalWifiApi (status/scan/connect/toggle) host-tested
2026-08-06 test(irrigation): portal WiFi — testes de truncamento/psk-ausente + comentarios
2026-08-06 fix(irrigation): portal WiFi — SSID do teste de truncamento cabe em ssid[33]
    String de 33 chars estourava ssid[33] no strcpy (__strcpy_chk SIGABRT no
    exit). Encurtada p/ 27 chars; 16 itens ainda estouram buf[64], teste segue
    valido.
    [test_main.cpp]
2026-08-06 feat(irrigation): gateway — metodos WiFi STA (status/scan/connect/forget/toggle)
2026-08-06 fix(irrigation): gateway — scan WiFi FAILED devolve lista vazia (nao trava spinner)
    WIFI_SCAN_FAILED(-2) era tratado como RUNNING, deixando o portal em
    'scanning' indefinido. Agora so RUNNING(-1) mantem spinner; FAILED zera
    a lista.
    [IrrigationModule.cpp]
2026-08-06 feat(irrigation): portal — endpoints /api/portal/wifi/* (scan/connect/forget/toggle)
2026-08-06 fix(irrigation): portal — AP coexiste com STA (WIFI_AP_STA), teardown mantem STA
    [PortalAp.cpp]
2026-08-06 feat(irrigation): mDNS hostname irrigacao.local (servico meshtastic mantido)
    Fork inteiro e firmware de irrigacao; so a gateway sobe mDNS. Hostname
    Meshtastic->irrigacao para acesso via http://irrigacao.local; servico mDNS
    'meshtastic' preservado para descoberta do app.
2026-08-06 feat(irrigation): portal — card Rede Wi-Fi (UI do mockup + fluxo scan/connect)
2026-08-06 fix(irrigation): portal WiFi — poll cancela em voo (gen guard) + timeout de connect
2026-08-06 fix(irrigation): portal — escrita de WiFi exige janela do portal aberta (403)
    Com STA sempre-on os /api/portal/wifi/* ficam alcancaveis pela LAN.
    connect/forget/toggle agora exigem portalSession().apShouldBeUp() (botao
    do gateway pressionado) — presenca fisica p/ trocar credencial. status/scan
    seguem livres (leitura).
    [IrrigationPortalEndpoints.cpp]
2026-08-06 fix(irrigation): endpoints WiFi respondem 404 fora do gateway
    WiFi so faz sentido no gateway; nos (bateria/solar) nao provisionam nem
    varrem redes. wifiOnGateway() guarda todos os /api/portal/wifi/*.
    [IrrigationPortalEndpoints.cpp]
2026-08-06 docs(irrigation): spec — Horário no gateway + relógio nos nós (fase 8b)
2026-08-06 docs(irrigation): plano de implementação — Horário + relógio (fase 8b)
2026-08-06 feat(irrigation): buildTimeStatus + tabela de fusos (fase 8b)
2026-08-06 feat(wifi): triggerNtpUpdate/ntpLastRunMs p/ painel de irrigação (fase 8b)
2026-08-06 feat(irrigation): cola de Horário no módulo + relógio no node-state (fase 8b)
2026-08-06 feat(irrigation): painel — página Horário + badge de relógio no header (fase 8b)
2026-08-06 feat(irrigation): portal — relógio na página principal do nó (fase 8b)
2026-08-06 fix(irrigation): relógio em epoch UTC + saveToDisk no fuso (revisão fase 8b)
    - nowEpoch usa getValidTime(local=false): evita offset de fuso dobrado no cliente
    - gwSetTimezone persiste com nodeDB->saveToDisk em vez de reloadConfig (sem reconfig de radio)
    [IrrigationModule.cpp]
2026-08-06 feat(irrigation): uniformiza página Horário do painel + remove pill "com relógio"
    Alinha a página Horário (aba Mais) do painel do gateway ao mockup
    (Irrigacao Mobile.dc.html): funde "Relógio do gateway" + "Fonte de hora"
    num só card, agrupa os dados NTP em caixa, coloca data/hora manual em linha
    e enriquece as linhas de "Sincronização por dispositivo" (nome + nó + chip).
    Mostra o rótulo GMT±X no relógio ("Agora: … · GMT-3") e em cada fuso da
    lista, para facilitar a identificação do fuso.
    As classes fp-*/stack usadas pela página viviam só em .field-portal (portal
    do nó) e não estilizavam no painel; reaplicadas com os mesmos tokens do
    mockup, escopadas em .view.
    Remove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
2026-08-06 fix(irrigation): mock WiFi não parava de escanear (POST /wifi/scan engolido)
    O bloco POST de /api/portal no mock.js terminava com um
    `return mockResponse({ ok: true })` incondicional, que respondia a todo
    POST antes dos handlers dedicados de /wifi/scan e /wifi/connect. Com isso
    scanInProgress era ligado pelo toggle mas nunca agendava o desligamento
    (1,5 s), então GET /wifi/scan devolvia scanning:true para sempre — a tela
    ficava em "Buscando redes próximas…" e nunca listava o mock.
    Remove o return prematuro; os POSTs de WiFi caem nos handlers que tratam
    método. O catch-all no fim do bloco cobre qualquer POST não tratado.
    Também destrava o fluxo /wifi/connect, quebrado pelo mesmo mo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
    [mock.js]
2026-08-06 fix(irrigation): corrige inconsistências da revisão de branch
    - ProgramScheduler::deserialize: clampa stepCount>8 para não indexar
    steps[] (array de 8) fora dos limites com blob corrompido.
    - HydraulicGroupTable: remove cópia local de crc32; usa
    IrrigationProto::crc32 (algoritmo idêntico → blobs compatíveis).
    - Endpoints HTTP: extrai sendJson/sendParseErrors/readBody (antes
    triplicados idênticos) para IrrigationEndpointHelpers.h inline.
    - ContentHandler: guarda includes+chamadas de irrigação com
    MESHTASTIC_EXCLUDE_IRRIGATION (coerente com Modules.cpp).
    - mock.js: implementa /time, /timezone, /time/sync (página Horário
    quebrava em preview offline por 404).
    Testes nativ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
    [ContentHandler.cpp, HydraulicGroupTable.cpp, IrrigationEndpointHelpers.h, IrrigationPortalEndpoints.cpp, IrrigationWebEndpoints.cpp, ProgramScheduler.cpp, ServicePortalEndpoints.cpp, mock.js]
2026-08-07 docs(irrigation): design de supressão por previsão meteorológica (Open-Meteo)
    Fase meteorologia: subsistema de clima gateway-side (config + regras +
    client Open-Meteo + engine de veredito puro) que suprime programas de
    zonas/grupos quando chuva prevista (12h) E probabilidade ultrapassam os
    limiares de uma regra. Poll 2x/dia, fail-open com TTL, UI espelhando o
    mockup (Mais > Meteorologia). Sem mudança de ABI de estação.
2026-08-07 docs(irrigation): plano de implementação da supressão meteorológica
    16 tasks TDD: enums de auditoria, WeatherConfig/RuleTable/Engine puros
    (testados no nativo), WeatherClient Open-Meteo (HTTPS leve + parse sem
    ArduinoJson), gate no scheduler, endpoints e UI espelhando o mockup.
2026-08-07 feat(irrigation): enums de auditoria CLIMA e CMD_SUPRIMIDO (append-only)
2026-08-07 feat(irrigation): WeatherRuleTable (regras de supressão climática + testes)
2026-08-07 feat(irrigation): WeatherEngine veredito puro (fail-open + limiares + testes)
    [WeatherEngine.cpp, WeatherEngine.h, test_main.cpp]
2026-08-07 test(irrigation): sincroniza native-suite-count (65→68: config/rule_table/engine)
2026-08-07 feat(irrigation): persistência de config e regras de clima (staged write/read)
2026-08-07 feat(irrigation): gate de supressão climática no scheduler (OR zona/grupo + auditoria CLIMA)
2026-08-07 feat(irrigation): WeatherClient Open-Meteo (HTTPS leve + parse sem ArduinoJson + agendamento 2x/dia)
2026-08-07 feat(irrigation): glue do WeatherClient (tick 2x/dia + métodos gwWeather*)
2026-08-07 feat(irrigation): builders/parse de clima (status + regra + config, com testes)
2026-08-07 feat(irrigation): painel — página Meteorologia (lista + edição de regra)
2026-08-07 feat(irrigation): painel — rótulo de supressão climática em zonas/grupos
2026-08-07 fix(irrigation): LOG_WARN de clima em formato printf de string única
    [WeatherClient.cpp]
2026-08-07 fix(irrigation): inclui <HTTPServer.hpp> nos endpoints de portal/serviço
    Pré-existente (não relacionado à supressão meteorológica): IrrigationPortalEndpoints.cpp
    e ServicePortalEndpoints.cpp chamam server->registerNode() mas só incluíam
    <ResourceNode.hpp> (forward-decl de HTTPServer) — 'invalid use of incomplete type'
    no build ESP32 (heltec-v3). Espelha o include de ContentHandler.cpp.
    [IrrigationPortalEndpoints.cpp, ServicePortalEndpoints.cpp]
2026-08-07 fix(irrigation): portalApLoop usa unsigned long (evita mismatch de mangling uint32_t)
    Pré-existente (não relacionado à supressão meteorológica): uint32_t resolvia como
    unsigned int em PortalAp.cpp (via DNSServer.h/WiFi.h) e unsigned long no TU do chamador
    (IrrigationModule.cpp), gerando 'undefined reference to portalApLoop(unsigned long)' no
    link ESP32. Assinatura explícita unsigned long (domínio de millis()) elimina a ambiguidade.
    [PortalAp.cpp, PortalAp.h]
2026-08-07 fix(irrigation): PortalAp.cpp inclui configuration.h antes do guard ARCH_ESP32
    Pré-existente (não relacionado à supressão meteorológica): o guard
    '#if defined(ARCH_ESP32)' estava ANTES do #include "configuration.h" que define
    ARCH_ESP32 (macro de header, não -D). Resultado: corpo de PortalAp.cpp sempre
    compilado para fora (.o vazio, nm sem símbolos) → 'undefined reference to portalApLoop'
    no link ESP32, pois o chamador (IrrigationModule.cpp) define ARCH_ESP32 cedo e emite a
    chamada. Nunca linkou em heltec-v3.
    [PortalAp.cpp]
2026-08-07 docs(irrigation): design motor sem-válvula (gateway standalone local + remoto)
2026-08-07 docs(irrigation): plano motor sem-válvula (local gateway + remoto)
2026-08-07 feat(irrigation): isLocalTarget — predicado puro de zona local do gateway
2026-08-07 feat(irrigation): gateway aciona motor local + expõe selfNode + confirmCommand
    Caso 1 (gateway standalone): zona cujo node é o próprio gateway (isLocalTarget)
    aciona valves/gpos diretamente em gwSendValveCmd, sem rádio; motor irriga o
    terreno sem válvula nem estação. ACK sintético enfileirado e drenado no gwTick
    (após noteSent) confirma o handshake do motor de grupos sem reentrância.
    - confirmCommand(node,seq,reason,ok): núcleo extraído de handleGwAck, reusado
    pelo drive local e pelo ACK de rádio (sem mudança de comportamento remoto).
    - gwSendValveCmd ganha param AuditOrigin (default PAINEL); scheduler=CRONOGRAMA,
    grupo=GRUPO_HIDRAULICO auditam o drive local corretamente.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
2026-08-07 feat(irrigation): painel oferece "Gateway (local)" e rótulo Motor/GPO no form de zona
    renderZones busca /overview p/ selfNode; zoneEditForm injeta o chip "Gateway
    (local)" no topo da lista de nós-alvo (motor na placa do gateway, sem estação).
    Tipo tipo=1 rotulado "Motor / GPO" no form e no card. mock.js: selfNode no
    overview + zona-motor local de exemplo p/ preview offline.
    Frontend = CI/banca-only. Verificado: node --check em app.js/mock.js OK.
2026-08-08 feat(irrigation): tela combinada "Grupos & Intertravamentos" no modelo do mockup
    Funde as duas entradas de "Mais" (Grupos hidráulicos + Intertravamentos)
    numa única tela combinada, seguindo o mockup "Irrigacao Mobile.dc.html" e o
    sistema visual lvl-* já usado no Controle de nível.
    - Menu: uma entrada "Grupos & Intertravamentos"; rota intertravamentos removida.
    - Lista (renderGruposInterlocks): cards gi-* refinados por grupo (bomba/zonas por
    NOME, rótulo de estado em PT com cor, config e supressão meteo) + seção de
    intertravamentos. Mantém N grupos (+ Novo grupo); Abrir/Fechar removidos —
    estado segue ao vivo via pollGroupStatus.
    - Edição de grupo: pills com nomes de zona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
2026-08-08 docs(irrigation): design do Modo Remoto (botoeira → saída remota + LED)
    Gateway-central: associações em RemoteButtonTable (flash própria); botoeira =
    entrada digital com papel botão (borda+debounce); toggle-latch via gwSendValveCmd
    (herda fail-safe/interlock/grupo/local+remoto); 2 msgs novas (REMOTE_TRIGGER up,
    REMOTE_LED down change-driven); LED no nó da botoeira (pisca→fixo→apaga + estado
    compartilhado). ABI settings v6→v7 (+pinsRemoteLed[2]+btnMask+ledIdx=184B).
    UI baseada no mockup fornecido (Mais→Modo Remoto) com dedup de saída, sem pill
    global, LED por gatilho.
2026-08-08 docs(irrigation): plano de implementação do Modo Remoto (11 tasks)
    TDD por task: protocolo (14/15), settings v7, RemoteButtonTable,
    RemoteButtonEdge+RemoteLedFsm, webapi (dedup), cola gateway/estação,
    endpoints CI-only, frontend (mockup fornecido), backup §5.5, verificação.
    Suítes nativas 69→71. Banca 2+ nós + build ESP32 exigidos.
2026-08-08 feat(irrigation): settings ABI v7 (pinsRemoteLed[2]+btnMask+ledIdx, 180->184)
2026-08-08 fix(irrigation): corrige timing do teste de debounce (borda exige 50ms estável)
    [test_main.cpp]
2026-08-08 feat(irrigation): cola gateway do modo remoto (trigger/toggle/LED push/persistência)
    - IrrigationGateway: membro RemoteButtonTable remoteButtons
    - IrrigationModule: load/saveRemoteButtons (staged-write, GW_REMOTE_PATH)
    - Dispatch MSG_REMOTE_TRIGGER → handleRemoteTrigger (anti-replay + auth)
    - gwFireRemote: toggle via gwRunCommandOpen/Close (reusa routeZoneToGroup)
    - gwZoneIsOpen: openGate.isOpen (zonas livres) + groupEngine.currentZone RUNNING
    - gwPushRemoteLed: change-driven via cache node→states; applyLocalRemoteLeds
    - LED push wired em confirmCommand (peekZone antes de onAck remove slot)
    - Botoeira local: leitura em runOnce após bloco mirror + _btnEdge/_remoteLed
    - gwApplyRemoteUpse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
2026-08-08 fix(irrigation): gwZoneIsOpen usa estado real do atuador (local driver + telemetria); LED push em delete; remove param morto
    [IrrigationModule.cpp, IrrigationModule.h, StationTelemetryCache.h]
2026-08-08 fix(irrigation): LED-drive do modo remoto roda em todos os papéis (move antes do guard de papel)
    Gateway chama _remoteLed[slot].onPress() no gwTick() (Task 6) colocando o slot
    em BLINK, mas o loop de digitalWrite estava dentro do branch ESTACAO-only e
    nunca rendia no pino do gateway. Move o loop para antes do guard
    `if (role != ESTACAO) { return 1000; }` para que GATEWAY, REPETIDOR e ESTACAO
    todos renderizem pinsRemoteLed a cada tick. Cópia única — sem duplicata.
    [IrrigationModule.cpp]
2026-08-08 feat(irrigation): painel Mais->Modo Remoto (dedup de saída, LED por gatilho) + mock
2026-08-08 feat(irrigation): backup/restore da RemoteButtonTable (§5.5)
    - BackupSource.remoteButtonsJson: novo campo (nullptr → "[]")
    - buildClientBackup: emite "remoteButtons" no bloco config
    - gwBuildBackup: preenche remoteButtonsJson via buildRemote()
    - importRemoteButtonsFromBackup: puro, reusa sliceToBuf+scanner
    - gwImportTables: chama import + saveRemoteButtons(); inclui
    "remoteButtons" na resposta JSON
    - test_import_remoteButtons: envelope mínimo → tabela reconstruída
2026-08-08 refactor(irrigation): remove pill redundante de gatilho no editor do Modo Remoto
    A entrada selecionada já é evidenciada pelo chip destacado acima e re-listada
    na seção de LED por gatilho abaixo; a pill que repetia era ruído. Remoção de
    gatilho segue possível clicando no chip de entrada selecionado (toggle-off).
2026-08-08 fix(irrigation): test runner usa setup()/loop() (portduino define main)
    test_remote_button e test_remote_button_table definiam int main(), colidindo
    com o main() do framework portduino (multiple definition of 'main' +
    undefined reference to setup/loop). Convenção do repo = void setup() com
    UNITY_BEGIN/RUN_TEST/exit(UNITY_END()) + void loop().
    [test_main.cpp]
2026-08-08 fix(irrigation): LED de estado compartilhado — telemetria antes do push no ACK + refresh por tick
    IMPORTANT #1: em handleGwAck, move o bloco de atualização de telemetria
    (tel.valveStates/gpoStates + gateway.telemetry.update) para ANTES de
    confirmCommand. Assim, quando confirmCommand→gwPushRemoteLed→gwZoneIsOpen
    avalia zonas remotas, o cache já reflete o estado pós-comando do ACK,
    evitando o push de ledStates=0 que impedia o LED da botoeira de acender.
    IMPORTANT #2: em gwTick(), adiciona chamada periódica a gwPushRemoteLed()
    guardada por remoteButtons.count()>0. Garante repintura do LED quando a
    zona é aberta/fechada pelo scheduler, motor de grupos, fail-safe ou
    heartbeat — sem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
    [GatewayTables.h, IrrigationModule.cpp, IrrigationModule.h]
2026-08-08 docs(irrigation): roadmap — Modo Remoto concluído (v7, msgs 14/15, 1024/1024)
2026-08-11 docs(irrigation): design — tela unificada Enlace/Cobertura
    Funde as telas Malha/Enlace (/stations) e Cobertura (/survey) numa
    tela só com toggle segmentado. Datasets separados sob um teto; reusa
    padrao .seg wide; sem CSS novo.
2026-08-11 docs(irrigation): plano — tela unificada Enlace/Cobertura
2026-08-11 feat(irrigation): helpers puros de render Enlace/Cobertura + testes
2026-08-11 fix(irrigation): harmoniza catch de fetch em renderRadio (/survey)
    Alinha a aba Cobertura à aba Enlace: falha transitória de /survey
    degrada p/ estado vazio em vez de deixar a tela sem corpo.
2026-08-11 docs(irrigation): spec — janela de acesso BLE+Portal AP (boot+botão)
2026-08-11 feat(irrigation): janela de acesso BLE+Portal AP no boot+botao
    Estacao/repetidor provisionados: Portal AP e BLE ativos so numa janela
    compartilhada, aberta no boot e reaberta pelo botao. Fora dela ambos
    desligados de verdade (ESP32: config.bluetooth.enabled=false em RAM ->
    deinit -> release, sticky ate reboot). Botao reabre ao vivo se BLE ainda
    vivo, senao reboot 1.5s. Politica pura testavel + suite nativa.
    [AccessWindowPolicy.h, IrrigationModule.cpp, IrrigationModule.h, PortalAp.cpp, test_main.cpp]
2026-08-11 style(irrigation): trunk fmt (clang-format include order + prettier/ascii-dash no spec)
    clang-format@16.0.3 (config .trunk/configs) nas linhas alteradas; prettier@3.8.3
    + regra ascii-dash no doc de design. Validado com --dry-run --Werror.
2026-08-12 docs(irrigation): spec — modo remoto P2P fallback (gateway offline)
2026-08-12 docs(irrigation): plano + fix ABI v8 208B — modo remoto P2P fallback
2026-08-12 feat(irrigation): ACTION_TOGGLE=2 para comando de saida (P2P fallback)
2026-08-12 feat(irrigation): RemoteFallbackTracker (unidade pura, P2P fallback)
    Header-only unit: arm/clear/takeExpired with millis-wraparound-safe
    int32 comparison. 3/3 tests pass (test_irrigation_fallback suite).
    native-suite-count bumped 72→73.
2026-08-12 feat(irrigation): compileFallbackRoute (pura) p/ rota P2P fallback
    Adiciona FallbackRoute + compileFallbackRoute em RemoteButtonEdge.h:
    dada a info de zona de uma associação, deriva {node, kind, outputId}
    para o fallback P2P direto (válvula ou GPO). Zona grupo, nó ausente
    ou fw antigo retornam rota vazia (node==0). Função pura, sem deps
    Arduino. Cobertura: 4 testes novos (7/7 PASSED).
2026-08-12 feat(irrigation): settings ABI v7->v8 (rota de fallback P2P por botoeira)
    Apende 24 B ao blob on-disk: btnFallbackNode[4](16) + btnFallbackOutId[4](4)
    + remoteFallbackMs(2) + btnFallbackKind(1) + pad3(1) = 208 B (era 184 B v7).
    Todos os offsets v7 preservados; static_asserts verificam layout em compile-time.
    migration: v1-v7 migram para v8 com campos de fallback em default (0/0xFF).
    StationEntry::blob e SERIALIZED_ENTRY atualizados para acomodar v8 (219->243).
    22/22 test_irrigation_config PASSED; 12/12 test_irrigation_gwtables PASSED;
    18/18 test_service_backup PASSED.
2026-08-12 feat(irrigation): estacao emite comando direto P2P no timeout do gatilho + LED por ACK direto
    - IrrigationModule.h: include RemoteFallbackTracker; adiciona _fallback{1800ms} e
    _pendingDirect[MAX_DIGITAL_IN] na secao privada junto aos membros _btnEdge/_remoteLed.
    - runOnce (estacao): arma _fallback imediatamente apos enviar REMOTE_TRIGGER quando
    btnFallbackNode[i]!=0; respeita remoteFallbackMs ou REMOTE_FALLBACK_DEFAULT_MS.
    - runOnce (estacao): bloco takeExpired apos o loop de botoeira: constroi CmdValvula ou
    CmdGpo ACTION_TOGGLE direto ao no-alvo; salva {seq,ledSlot} em _pendingDirect para
    casar o ACK de volta.
    - handleRemoteLed: limpa todos os slots do _fallback quando REMOTE_LED ch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
2026-08-12 feat(irrigation): gateway sobrepoe rota de fallback P2P no push de SET_CONFIG + APP_FW_VERSION 0x0900
2026-08-12 fix(irrigation): corrige offsets pos-blob no StationRegistry (v8 208B)
    Task 4 atualizou STATION_ENTRY=243 e blob[208] mas manteve os offsets
    hardcoded de retries/silencio/lat/lon em 208/209/211/215 (era 24+184).
    Com blob de 208B esses writes invadiam os bytes 184..207 do blob — exatamente
    os campos v8 btnFallback* — corrompendo a rota de fallback P2P no round-trip
    de serializacao. Offsets corrigidos p/ 232/233/235/239. Teste de regressao
    que fixa blob[184]/blob[207] + campos e exige sobrevivencia ao round-trip.
    [GatewayTables.cpp, test_main.cpp]
2026-08-12 fix(irrigation): carimba FLAG_FROM_SERVICE no comando direto P2P (autorizacao no alvo pareado)
    Review C1: o comando direto de fallback parte da botoeira, nao do gateway.
    Um alvo pareado (boundGateway != 0) so autoriza o gateway vinculado OU um
    remetente marcado como servico (senderAuthorizedBy §11.5). Sem a marca o alvo
    respondia NACK UNAUTHORIZED e a saida nunca acionava — fallback silenciosamente
    inutil na rede pareada (caso normal). Estacao passa a carimbar FLAG_FROM_SERVICE,
    mesmo mecanismo dos comandos do gateway; a PSK do canal segue como fronteira de
    confianca. Teste de regressao no codec protocolo.
    [IrrigationModule.cpp, test_main.cpp]
2026-08-15 docs(irrigation): spec de priorizacao de airtime e back-pressure
    Ladder de prioridade por tipo, gate de airtime, HB adaptativo
    (backoff por channel-util + jitter deterministico por epoch) e
    telemetria nativa off nos papeis de irrigacao.
2026-08-15 docs(irrigation): plano de implementacao de priorizacao de airtime
2026-08-15 feat(irrigation): funcoes puras de decisao de airtime (prioridade/gate/backoff/jitter)
    [IrrigationAirtime.cpp, IrrigationAirtime.h, test_main.cpp]
2026-08-15 feat(irrigation): choke point txPacket aplica prioridade por tipo + gate de airtime
2026-08-15 feat(irrigation): heartbeat adaptativo (backoff por channel-util + jitter por epoch)
    [IrrigationModule.cpp, IrrigationModule.h]
2026-08-15 feat(irrigation): knobs hbTrafficFlags (backoff/jitter on por default, reuso de pad @207)
    [IrrigationModule.cpp, IrrigationSettings.h]
2026-08-15 feat(irrigation): alonga telemetria nativa em RAM nos papeis de irrigacao (desocupa airtime)
2026-08-16 docs(irrigation): plano de implementacao OTA local BLE
2026-08-16 feat(irrigation): predicado puro do gate de OTA + parse/status (native-tested)
2026-08-16 feat(irrigation): glue OTA — gate de ciclo ativo + arm loader BLE + status
2026-08-16 refactor(irrigation): extrai otaCycleDecompose (DRY gate/status) + torna helpers privados
    Fix 1: Extrai helper privado otaCycleDecompose() que computa em uma unica vez as tres bandeiras (anyValve, anyGpo, groupActive) usadas tanto por otaCycleActive() quanto portalOtaArm(). Remove 17 linhas de logica duplicada.
    Fix 2: Remove cast redundante (uint8_t*) em portalOtaArm; r.hash decai naturalmente para uint8_t*.
    Fix 3: Move otaCycleActive() do section public: para private: (helper interno); mesmo para otaCycleDecompose(). Mantém portalOtaArm e portalFillOtaStatus publicos (endpoints).
    [IrrigationModule.cpp, IrrigationModule.h]
2026-08-16 fix(irrigation): guard unico do bloco OTA + restaura cast uint8_t* no saveConfig
    Review final (opus) achou 2 Criticals de build ESP32:
    - C1: #endif prematuro deixava portalFillOtaStatus/portalOtaArm fora do
    guard ARCH_ESP32 + #endif orfao (erro de compile em todos os builds).
    - C2: r.hash e const (r e const&); saveConfig quer uint8_t* nao-const.
    O cast (uint8_t*) fora removido por engano no fix da Task 3.
    [IrrigationModule.cpp]
2026-08-21 docs(irrigation): guia unico de deploy (config/build/flash/provisionamento)
    Concentra num so ficheiro: escolha de env/placa, mapa de pinos no variant.h,
    build+upload+uploadfs, regiao LoRa runtime, wizard de papel/pareamento, RTC,
    OTA BLE, verificacao (nativo + build ESP32 no CI), troubleshooting, checklist
    de banca e tabela "editar X -> ficheiro Y". Docs proprios linkados.
2026-09-06 Update na placa
    [BOM_JLCPCB_SMD.csv, Irrigacao_mesh.kicad_pcb, Irrigacao_mesh.kicad_sch]
2026-09-10 Adição de leds no TX e RX
    [BOM_JLCPCB_SMD.csv, Irrigacao_mesh.kicad_pcb, Irrigacao_mesh.kicad_sch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]
2026-09-26 fix(irrigation): portal AP servivel em placa sem WiFi Meshtastic (ex.: XIAO S3)
    Faz o captive portal de irrigacao funcionar de ponta a ponta quando
    config.network.wifi_enabled == false (nao-eligible/gateway/servico/fabrica),
    cenario da bancada em placas como a seeed-xiao-s3.
    - IrrigationModule: no de fabrica (!provisioned) tambem abre o portal AP no
    boot, nao so estacao/repetidor eligible. Sem isso o AP nunca sobe num no
    fresco sem botao de irrigacao wired.
    - WebServer: flag webServerPortalMode + WebServerThread::enable(). O portal AP
    sobe/alimenta o web server HTTP:80 independente do WiFi Meshtastic; handleWeb
    Response e a auto-desativacao da thread passam a considerar a flag. init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
    [ContentHandler.cpp, IrrigationModule.cpp, PortalAp.cpp, WebServer.cpp, WebServer.h]
2026-09-26 fix(irrigation): endurece portal cativo (init idempotente, content-type, redirect)
    - WebServer: initWebServer() idempotente (guard isWebServerReady). Sem isso,
    gateway com WiFi ligado + portal aberto chamava init 2x -> re-registro de
    handlers e segundo bind na porta 80 (vaza HTTPServer antigo, quebra o painel).
    - ContentHandler: reordena contentTypes (.json antes de .js) -> o loop usa rfind
    (substring) e .js casava dentro de .json, servindo JSON como text/javascript.
    - ContentHandler: redirect do captive portal usa WiFi.softAPIP() em vez do IP
    fixo 192.168.4.1 (fallback fixo quando !HAS_WIFI); include de WiFi.h sob HAS_WIFI.
    - ContentHandler: rota wildcard /*/*/*/*/* (5 niveis) p/ so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
    [ContentHandler.cpp, WebServer.cpp]
2026-09-27 fix(irrigation): roteamento unico do portal por estado + no-cache
    Nó recém-flasheado mostrava a tela de nó em vez do wizard de escolha de
    papel. O device estava correto (provisioned=false); a falha era na camada
    web:
    - sendJson e handleStatic não emitiam Cache-Control, então o browser servia
    app.js/index.html e respostas de /api/portal/node velhos do cache.
    - Dois entry points (painel do gateway e portal) sem roteamento por estado:
    uma URL manual caía no app errado pro papel do nó.
    Correções:
    - sendJson: Cache-Control: no-store (estado dinâmico nunca cacheia).
    - handleStatic: assets irrigacao* recebem Cache-Control: no-cache.
    - route.js novo: fonte única de navegação; cons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
    [ContentHandler.cpp, IrrigationEndpointHelpers.h]
2026-09-27 fix(irrigation): JSON inválido do portal (%lld não suportado pela libc nano)
    JsonWriter::num usava snprintf("%lld") para todo número. A libc "nano" do
    ESP32 não implementa long long em printf e emitia o literal "ld" no lugar
    do valor, ex.: {"role":ld,"numValves":ld,...}. JSON.parse estourava no
    browser, então route.js caía no catch (sem redirect) e o portal nunca
    chegava ao gate do wizard — aparecia sempre a tela de nó. É a causa raiz
    original do "wizard nunca aparece".
    Troca por conversão int64->decimal manual, independente da config de
    printf da toolchain. Cobre todos os endpoints (portal e painel do gateway)
    que serializam via JsonWriter.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
    [IrrigationWebApi.cpp]
2026-09-27 fix(irrigation): abre janela do portal no boot em todos os papeis
    Antes, só estação/repetidor provisionados (ou nó de fábrica) abriam o
    Portal AP no boot. Gateway e serviço provisionados não abriam — e numa
    placa sem botão (XIAO S3, pinBtn<0) não havia como reabrir, deixando o
    device inalcançável logo após escolher a função no wizard.
    Agora todo papel chama portal.requestOpen() no boot: janela de prazo
    determinado (PORTAL_TIMEOUT_MS, 10 min) que fecha por inatividade e
    reabre a cada reboot. O teardown de BLE na borda de fechamento continua
    restrito ao regime elegível (estação/repetidor) via AccessWindowPolicy.
    [IrrigationModule.cpp]
2026-09-27 fix(irrigation): stack overflow no boot do gateway (buffers de state no heap)
    Gateway provisionado entrava em bootloop (Guru Meditation: Double
    exception / Unhandled debug exception = canário de stack). load/
    saveGatewayState declaravam ~5 KB de buffers na stack (SERIALIZED_MAX
    3894 + zonas + programas + mirror), estourando a stack do loopTask no
    boot — antes mesmo de qualquer estado salvo existir (buffers alocados
    incondicionalmente). Era a real causa do "wifi não sobe" no papel
    Gateway (device reiniciava antes de subir o AP).
    Troca por um único buffer no heap (tamanho do maior bloco), reutilizado
    entre stations/zones/programs/mirror. Confirmado em hardware (XIAO S3):
    role=1 boota sem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
    [IrrigationModule.cpp]
2026-09-27 fix(irrigation): derruba BLE no gateway/servico quando o portal AP sobe
    WiFi e BLE dividem o radio 2.4 GHz no ESP32-S3; com o NimBLE advertising
    ativo junto do softAP do portal, a coexistencia deixava o AP instavel
    (portal pouco responsivo, abas com "load failed", desconexao frequente).
    Papeis com WiFi como interface principal (gateway/servico) agora derrubam
    o BLE assim que o portal AP sobe (deinit + release, sticky ate reboot),
    liberando o radio pro AP. Estacao/repetidor seguem derrubando na borda de
    fechamento da janela (comportamento existente).
    [IrrigationModule.cpp]
2026-09-27 fix(irrigation): buffers de handler HTTP fora da stack + JSON do log sem lixo
    Dois bugs que travavam o painel do gateway:
    1. Stack overflow do handler: hStations (char buf[8192]) e hSensors
    (char buf[4096]) na stack pequena da task do web server crashavam o
    processo ao abrir as abas Estações/Sensores ("load failed" + queda de
    WiFi). Movidos para buffers estáticos (handlers rodam single-thread,
    sem reentrância).
    2. Log/auditoria com "Unexpected non-whitespace after JSON": toJson/toCsv
    (hAudit) e buildPortalLog (hLog) devolvem N bytes SEM null-terminar; o
    envio por print()/strlen vazava lixo do heap após o JSON. hAudit passa
    a escrever por tamanho; hLog null-termina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
    [IrrigationPortalEndpoints.cpp, IrrigationWebEndpoints.cpp]
2026-09-27 feat(irrigation): janela BLE sob demanda (WiFi off / BLE on por N min)
    No ESP32-S3 WiFi e BLE dividem o radio 2.4 GHz; o gateway derruba o BLE
    enquanto o portal AP esta no ar. Para quando o operador precisa parear
    pelo app Meshtastic, adiciona uma janela BLE sob demanda.
    Botao na aba Mais/Sistema do painel (5/10/15 min) -> POST
    /api/irrigation/system/ble-window {minutes}. O device grava uma flag em
    RTC slow memory e reboota: sobe em modo BLE-only (portal AP nao abre, BLE
    nao e derrubado) por N min e, ao expirar, reboota sozinho de volta ao
    normal (WiFi/portal on, BLE off).
    Flag RTC consumida no boot (consumo unico) + zerada em power-on: perda de
    energia ou crash durante a janela volta ao m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
    [IrrigationModule.cpp, IrrigationModule.h, IrrigationWebEndpoints.cpp]
2026-09-27 fix(irrigation): janela BLE persiste flag no LittleFS (RTC não sobrevive ao reboot)
    A flag da janela BLE estava em RTC slow memory (RTC_DATA_ATTR), mas nesta
    placa a RTC não sobrevive ao esp_restart (bootCount reinicia a cada boot),
    então o device rebootava e voltava ao modo normal — WiFi nunca desligava
    nem o BLE ligava. Comprovado em bancada: endpoint responde {ok:true},
    device reboota, mas volta com WiFi.
    Move a flag para /prefs/ble_window.dat (LittleFS persiste de fato).
    Consumida (apagada) na leitura do boot → power-loss/crash volta ao normal
    (mesmo fail-safe de antes).
    [IrrigationModule.cpp]
2026-09-27 style(irrigation): botões da janela BLE sem emoji + espaçamento
    Remove o emoji e envolve os 3 botões (5/10/15 min) num flex com gap para
    não ficarem encavalados na aba Mais/Sistema.
